OPRobots/DragonBot2/source_code/.features/odometry/odometry_analysis.png

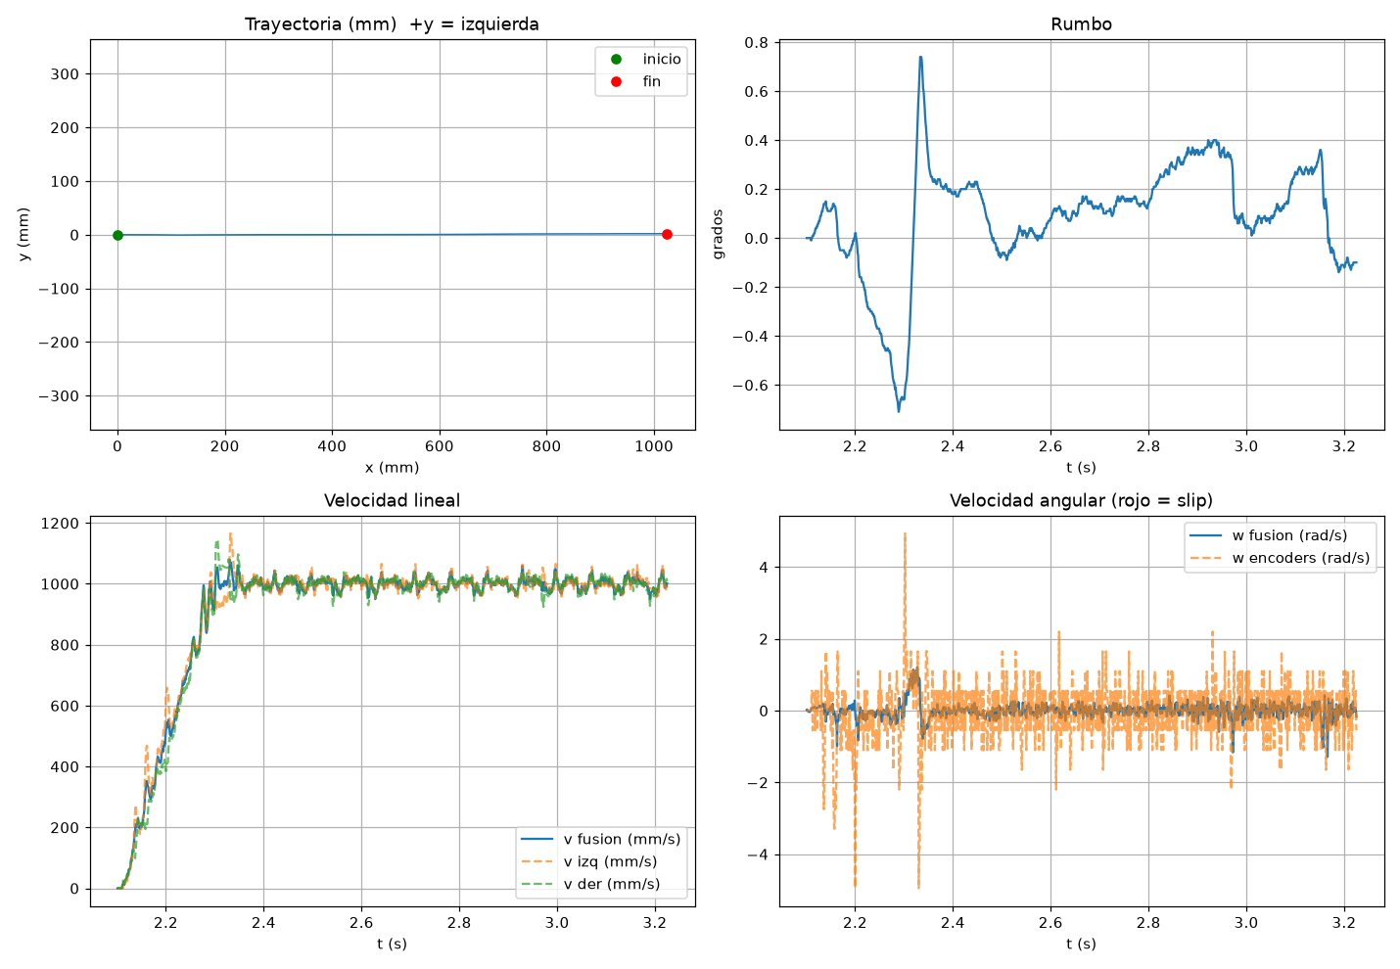
source_code/.features/odometry/odometry_analysis.png
