OPRobots/DragonBot2/pcb_files/kicad_project/main/Main-PCB.dxf

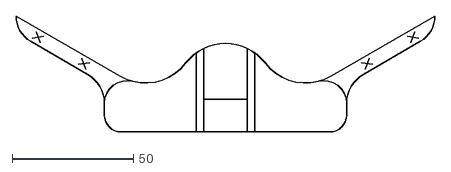
[picture p4: CAD file, 2026-01-10]
pcb_files/kicad_project/main/Main-PCB.dxf
172.8 x 47.7
