OPRobots/DragonBot2/source_code/.features/pid_tuning/calibrate_yaw_step.txt

YAWSTEP,57118,0,0,-0.00255
YAWSTEP,57119,0,0,0.00111
YAWSTEP,57120,0,0,0.00111
YAWSTEP,57121,0,0,-0.00011
YAWSTEP,57122,0,0,0.00111
YAWSTEP,57123,0,0,-0.00011
YAWSTEP,57124,0,0,-0.00011
YAWSTEP,57125,0,0,-0.00011
YAWSTEP,57126,0,0,0.00111
YAWSTEP,57127,0,0,-0.00133
YAWSTEP,57128,0,0,0.00111
YAWSTEP,57129,0,0,-0.00011
YAWSTEP,57130,0,0,0.00233
YAWSTEP,57131,0,0,-0.00011
YAWSTEP,57132,0,0,-0.00011
YAWSTEP,57133,0,0,-0.00011
YAWSTEP,57134,0,0,0.00111
YAWSTEP,57135,0,0,0.00111
YAWSTEP,57136,0,0,-0.00011
YAWSTEP,57137,0,0,-0.00011
YAWSTEP,57138,0,0,-0.00133
YAWSTEP,57139,0,0,-0.00133
YAWSTEP,57140,0,0,-0.00255
YAWSTEP,57141,0,0,-0.00255
YAWSTEP,57142,0,0,-0.00255
YAWSTEP,57143,0,0,-0.00255
YAWSTEP,57144,0,0,0.00111
YAWSTEP,57145,0,0,-0.00255
YAWSTEP,57146,0,0,-0.00011
YAWSTEP,57147,0,0,-0.00011
YAWSTEP,57148,0,0,-0.00011
YAWSTEP,57149,0,0,-0.00011
YAWSTEP,57150,0,0,-0.00011
YAWSTEP,57151,0,0,0.00356
YAWSTEP,57152,0,0,-0.00133
YAWSTEP,57153,0,0,-0.00133
YAWSTEP,57154,0,0,-0.00133
YAWSTEP,57155,0,0,-0.00011
YAWSTEP,57156,0,0,0.00233
YAWSTEP,57157,0,0,-0.00133
YAWSTEP,57158,0,0,-0.00011
YAWSTEP,57159,0,0,0.00233
YAWSTEP,57160,0,0,0.00111
YAWSTEP,57161,0,0,-0.00255
YAWSTEP,57162,0,0,-0.00255
YAWSTEP,57163,0,0,0.00111
YAWSTEP,57164,0,0,-0.00255
YAWSTEP,57165,0,0,-0.00255
YAWSTEP,57166,0,0,-0.00255
YAWSTEP,57167,0,0,0.00233
YAWSTEP,57168,0,100,0.00233
YAWSTEP,57169,0,100,0.00233
YAWSTEP,57170,0,100,0.15260
YAWSTEP,57171,0,100,-0.19069
YAWSTEP,57172,0,100,-0.68182
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
YAWSTEP,60309,2,100,-21.86722
YAWSTEP,60310,2,100,-21.82935
YAWSTEP,60311,2,100,-21.89776
YAWSTEP,60312,2,100,-21.57401
YAWSTEP,60313,2,100,-21.46039
YAWSTEP,60314,2,100,-21.74627
YAWSTEP,60315,2,100,-21.71451
YAWSTEP,60316,2,100,-21.57279
YAWSTEP,60317,2,100,-21.57279
