OPRobots/DragonBot2/source_code/.features/pid_tuning/linear_speed_control_fine_tuning_straight.txt

t=2701,target_linear_speed=2000,ideal_linear_speed=5,measured_linear_speed=0.00,left_measured_linear_speed=0.00,right_measured_linear_speed=0.00,ideal_angular_speed=0.00,measured_angular_speed=-0.04,pwm_left=3,pwm_right=3,battery_voltage=12.32
t=2702,target_linear_speed=2000,ideal_linear_speed=10,measured_linear_speed=0.00,left_measured_linear_speed=0.00,right_measured_linear_speed=0.00,ideal_angular_speed=0.00,measured_angular_speed=0.07,pwm_left=4,pwm_right=4,battery_voltage=12.32
t=2703,target_linear_speed=2000,ideal_linear_speed=15,measured_linear_speed=0.00,left_measured_linear_speed=0.00,right_measured_linear_speed=0.00,ideal_angular_speed=0.00,measured_angular_speed=0.02,pwm_left=6,pwm_right=6,battery_voltage=12.32
t=2704,target_linear_speed=2000,ideal_linear_speed=20,measured_linear_speed=0.00,left_measured_linear_speed=0.00,right_measured_linear_speed=0.00,ideal_angular_speed=0.00,measured_angular_speed=0.02,pwm_left=7,pwm_right=7,battery_voltage=12.32
t=2705,target_linear_speed=2000,ideal_linear_speed=25,measured_linear_speed=0.00,left_measured_linear_speed=0.00,right_measured_linear_speed=0.00,ideal_angular_speed=0.00,measured_angular_speed=0.02,pwm_left=9,pwm_right=9,battery_voltage=12.32
t=2706,target_linear_speed=2000,ideal_linear_speed=30,measured_linear_speed=0.00,left_measured_linear_speed=0.00,right_measured_linear_speed=0.00,ideal_angular_speed=0.00,measured_angular_speed=0.15,pwm_left=11,pwm_right=11,battery_voltage=12.32
t=2707,target_linear_speed=2000,ideal_linear_speed=35,measured_linear_speed=0.00,left_measured_linear_speed=0.00,right_measured_linear_speed=0.00,ideal_angular_speed=0.00,measured_angular_speed=-0.00,pwm_left=13,pwm_right=13,battery_voltage=12.32
t=2708,target_linear_speed=2000,ideal_linear_speed=40,measured_linear_speed=0.00,left_measured_linear_speed=0.00,right_measured_linear_speed=0.00,ideal_angular_speed=0.00,measured_angular_speed=0.01,pwm_left=15,pwm_right=15,battery_voltage=12.32
t=2709,target_linear_speed=2000,ideal_linear_speed=45,measured_linear_speed=0.00,left_measured_linear_speed=0.00,right_measured_linear_speed=0.00,ideal_angular_speed=0.00,measured_angular_speed=-0.10,pwm_left=17,pwm_right=17,battery_voltage=12.32
t=2710,target_linear_speed=2000,ideal_linear_speed=50,measured_linear_speed=0.00,left_measured_linear_speed=0.00,right_measured_linear_speed=0.00,ideal_angular_speed=0.00,measured_angular_speed=0.17,pwm_left=19,pwm_right=19,battery_voltage=12.32
t=2711,target_linear_speed=2000,ideal_linear_speed=55,measured_linear_speed=0.00,left_measured_linear_speed=0.00,right_measured_linear_speed=0.00,ideal_angular_speed=0.00,measured_angular_speed=-0.07,pwm_left=21,pwm_right=21,battery_voltage=12.32
t=2712,target_linear_speed=2000,ideal_linear_speed=60,measured_linear_speed=14.03,left_measured_linear_speed=14.03,right_measured_linear_speed=14.03,ideal_angular_speed=0.00,measured_angular_speed=-0.07,pwm_left=19,pwm_right=19,battery_voltage=12.32
t=2713,target_linear_speed=2000,ideal_linear_speed=65,measured_linear_speed=11.22,left_measured_linear_speed=11.22,right_measured_linear_speed=11.22,ideal_angular_speed=0.00,measured_angular_speed=0.10,pwm_left=22,pwm_right=22,battery_voltage=12.32
t=2714,target_linear_speed=2000,ideal_linear_speed=70,measured_linear_speed=15.99,left_measured_linear_speed=8.98,right_measured_linear_speed=23.01,ideal_angular_speed=0.00,measured_angular_speed=0.00,pwm_left=23,pwm_right=23,battery_voltage=12.32
t=2715,target_linear_speed=2000,ideal_linear_speed=75,measured_linear_speed=12.79,left_measured_linear_speed=7.18,right_measured_linear_speed=18.40,ideal_angular_speed=0.00,measured_angular_speed=0.14,pwm_left=26,pwm_right=26,battery_voltage=12.31
t=2716,target_linear_speed=2000,ideal_linear_speed=80,measured_linear_speed=10.23,left_measured_linear_speed=5.75,right_measured_linear_speed=14.72,ideal_angular_speed=0.00,measured_angular_speed=0.02,pwm_left=30,pwm_right=30,battery_voltage=12.31
t=2717,target_linear_speed=2000,ideal_linear_speed=85,measured_linear_speed=8.19,left_measured_linear_speed=4.60,right_measured_linear_speed=11.78,ideal_angular_speed=0.00,measured_angular_speed=0.05,pwm_left=33,pwm_right=33,battery_voltage=12.31
t=2718,target_linear_speed=2000,ideal_linear_speed=90,measured_linear_speed=13.56,left_measured_linear_speed=17.71,right_measured_linear_speed=9.42,ideal_angular_speed=0.00,measured_angular_speed=0.13,pwm_left=34,pwm_right=34,battery_voltage=12.31
t=2719,target_linear_speed=2000,ideal_linear_speed=95,measured_linear_speed=17.87,left_measured_linear_speed=14.16,right_measured_linear_speed=21.57,ideal_angular_speed=0.00,measured_angular_speed=0.12,pwm_left=35,pwm_right=35,battery_voltage=12.31
t=2720,target_linear_speed=2000,ideal_linear_speed=100,measured_linear_speed=28.32,left_measured_linear_speed=25.36,right_measured_linear_speed=31.28,ideal_angular_speed=0.00,measured_angular_speed=0.12,pwm_left=35,pwm_right=35,battery_voltage=12.31
t=2721,target_linear_speed=2000,ideal_linear_speed=105,measured_linear_speed=22.66,left_measured_linear_speed=20.29,right_measured_linear_speed=25.03,ideal_angular_speed=0.00,measured_angular_speed=-0.06,pwm_left=39,pwm_right=39,battery_voltage=12.31
t=2722,target_linear_speed=2000,ideal_linear_speed=110,measured_linear_speed=18.13,left_measured_linear_speed=16.23,right_measured_linear_speed=20.02,ideal_angular_speed=0.00,measured_angular_speed=0.00,pwm_left=43,pwm_right=43,battery_voltage=12.31
t=2723,target_linear_speed=2000,ideal_linear_speed=115,measured_linear_speed=28.53,left_measured_linear_speed=27.01,right_measured_linear_speed=30.04,ideal_angular_speed=0.00,measured_angular_speed=0.22,pwm_left=44,pwm_right=44,battery_voltage=12.30
t=2724,target_linear_speed=2000,ideal_linear_speed=120,measured_linear_speed=36.85,left_measured_linear_speed=35.64,right_measured_linear_speed=38.06,ideal_angular_speed=0.00,measured_angular_speed=-0.15,pwm_left=44,pwm_right=44,battery_voltage=12.30
t=2725,target_linear_speed=2000,ideal_linear_speed=125,measured_linear_speed=43.51,left_measured_linear_speed=42.54,right_measured_linear_speed=44.48,ideal_angular_speed=0.00,measured_angular_speed=0.06,pwm_left=45,pwm_right=45,battery_voltage=12.30
t=2726,target_linear_speed=2000,ideal_linear_speed=130,measured_linear_speed=41.82,left_measured_linear_speed=48.06,right_measured_linear_speed=35.58,ideal_angular_speed=0.00,measured_angular_speed=-0.07,pwm_left=48,pwm_right=48,battery_voltage=12.30
t=2727,target_linear_speed=2000,ideal_linear_speed=135,measured_linear_speed=40.47,left_measured_linear_speed=38.45,right_measured_linear_speed=42.49,ideal_angular_speed=0.00,measured_angular_speed=-0.07,pwm_left=52,pwm_right=52,battery_voltage=12.30
t=2728,target_linear_speed=2000,ideal_linear_speed=140,measured_linear_speed=53.42,left_measured_linear_speed=58.81,right_measured_linear_speed=48.02,ideal_angular_speed=0.00,measured_angular_speed=0.09,pwm_left=51,pwm_right=51,battery_voltage=12.30
t=2729,target_linear_speed=2000,ideal_linear_speed=145,measured_linear_speed=56.76,left_measured_linear_speed=61.08,right_measured_linear_speed=52.45,ideal_angular_speed=0.00,measured_angular_speed=-0.21,pwm_left=53,pwm_right=53,battery_voltage=12.29
t=2730,target_linear_speed=2000,ideal_linear_speed=150,measured_linear_speed=59.44,left_measured_linear_speed=62.89,right_measured_linear_speed=55.99,ideal_angular_speed=0.00,measured_angular_speed=-0.02,pwm_left=55,pwm_right=55,battery_voltage=12.29
t=2731,target_linear_speed=2000,ideal_linear_speed=155,measured_linear_speed=61.58,left_measured_linear_speed=64.34,right_measured_linear_speed=58.82,ideal_angular_speed=0.00,measured_angular_speed=-0.22,pwm_left=57,pwm_right=57,battery_voltage=12.29
t=2732,target_linear_speed=2000,ideal_linear_speed=160,measured_linear_speed=70.30,left_measured_linear_speed=65.50,right_measured_linear_speed=75.11,ideal_angular_speed=0.00,measured_angular_speed=-0.07,pwm_left=58,pwm_right=58,battery_voltage=12.29
t=2733,target_linear_speed=2000,ideal_linear_speed=165,measured_linear_speed=77.29,left_measured_linear_speed=80.46,right_measured_linear_speed=74.12,ideal_angular_speed=0.00,measured_angular_speed=-0.15,pwm_left=59,pwm_right=59,battery_voltage=12.29
t=2734,target_linear_speed=2000,ideal_linear_speed=170,measured_linear_speed=75.86,left_measured_linear_speed=78.39,right_measured_linear_speed=73.32,ideal_angular_speed=0.00,measured_angular_speed=0.01,pwm_left=62,pwm_right=62,battery_voltage=12.28
t=2735,target_linear_speed=2000,ideal_linear_speed=175,measured_linear_speed=81.73,left_measured_linear_speed=90.77,right_measured_linear_speed=72.68,ideal_angular_speed=0.00,measured_angular_speed=0.01,pwm_left=64,pwm_right=64,battery_voltage=12.28
t=2736,target_linear_speed=2000,ideal_linear_speed=180,measured_linear_speed=93.44,left_measured_linear_speed=100.67,right_measured_linear_speed=86.20,ideal_angular_speed=0.00,measured_angular_speed=-0.10,pwm_left=63,pwm_right=63,battery_voltage=12.28
t=2737,target_linear_speed=2000,ideal_linear_speed=185,measured_linear_speed=102.81,left_measured_linear_speed=108.59,right_measured_linear_speed=97.02,ideal_angular_speed=0.00,measured_angular_speed=-0.39,pwm_left=64,pwm_right=64,battery_voltage=12.28
t=2738,target_linear_speed=2000,ideal_linear_speed=190,measured_linear_speed=103.29,left_measured_linear_speed=100.90,right_measured_linear_speed=105.67,ideal_angular_speed=0.00,measured_angular_speed=-0.00,pwm_left=66,pwm_right=66,battery_voltage=12.27
t=2739,target_linear_speed=2000,ideal_linear_speed=195,measured_linear_speed=117.70,left_measured_linear_speed=122.81,right_measured_linear_speed=112.59,ideal_angular_speed=0.00,measured_angular_speed=-0.12,pwm_left=65,pwm_right=65,battery_voltage=12.27
t=2740,target_linear_speed=2000,ideal_linear_speed=200,measured_linear_speed=122.22,left_measured_linear_speed=126.30,right_measured_linear_speed=118.13,ideal_angular_speed=0.00,measured_angular_speed=0.31,pwm_left=67,pwm_right=67,battery_voltage=12.27
t=2741,target_linear_speed=2000,ideal_linear_speed=205,measured_linear_speed=125.83,left_measured_linear_speed=129.10,right_measured_linear_speed=122.56,ideal_angular_speed=0.00,measured_angular_speed=-0.27,pwm_left=68,pwm_right=68,battery_voltage=12.27
t=2742,target_linear_speed=2000,ideal_linear_speed=210,measured_linear_speed=135.73,left_measured_linear_speed=131.33,right_measured_linear_speed=140.13,ideal_angular_speed=0.00,measured_angular_speed=-0.27,pwm_left=68,pwm_right=68,battery_voltage=12.27
t=2743,target_linear_speed=2000,ideal_linear_speed=215,measured_linear_speed=143.66,left_measured_linear_speed=147.15,right_measured_linear_speed=140.16,ideal_angular_speed=0.00,measured_angular_speed=-0.04,pwm_left=69,pwm_right=69,battery_voltage=12.26
t=2744,target_linear_speed=2000,ideal_linear_speed=220,measured_linear_speed=157.01,left_measured_linear_speed=159.80,right_measured_linear_speed=154.21,ideal_angular_speed=0.00,measured_angular_speed=-0.23,pwm_left=68,pwm_right=68,battery_voltage=12.26
t=2745,target_linear_speed=2000,ideal_linear_speed=225,measured_linear_speed=160.68,left_measured_linear_speed=155.90,right_measured_linear_speed=165.45,ideal_angular_speed=0.00,measured_angular_speed=-0.11,pwm_left=69,pwm_right=69,battery_voltage=12.26
t=2746,target_linear_speed=2000,ideal_linear_speed=230,measured_linear_speed=163.61,left_measured_linear_speed=166.80,right_measured_linear_speed=160.42,ideal_angular_speed=0.00,measured_angular_speed=-0.16,pwm_left=71,pwm_right=71,battery_voltage=12.25
t=2747,target_linear_speed=2000,ideal_linear_speed=235,measured_linear_speed=179.99,left_measured_linear_speed=175.53,right_measured_linear_speed=184.45,ideal_angular_speed=0.00,measured_angular_speed=0.05,pwm_left=69,pwm_right=69,battery_voltage=12.25
t=2748,target_linear_speed=2000,ideal_linear_speed=240,measured_linear_speed=179.06,left_measured_linear_speed=182.51,right_measured_linear_speed=175.61,ideal_angular_speed=0.00,measured_angular_speed=-0.09,pwm_left=72,pwm_right=72,battery_voltage=12.25
t=2749,target_linear_speed=2000,ideal_linear_speed=245,measured_linear_speed=192.35,left_measured_linear_speed=188.09,right_measured_linear_speed=196.60,ideal_angular_speed=0.00,measured_angular_speed=-0.36,pwm_left=70,pwm_right=70,battery_voltage=12.25
t=2750,target_linear_speed=2000,ideal_linear_speed=250,measured_linear_speed=195.96,left_measured_linear_speed=192.55,right_measured_linear_speed=199.37,ideal_angular_speed=0.00,measured_angular_speed=-0.36,pwm_left=72,pwm_right=72,battery_voltage=12.25
t=2751,target_linear_speed=2000,ideal_linear_speed=255,measured_linear_speed=205.87,left_measured_linear_speed=210.16,right_measured_linear_speed=201.58,ideal_angular_speed=0.00,measured_angular_speed=0.04,pwm_left=71,pwm_right=71,battery_voltage=12.25
t=2752,target_linear_speed=2000,ideal_linear_speed=260,measured_linear_speed=206.78,left_measured_linear_speed=210.21,right_measured_linear_speed=203.35,ideal_angular_speed=0.00,measured_angular_speed=-0.01,pwm_left=73,pwm_right=73,battery_voltage=12.25
t=2753,target_linear_speed=2000,ideal_linear_speed=265,measured_linear_speed=221.53,left_measured_linear_speed=224.28,right_measured_linear_speed=218.79,ideal_angular_speed=0.00,measured_angular_speed=0.31,pwm_left=72,pwm_right=72,battery_voltage=12.25
t=2754,target_linear_speed=2000,ideal_linear_speed=270,measured_linear_speed=226.33,left_measured_linear_speed=235.54,right_measured_linear_speed=217.11,ideal_angular_speed=0.00,measured_angular_speed=-0.27,pwm_left=72,pwm_right=72,battery_voltage=12.25
t=2755,target_linear_speed=2000,ideal_linear_speed=275,measured_linear_speed=237.17,left_measured_linear_speed=230.51,right_measured_linear_speed=243.83,ideal_angular_speed=0.00,measured_angular_speed=0.03,pwm_left=71,pwm_right=71,battery_voltage=12.25
t=2756,target_linear_speed=2000,ideal_linear_speed=280,measured_linear_speed=238.84,left_measured_linear_speed=240.52,right_measured_linear_speed=237.15,ideal_angular_speed=0.00,measured_angular_speed=-0.38,pwm_left=73,pwm_right=73,battery_voltage=12.24
t=2757,target_linear_speed=2000,ideal_linear_speed=285,measured_linear_speed=254.19,left_measured_linear_speed=248.53,right_measured_linear_speed=259.86,ideal_angular_speed=0.00,measured_angular_speed=-0.38,pwm_left=71,pwm_right=71,battery_voltage=12.24
t=2758,target_linear_speed=2000,ideal_linear_speed=290,measured_linear_speed=266.48,left_measured_linear_speed=268.96,right_measured_linear_speed=264.00,ideal_angular_speed=0.00,measured_angular_speed=0.25,pwm_left=69,pwm_right=69,battery_voltage=12.24
t=2759,target_linear_speed=2000,ideal_linear_speed=295,measured_linear_speed=255.27,left_measured_linear_speed=243.23,right_measured_linear_speed=267.31,ideal_angular_speed=0.00,measured_angular_speed=0.01,pwm_left=74,pwm_right=74,battery_voltage=12.24
t=2760,target_linear_speed=2000,ideal_linear_speed=300,measured_linear_speed=274.36,left_measured_linear_speed=278.75,right_measured_linear_speed=269.96,ideal_angular_speed=0.00,measured_angular_speed=-0.18,pwm_left=71,pwm_right=71,battery_voltage=12.24
t=2761,target_linear_speed=2000,ideal_linear_speed=305,measured_linear_speed=282.61,left_measured_linear_speed=279.11,right_measured_linear_speed=286.11,ideal_angular_speed=0.00,measured_angular_speed=-0.23,pwm_left=71,pwm_right=71,battery_voltage=12.24
t=2762,target_linear_speed=2000,ideal_linear_speed=310,measured_linear_speed=296.23,left_measured_linear_speed=293.43,right_measured_linear_speed=299.03,ideal_angular_speed=0.00,measured_angular_speed=-0.22,pwm_left=69,pwm_right=69,battery_voltage=12.24
t=2763,target_linear_speed=2000,ideal_linear_speed=315,measured_linear_speed=293.09,left_measured_linear_speed=290.86,right_measured_linear_speed=295.33,ideal_angular_speed=0.00,measured_angular_speed=0.36,pwm_left=71,pwm_right=71,battery_voltage=12.24
t=2764,target_linear_speed=2000,ideal_linear_speed=320,measured_linear_speed=304.62,left_measured_linear_speed=302.82,right_measured_linear_speed=306.41,ideal_angular_speed=0.00,measured_angular_speed=0.36,pwm_left=70,pwm_right=70,battery_voltage=12.24
t=2765,target_linear_speed=2000,ideal_linear_speed=325,measured_linear_speed=299.80,left_measured_linear_speed=298.37,right_measured_linear_speed=301.24,ideal_angular_speed=0.00,measured_angular_speed=-0.38,pwm_left=73,pwm_right=73,battery_voltage=12.24
t=2766,target_linear_speed=2000,ideal_linear_speed=330,measured_linear_speed=317.00,left_measured_linear_speed=308.84,right_measured_linear_speed=325.16,ideal_angular_speed=0.00,measured_angular_speed=-0.01,pwm_left=70,pwm_right=70,battery_voltage=12.24
t=2767,target_linear_speed=2000,ideal_linear_speed=335,measured_linear_speed=323.74,left_measured_linear_speed=331.24,right_measured_linear_speed=316.24,ideal_angular_speed=0.00,measured_angular_speed=-0.32,pwm_left=70,pwm_right=70,battery_voltage=12.25
t=2768,target_linear_speed=2000,ideal_linear_speed=340,measured_linear_speed=322.12,left_measured_linear_speed=321.10,right_measured_linear_speed=323.13,ideal_angular_speed=0.00,measured_angular_speed=0.04,pwm_left=72,pwm_right=72,battery_voltage=12.24
t=2769,target_linear_speed=2000,ideal_linear_speed=345,measured_linear_speed=334.85,left_measured_linear_speed=341.05,right_measured_linear_speed=328.64,ideal_angular_speed=0.00,measured_angular_speed=-0.03,pwm_left=70,pwm_right=70,battery_voltage=12.24
t=2770,target_linear_speed=2000,ideal_linear_speed=350,measured_linear_speed=338.02,left_measured_linear_speed=342.98,right_measured_linear_speed=333.06,ideal_angular_speed=0.00,measured_angular_speed=0.34,pwm_left=70,pwm_right=70,battery_voltage=12.25
t=2771,target_linear_speed=2000,ideal_linear_speed=355,measured_linear_speed=347.57,left_measured_linear_speed=358.55,right_measured_linear_speed=336.58,ideal_angular_speed=0.00,measured_angular_speed=-0.17,pwm_left=69,pwm_right=69,battery_voltage=12.24
t=2772,target_linear_speed=2000,ideal_linear_speed=360,measured_linear_speed=362.22,left_measured_linear_speed=371.01,right_measured_linear_speed=353.44,ideal_angular_speed=0.00,measured_angular_speed=-0.17,pwm_left=67,pwm_right=67,battery_voltage=12.24
t=2773,target_linear_speed=2000,ideal_linear_speed=365,measured_linear_speed=373.95,left_measured_linear_speed=380.98,right_measured_linear_speed=366.92,ideal_angular_speed=0.00,measured_angular_speed=-0.34,pwm_left=65,pwm_right=65,battery_voltage=12.24
t=2774,target_linear_speed=2000,ideal_linear_speed=370,measured_linear_speed=369.30,left_measured_linear_speed=374.92,right_measured_linear_speed=363.67,ideal_angular_speed=0.00,measured_angular_speed=0.15,pwm_left=67,pwm_right=67,battery_voltage=12.24
t=2775,target_linear_speed=2000,ideal_linear_speed=375,measured_linear_speed=379.61,left_measured_linear_speed=384.10,right_measured_linear_speed=375.11,ideal_angular_speed=0.00,measured_angular_speed=-0.18,pwm_left=66,pwm_right=66,battery_voltage=12.24
t=2776,target_linear_speed=2000,ideal_linear_speed=380,measured_linear_speed=380.84,left_measured_linear_speed=391.45,right_measured_linear_speed=370.23,ideal_angular_speed=0.00,measured_angular_speed=0.13,pwm_left=67,pwm_right=67,battery_voltage=12.25
t=2777,target_linear_speed=2000,ideal_linear_speed=385,measured_linear_speed=388.84,left_measured_linear_speed=397.33,right_measured_linear_speed=380.35,ideal_angular_speed=0.00,measured_angular_speed=-0.48,pwm_left=66,pwm_right=66,battery_voltage=12.25
t=2778,target_linear_speed=2000,ideal_linear_speed=390,measured_linear_speed=381.21,left_measured_linear_speed=402.03,right_measured_linear_speed=360.39,ideal_angular_speed=0.00,measured_angular_speed=-0.13,pwm_left=69,pwm_right=69,battery_voltage=12.25
t=2779,target_linear_speed=2000,ideal_linear_speed=395,measured_linear_speed=403.16,left_measured_linear_speed=419.82,right_measured_linear_speed=386.51,ideal_angular_speed=0.00,measured_angular_speed=-0.13,pwm_left=65,pwm_right=65,battery_voltage=12.25
t=2780,target_linear_speed=2000,ideal_linear_speed=400,measured_linear_speed=392.67,left_measured_linear_speed=406.00,right_measured_linear_speed=379.35,ideal_angular_speed=0.00,measured_angular_speed=-0.34,pwm_left=69,pwm_right=69,battery_voltage=12.25
t=2781,target_linear_speed=2000,ideal_linear_speed=405,measured_linear_speed=398.31,left_measured_linear_speed=408.97,right_measured_linear_speed=387.65,ideal_angular_speed=0.00,measured_angular_speed=0.09,pwm_left=69,pwm_right=69,battery_voltage=12.25
t=2782,target_linear_speed=2000,ideal_linear_speed=410,measured_linear_speed=402.81,left_measured_linear_speed=411.34,right_measured_linear_speed=394.28,ideal_angular_speed=0.00,measured_angular_speed=-0.40,pwm_left=69,pwm_right=69,battery_voltage=12.25
t=2783,target_linear_speed=2000,ideal_linear_speed=415,measured_linear_speed=413.43,left_measured_linear_speed=427.27,right_measured_linear_speed=399.60,ideal_angular_speed=0.00,measured_angular_speed=-0.02,pwm_left=68,pwm_right=68,battery_voltage=12.25
t=2784,target_linear_speed=2000,ideal_linear_speed=420,measured_linear_speed=421.93,left_measured_linear_speed=440.01,right_measured_linear_speed=403.84,ideal_angular_speed=0.00,measured_angular_speed=-0.12,pwm_left=67,pwm_right=67,battery_voltage=12.25
t=2785,target_linear_speed=2000,ideal_linear_speed=425,measured_linear_speed=421.71,left_measured_linear_speed=436.18,right_measured_linear_speed=407.24,ideal_angular_speed=0.00,measured_angular_speed=-0.17,pwm_left=68,pwm_right=68,battery_voltage=12.25
t=2786,target_linear_speed=2000,ideal_linear_speed=430,measured_linear_speed=428.55,left_measured_linear_speed=447.14,right_measured_linear_speed=409.96,ideal_angular_speed=0.00,measured_angular_speed=0.41,pwm_left=68,pwm_right=68,battery_voltage=12.25
t=2787,target_linear_speed=2000,ideal_linear_speed=435,measured_linear_speed=434.02,left_measured_linear_speed=441.88,right_measured_linear_speed=426.17,ideal_angular_speed=0.00,measured_angular_speed=0.41,pwm_left=68,pwm_right=68,battery_voltage=12.25
t=2788,target_linear_speed=2000,ideal_linear_speed=440,measured_linear_speed=445.41,left_measured_linear_speed=465.73,right_measured_linear_speed=425.10,ideal_angular_speed=0.00,measured_angular_speed=-0.46,pwm_left=66,pwm_right=66,battery_voltage=12.25
t=2789,target_linear_speed=2000,ideal_linear_speed=445,measured_linear_speed=447.51,left_measured_linear_speed=456.75,right_measured_linear_speed=438.28,ideal_angular_speed=0.00,measured_angular_speed=-0.21,pwm_left=67,pwm_right=67,battery_voltage=12.25
t=2790,target_linear_speed=2000,ideal_linear_speed=450,measured_linear_speed=449.19,left_measured_linear_speed=463.60,right_measured_linear_speed=434.79,ideal_angular_speed=0.00,measured_angular_speed=-0.63,pwm_left=68,pwm_right=68,battery_voltage=12.25
t=2791,target_linear_speed=2000,ideal_linear_speed=455,measured_linear_speed=450.54,left_measured_linear_speed=455.04,right_measured_linear_speed=446.03,ideal_angular_speed=0.00,measured_angular_speed=-0.05,pwm_left=69,pwm_right=69,battery_voltage=12.25
t=2792,target_linear_speed=2000,ideal_linear_speed=460,measured_linear_speed=458.62,left_measured_linear_speed=462.23,right_measured_linear_speed=455.02,ideal_angular_speed=0.00,measured_angular_speed=-0.26,pwm_left=68,pwm_right=68,battery_voltage=12.25
t=2793,target_linear_speed=2000,ideal_linear_speed=465,measured_linear_speed=465.10,left_measured_linear_speed=467.98,right_measured_linear_speed=462.21,ideal_angular_speed=0.00,measured_angular_speed=0.18,pwm_left=67,pwm_right=67,battery_voltage=12.25
t=2794,target_linear_speed=2000,ideal_linear_speed=470,measured_linear_speed=477.29,left_measured_linear_speed=472.58,right_measured_linear_speed=481.99,ideal_angular_speed=0.00,measured_angular_speed=0.18,pwm_left=66,pwm_right=66,battery_voltage=12.25
t=2795,target_linear_speed=2000,ideal_linear_speed=475,measured_linear_speed=487.04,left_measured_linear_speed=476.26,right_measured_linear_speed=497.82,ideal_angular_speed=0.00,measured_angular_speed=0.47,pwm_left=64,pwm_right=64,battery_voltage=12.25
t=2796,target_linear_speed=2000,ideal_linear_speed=480,measured_linear_speed=494.84,left_measured_linear_speed=493.23,right_measured_linear_speed=496.45,ideal_angular_speed=0.00,measured_angular_speed=-0.55,pwm_left=63,pwm_right=63,battery_voltage=12.25
t=2797,target_linear_speed=2000,ideal_linear_speed=485,measured_linear_speed=508.10,left_measured_linear_speed=506.81,right_measured_linear_speed=509.38,ideal_angular_speed=0.00,measured_angular_speed=0.33,pwm_left=61,pwm_right=61,battery_voltage=12.25
t=2798,target_linear_speed=2000,ideal_linear_speed=490,measured_linear_speed=497.66,left_measured_linear_speed=503.64,right_measured_linear_speed=491.68,ideal_angular_speed=0.00,measured_angular_speed=0.10,pwm_left=64,pwm_right=64,battery_voltage=12.25
t=2799,target_linear_speed=2000,ideal_linear_speed=495,measured_linear_speed=503.34,left_measured_linear_speed=501.11,right_measured_linear_speed=505.56,ideal_angular_speed=0.00,measured_angular_speed=0.47,pwm_left=64,pwm_right=64,battery_voltage=12.25
t=2800,target_linear_speed=2000,ideal_linear_speed=500,measured_linear_speed=514.89,left_measured_linear_speed=513.11,right_measured_linear_speed=516.68,ideal_angular_speed=0.00,measured_angular_speed=-0.13,pwm_left=62,pwm_right=62,battery_voltage=12.25
t=2801,target_linear_speed=2000,ideal_linear_speed=505,measured_linear_speed=503.10,left_measured_linear_speed=494.66,right_measured_linear_speed=511.54,ideal_angular_speed=0.00,measured_angular_speed=0.29,pwm_left=67,pwm_right=67,battery_voltage=12.25
t=2802,target_linear_speed=2000,ideal_linear_speed=510,measured_linear_speed=514.70,left_measured_linear_speed=521.98,right_measured_linear_speed=507.43,ideal_angular_speed=0.00,measured_angular_speed=0.29,pwm_left=65,pwm_right=65,battery_voltage=12.25
t=2803,target_linear_speed=2000,ideal_linear_speed=515,measured_linear_speed=516.97,left_measured_linear_speed=515.78,right_measured_linear_speed=518.16,ideal_angular_speed=0.00,measured_angular_speed=0.25,pwm_left=65,pwm_right=65,battery_voltage=12.25
t=2804,target_linear_speed=2000,ideal_linear_speed=520,measured_linear_speed=525.80,left_measured_linear_speed=524.85,right_measured_linear_speed=526.76,ideal_angular_speed=0.00,measured_angular_speed=0.31,pwm_left=64,pwm_right=64,battery_voltage=12.25
t=2805,target_linear_speed=2000,ideal_linear_speed=525,measured_linear_speed=532.86,left_measured_linear_speed=532.10,right_measured_linear_speed=533.63,ideal_angular_speed=0.00,measured_angular_speed=0.04,pwm_left=64,pwm_right=64,battery_voltage=12.25
t=2806,target_linear_speed=2000,ideal_linear_speed=530,measured_linear_speed=531.50,left_measured_linear_speed=537.91,right_measured_linear_speed=525.10,ideal_angular_speed=0.00,measured_angular_speed=-0.14,pwm_left=65,pwm_right=65,battery_voltage=12.25
t=2807,target_linear_speed=2000,ideal_linear_speed=535,measured_linear_speed=530.41,left_measured_linear_speed=528.52,right_measured_linear_speed=532.30,ideal_angular_speed=0.00,measured_angular_speed=0.44,pwm_left=67,pwm_right=67,battery_voltage=12.25
t=2808,target_linear_speed=2000,ideal_linear_speed=540,measured_linear_speed=529.54,left_measured_linear_speed=535.04,right_measured_linear_speed=524.04,ideal_angular_speed=0.00,measured_angular_speed=-0.38,pwm_left=69,pwm_right=69,battery_voltage=12.26
t=2809,target_linear_speed=2000,ideal_linear_speed=545,measured_linear_speed=542.87,left_measured_linear_speed=540.26,right_measured_linear_speed=545.48,ideal_angular_speed=0.00,measured_angular_speed=-0.38,pwm_left=66,pwm_right=66,battery_voltage=12.26
t=2810,target_linear_speed=2000,ideal_linear_speed=550,measured_linear_speed=546.52,left_measured_linear_speed=558.46,right_measured_linear_speed=534.58,ideal_angular_speed=0.00,measured_angular_speed=0.18,pwm_left=67,pwm_right=67,battery_voltage=12.26
t=2811,target_linear_speed=2000,ideal_linear_speed=555,measured_linear_speed=549.44,left_measured_linear_speed=544.96,right_measured_linear_speed=553.92,ideal_angular_speed=0.00,measured_angular_speed=-0.09,pwm_left=68,pwm_right=68,battery_voltage=12.26
t=2812,target_linear_speed=2000,ideal_linear_speed=560,measured_linear_speed=558.79,left_measured_linear_speed=576.25,right_measured_linear_speed=541.33,ideal_angular_speed=0.00,measured_angular_speed=0.12,pwm_left=66,pwm_right=66,battery_voltage=12.26
t=2813,target_linear_speed=2000,ideal_linear_speed=565,measured_linear_speed=559.26,left_measured_linear_speed=559.20,right_measured_linear_speed=559.32,ideal_angular_speed=0.00,measured_angular_speed=-0.19,pwm_left=68,pwm_right=68,battery_voltage=12.25
t=2814,target_linear_speed=2000,ideal_linear_speed=570,measured_linear_speed=559.63,left_measured_linear_speed=573.61,right_measured_linear_speed=545.65,ideal_angular_speed=0.00,measured_angular_speed=-0.14,pwm_left=69,pwm_right=69,battery_voltage=12.25
t=2815,target_linear_speed=2000,ideal_linear_speed=575,measured_linear_speed=559.93,left_measured_linear_speed=557.08,right_measured_linear_speed=562.77,ideal_angular_speed=0.00,measured_angular_speed=-0.13,pwm_left=71,pwm_right=71,battery_voltage=12.25
t=2816,target_linear_speed=2000,ideal_linear_speed=580,measured_linear_speed=553.15,left_measured_linear_speed=557.89,right_measured_linear_speed=548.41,ideal_angular_speed=0.00,measured_angular_speed=-0.47,pwm_left=74,pwm_right=74,battery_voltage=12.25
t=2817,target_linear_speed=2000,ideal_linear_speed=585,measured_linear_speed=561.76,left_measured_linear_speed=558.54,right_measured_linear_speed=564.98,ideal_angular_speed=0.00,measured_angular_speed=-0.47,pwm_left=73,pwm_right=73,battery_voltage=12.25
t=2818,target_linear_speed=2000,ideal_linear_speed=590,measured_linear_speed=561.63,left_measured_linear_speed=559.05,right_measured_linear_speed=564.21,ideal_angular_speed=0.00,measured_angular_speed=0.31,pwm_left=75,pwm_right=75,battery_voltage=12.25
t=2819,target_linear_speed=2000,ideal_linear_speed=595,measured_linear_speed=568.54,left_measured_linear_speed=573.49,right_measured_linear_speed=563.59,ideal_angular_speed=0.00,measured_angular_speed=-0.10,pwm_left=75,pwm_right=75,battery_voltage=12.25
t=2820,target_linear_speed=2000,ideal_linear_speed=600,measured_linear_speed=574.07,left_measured_linear_speed=556.99,right_measured_linear_speed=591.15,ideal_angular_speed=0.00,measured_angular_speed=0.15,pwm_left=76,pwm_right=76,battery_voltage=12.25
t=2821,target_linear_speed=2000,ideal_linear_speed=605,measured_linear_speed=571.48,left_measured_linear_speed=557.82,right_measured_linear_speed=585.15,ideal_angular_speed=0.00,measured_angular_speed=-0.09,pwm_left=78,pwm_right=78,battery_voltage=12.25
t=2822,target_linear_speed=2000,ideal_linear_speed=610,measured_linear_speed=583.44,left_measured_linear_speed=558.48,right_measured_linear_speed=608.40,ideal_angular_speed=0.00,measured_angular_speed=0.10,pwm_left=77,pwm_right=77,battery_voltage=12.24
t=2823,target_linear_speed=2000,ideal_linear_speed=615,measured_linear_speed=585.99,left_measured_linear_speed=573.03,right_measured_linear_speed=598.94,ideal_angular_speed=0.00,measured_angular_speed=0.40,pwm_left=78,pwm_right=78,battery_voltage=12.24
t=2824,target_linear_speed=2000,ideal_linear_speed=620,measured_linear_speed=595.04,left_measured_linear_speed=584.68,right_measured_linear_speed=605.41,ideal_angular_speed=0.00,measured_angular_speed=0.40,pwm_left=77,pwm_right=77,battery_voltage=12.24
t=2825,target_linear_speed=2000,ideal_linear_speed=625,measured_linear_speed=595.27,left_measured_linear_speed=594.00,right_measured_linear_speed=596.55,ideal_angular_speed=0.00,measured_angular_speed=-0.22,pwm_left=79,pwm_right=79,battery_voltage=12.24
t=2826,target_linear_speed=2000,ideal_linear_speed=630,measured_linear_speed=609.48,left_measured_linear_speed=587.42,right_measured_linear_speed=631.55,ideal_angular_speed=0.00,measured_angular_speed=0.10,pwm_left=77,pwm_right=77,battery_voltage=12.24
t=2827,target_linear_speed=2000,ideal_linear_speed=635,measured_linear_speed=613.84,left_measured_linear_speed=610.22,right_measured_linear_speed=617.46,ideal_angular_speed=0.00,measured_angular_speed=0.17,pwm_left=78,pwm_right=78,battery_voltage=12.24
t=2828,target_linear_speed=2000,ideal_linear_speed=640,measured_linear_speed=624.34,left_measured_linear_speed=600.40,right_measured_linear_speed=648.28,ideal_angular_speed=0.00,measured_angular_speed=0.79,pwm_left=76,pwm_right=76,battery_voltage=12.24
t=2829,target_linear_speed=2000,ideal_linear_speed=645,measured_linear_speed=611.69,left_measured_linear_speed=606.57,right_measured_linear_speed=616.82,ideal_angular_speed=0.00,measured_angular_speed=0.30,pwm_left=82,pwm_right=82,battery_voltage=12.24
t=2830,target_linear_speed=2000,ideal_linear_speed=650,measured_linear_speed=629.64,left_measured_linear_speed=611.51,right_measured_linear_speed=647.76,ideal_angular_speed=0.00,measured_angular_speed=0.11,pwm_left=79,pwm_right=79,battery_voltage=12.24
t=2831,target_linear_speed=2000,ideal_linear_speed=655,measured_linear_speed=629.96,left_measured_linear_speed=629.49,right_measured_linear_speed=630.43,ideal_angular_speed=0.00,measured_angular_speed=0.11,pwm_left=80,pwm_right=80,battery_voltage=12.24
t=2832,target_linear_speed=2000,ideal_linear_speed=660,measured_linear_speed=637.23,left_measured_linear_speed=615.81,right_measured_linear_speed=658.66,ideal_angular_speed=0.00,measured_angular_speed=0.23,pwm_left=80,pwm_right=80,battery_voltage=12.24
t=2833,target_linear_speed=2000,ideal_linear_speed=665,measured_linear_speed=629.03,left_measured_linear_speed=618.90,right_measured_linear_speed=639.15,ideal_angular_speed=0.00,measured_angular_speed=0.46,pwm_left=84,pwm_right=84,battery_voltage=12.24
t=2834,target_linear_speed=2000,ideal_linear_speed=670,measured_linear_speed=650.51,left_measured_linear_speed=635.40,right_measured_linear_speed=665.63,ideal_angular_speed=0.00,measured_angular_speed=0.57,pwm_left=80,pwm_right=80,battery_voltage=12.24
t=2835,target_linear_speed=2000,ideal_linear_speed=675,measured_linear_speed=646.66,left_measured_linear_speed=634.57,right_measured_linear_speed=658.75,ideal_angular_speed=0.00,measured_angular_speed=-0.03,pwm_left=83,pwm_right=83,battery_voltage=12.24
t=2836,target_linear_speed=2000,ideal_linear_speed=680,measured_linear_speed=664.62,left_measured_linear_speed=647.94,right_measured_linear_speed=681.31,ideal_angular_speed=0.00,measured_angular_speed=0.56,pwm_left=80,pwm_right=80,battery_voltage=12.24
t=2837,target_linear_speed=2000,ideal_linear_speed=685,measured_linear_speed=664.97,left_measured_linear_speed=658.63,right_measured_linear_speed=671.30,ideal_angular_speed=0.00,measured_angular_speed=0.12,pwm_left=81,pwm_right=81,battery_voltage=12.23
t=2838,target_linear_speed=2000,ideal_linear_speed=690,measured_linear_speed=658.22,left_measured_linear_speed=639.13,right_measured_linear_speed=677.32,ideal_angular_speed=0.00,measured_angular_speed=0.50,pwm_left=85,pwm_right=85,battery_voltage=12.24
t=2839,target_linear_speed=2000,ideal_linear_speed=695,measured_linear_speed=673.87,left_measured_linear_speed=651.58,right_measured_linear_speed=696.16,ideal_angular_speed=0.00,measured_angular_speed=0.50,pwm_left=83,pwm_right=83,battery_voltage=12.23
t=2840,target_linear_speed=2000,ideal_linear_speed=700,measured_linear_speed=686.39,left_measured_linear_speed=661.55,right_measured_linear_speed=711.24,ideal_angular_speed=0.00,measured_angular_speed=0.34,pwm_left=81,pwm_right=81,battery_voltage=12.23
t=2841,target_linear_speed=2000,ideal_linear_speed=705,measured_linear_speed=689.39,left_measured_linear_speed=683.55,right_measured_linear_speed=695.24,ideal_angular_speed=0.00,measured_angular_speed=0.39,pwm_left=82,pwm_right=82,battery_voltage=12.23
t=2842,target_linear_speed=2000,ideal_linear_speed=710,measured_linear_speed=691.80,left_measured_linear_speed=673.09,right_measured_linear_speed=710.50,ideal_angular_speed=0.00,measured_angular_speed=0.61,pwm_left=83,pwm_right=83,battery_voltage=12.23
t=2843,target_linear_speed=2000,ideal_linear_speed=715,measured_linear_speed=693.72,left_measured_linear_speed=678.75,right_measured_linear_speed=708.68,ideal_angular_speed=0.00,measured_angular_speed=-0.29,pwm_left=84,pwm_right=84,battery_voltage=12.23
t=2844,target_linear_speed=2000,ideal_linear_speed=720,measured_linear_speed=695.25,left_measured_linear_speed=669.25,right_measured_linear_speed=721.25,ideal_angular_speed=0.00,measured_angular_speed=0.58,pwm_left=85,pwm_right=85,battery_voltage=12.23
t=2845,target_linear_speed=2000,ideal_linear_speed=725,measured_linear_speed=689.47,left_measured_linear_speed=675.68,right_measured_linear_speed=703.26,ideal_angular_speed=0.00,measured_angular_speed=-0.03,pwm_left=89,pwm_right=89,battery_voltage=12.22
t=2846,target_linear_speed=2000,ideal_linear_speed=730,measured_linear_speed=698.87,left_measured_linear_speed=680.83,right_measured_linear_speed=716.91,ideal_angular_speed=0.00,measured_angular_speed=-0.03,pwm_left=88,pwm_right=88,battery_voltage=12.22
t=2847,target_linear_speed=2000,ideal_linear_speed=735,measured_linear_speed=706.39,left_measured_linear_speed=684.94,right_measured_linear_speed=727.84,ideal_angular_speed=0.00,measured_angular_speed=0.23,pwm_left=88,pwm_right=88,battery_voltage=12.22
t=2848,target_linear_speed=2000,ideal_linear_speed=740,measured_linear_speed=705.39,left_measured_linear_speed=688.23,right_measured_linear_speed=722.55,ideal_angular_speed=0.00,measured_angular_speed=0.57,pwm_left=90,pwm_right=90,battery_voltage=12.22
t=2849,target_linear_speed=2000,ideal_linear_speed=745,measured_linear_speed=711.61,left_measured_linear_speed=704.89,right_measured_linear_speed=718.32,ideal_angular_speed=0.00,measured_angular_speed=0.42,pwm_left=90,pwm_right=90,battery_voltage=12.22
t=2850,target_linear_speed=2000,ideal_linear_speed=750,measured_linear_speed=709.57,left_measured_linear_speed=704.20,right_measured_linear_speed=714.94,ideal_angular_speed=0.00,measured_angular_speed=0.20,pwm_left=93,pwm_right=93,battery_voltage=12.22
t=2851,target_linear_speed=2000,ideal_linear_speed=755,measured_linear_speed=728.97,left_measured_linear_speed=717.66,right_measured_linear_speed=740.28,ideal_angular_speed=0.00,measured_angular_speed=-0.01,pwm_left=89,pwm_right=89,battery_voltage=12.22
t=2852,target_linear_speed=2000,ideal_linear_speed=760,measured_linear_speed=730.47,left_measured_linear_speed=714.41,right_measured_linear_speed=746.54,ideal_angular_speed=0.00,measured_angular_speed=0.66,pwm_left=91,pwm_right=91,battery_voltage=12.22
t=2853,target_linear_speed=2000,ideal_linear_speed=765,measured_linear_speed=731.67,left_measured_linear_speed=725.84,right_measured_linear_speed=737.51,ideal_angular_speed=0.00,measured_angular_speed=-0.45,pwm_left=92,pwm_right=92,battery_voltage=12.22
t=2854,target_linear_speed=2000,ideal_linear_speed=770,measured_linear_speed=739.65,left_measured_linear_speed=734.98,right_measured_linear_speed=744.31,ideal_angular_speed=0.00,measured_angular_speed=-0.45,pwm_left=92,pwm_right=92,battery_voltage=12.22
t=2855,target_linear_speed=2000,ideal_linear_speed=775,measured_linear_speed=739.01,left_measured_linear_speed=728.26,right_measured_linear_speed=749.76,ideal_angular_speed=0.00,measured_angular_speed=-0.12,pwm_left=94,pwm_right=94,battery_voltage=12.22
t=2856,target_linear_speed=2000,ideal_linear_speed=780,measured_linear_speed=752.53,left_measured_linear_speed=736.92,right_measured_linear_speed=768.14,ideal_angular_speed=0.00,measured_angular_speed=0.25,pwm_left=93,pwm_right=93,battery_voltage=12.22
t=2857,target_linear_speed=2000,ideal_linear_speed=785,measured_linear_speed=749.32,left_measured_linear_speed=743.84,right_measured_linear_speed=754.80,ideal_angular_speed=0.00,measured_angular_speed=0.62,pwm_left=95,pwm_right=95,battery_voltage=12.22
t=2858,target_linear_speed=2000,ideal_linear_speed=790,measured_linear_speed=760.78,left_measured_linear_speed=749.38,right_measured_linear_speed=772.17,ideal_angular_speed=0.00,measured_angular_speed=0.23,pwm_left=94,pwm_right=94,battery_voltage=12.22
t=2859,target_linear_speed=2000,ideal_linear_speed=795,measured_linear_speed=762.93,left_measured_linear_speed=753.81,right_measured_linear_speed=772.05,ideal_angular_speed=0.00,measured_angular_speed=-0.33,pwm_left=95,pwm_right=95,battery_voltage=12.21
t=2860,target_linear_speed=2000,ideal_linear_speed=800,measured_linear_speed=764.65,left_measured_linear_speed=743.33,right_measured_linear_speed=785.97,ideal_angular_speed=0.00,measured_angular_speed=0.16,pwm_left=97,pwm_right=97,battery_voltage=12.21
t=2861,target_linear_speed=2000,ideal_linear_speed=805,measured_linear_speed=766.03,left_measured_linear_speed=748.97,right_measured_linear_speed=783.09,ideal_angular_speed=0.00,measured_angular_speed=0.16,pwm_left=98,pwm_right=98,battery_voltage=12.21
t=2862,target_linear_speed=2000,ideal_linear_speed=810,measured_linear_speed=774.15,left_measured_linear_speed=753.49,right_measured_linear_speed=794.80,ideal_angular_speed=0.00,measured_angular_speed=0.03,pwm_left=98,pwm_right=98,battery_voltage=12.21
t=2863,target_linear_speed=2000,ideal_linear_speed=815,measured_linear_speed=787.65,left_measured_linear_speed=771.12,right_measured_linear_speed=804.18,ideal_angular_speed=0.00,measured_angular_speed=0.22,pwm_left=97,pwm_right=97,battery_voltage=12.21
t=2864,target_linear_speed=2000,ideal_linear_speed=820,measured_linear_speed=798.46,left_measured_linear_speed=771.21,right_measured_linear_speed=825.71,ideal_angular_speed=0.00,measured_angular_speed=-0.29,pwm_left=96,pwm_right=96,battery_voltage=12.21
t=2865,target_linear_speed=2000,ideal_linear_speed=825,measured_linear_speed=800.09,left_measured_linear_speed=785.30,right_measured_linear_speed=814.87,ideal_angular_speed=0.00,measured_angular_speed=-0.05,pwm_left=97,pwm_right=97,battery_voltage=12.21
t=2866,target_linear_speed=2000,ideal_linear_speed=830,measured_linear_speed=801.39,left_measured_linear_speed=782.55,right_measured_linear_speed=820.24,ideal_angular_speed=0.00,measured_angular_speed=0.06,pwm_left=98,pwm_right=98,battery_voltage=12.21
t=2867,target_linear_speed=2000,ideal_linear_speed=835,measured_linear_speed=816.46,left_measured_linear_speed=808.40,right_measured_linear_speed=824.52,ideal_angular_speed=0.00,measured_angular_speed=0.02,pwm_left=96,pwm_right=96,battery_voltage=12.21
t=2868,target_linear_speed=2000,ideal_linear_speed=840,measured_linear_speed=814.49,left_measured_linear_speed=801.03,right_measured_linear_speed=827.96,ideal_angular_speed=0.00,measured_angular_speed=0.30,pwm_left=98,pwm_right=98,battery_voltage=12.21
t=2869,target_linear_speed=2000,ideal_linear_speed=845,measured_linear_speed=819.93,left_measured_linear_speed=823.19,right_measured_linear_speed=816.67,ideal_angular_speed=0.00,measured_angular_speed=0.30,pwm_left=99,pwm_right=99,battery_voltage=12.21
t=2870,target_linear_speed=2000,ideal_linear_speed=850,measured_linear_speed=831.29,left_measured_linear_speed=826.89,right_measured_linear_speed=835.70,ideal_angular_speed=0.00,measured_angular_speed=-0.32,pwm_left=97,pwm_right=97,battery_voltage=12.21
t=2871,target_linear_speed=2000,ideal_linear_speed=855,measured_linear_speed=840.39,left_measured_linear_speed=843.87,right_measured_linear_speed=836.90,ideal_angular_speed=0.00,measured_angular_speed=0.06,pwm_left=96,pwm_right=96,battery_voltage=12.20
t=2872,target_linear_speed=2000,ideal_linear_speed=860,measured_linear_speed=847.66,left_measured_linear_speed=857.46,right_measured_linear_speed=837.85,ideal_angular_speed=0.00,measured_angular_speed=-0.51,pwm_left=96,pwm_right=96,battery_voltage=12.20
t=2873,target_linear_speed=2000,ideal_linear_speed=865,measured_linear_speed=846.46,left_measured_linear_speed=840.28,right_measured_linear_speed=852.65,ideal_angular_speed=0.00,measured_angular_speed=-0.11,pwm_left=98,pwm_right=98,battery_voltage=12.20
t=2874,target_linear_speed=2000,ideal_linear_speed=870,measured_linear_speed=852.52,left_measured_linear_speed=854.59,right_measured_linear_speed=850.45,ideal_angular_speed=0.00,measured_angular_speed=-0.09,pwm_left=98,pwm_right=98,battery_voltage=12.20
t=2875,target_linear_speed=2000,ideal_linear_speed=875,measured_linear_speed=871.39,left_measured_linear_speed=880.06,right_measured_linear_speed=862.73,ideal_angular_speed=0.00,measured_angular_speed=-0.37,pwm_left=94,pwm_right=94,battery_voltage=12.20
t=2876,target_linear_speed=2000,ideal_linear_speed=880,measured_linear_speed=872.47,left_measured_linear_speed=886.41,right_measured_linear_speed=858.52,ideal_angular_speed=0.00,measured_angular_speed=-0.37,pwm_left=96,pwm_right=96,battery_voltage=12.20
t=2877,target_linear_speed=2000,ideal_linear_speed=885,measured_linear_speed=880.34,left_measured_linear_speed=891.49,right_measured_linear_speed=869.18,ideal_angular_speed=0.00,measured_angular_speed=0.07,pwm_left=95,pwm_right=95,battery_voltage=12.21
t=2878,target_linear_speed=2000,ideal_linear_speed=890,measured_linear_speed=872.61,left_measured_linear_speed=881.53,right_measured_linear_speed=863.68,ideal_angular_speed=0.00,measured_angular_speed=-0.88,pwm_left=99,pwm_right=99,battery_voltage=12.21
t=2879,target_linear_speed=2000,ideal_linear_speed=895,measured_linear_speed=880.45,left_measured_linear_speed=887.59,right_measured_linear_speed=873.31,ideal_angular_speed=0.00,measured_angular_speed=-0.13,pwm_left=98,pwm_right=98,battery_voltage=12.20
t=2880,target_linear_speed=2000,ideal_linear_speed=900,measured_linear_speed=879.71,left_measured_linear_speed=892.44,right_measured_linear_speed=866.98,ideal_angular_speed=0.00,measured_angular_speed=-0.33,pwm_left=100,pwm_right=100,battery_voltage=12.20
t=2881,target_linear_speed=2000,ideal_linear_speed=905,measured_linear_speed=879.12,left_measured_linear_speed=882.28,right_measured_linear_speed=875.95,ideal_angular_speed=0.00,measured_angular_speed=-0.14,pwm_left=102,pwm_right=102,battery_voltage=12.20
t=2882,target_linear_speed=2000,ideal_linear_speed=910,measured_linear_speed=871.63,left_measured_linear_speed=888.19,right_measured_linear_speed=855.07,ideal_angular_speed=0.00,measured_angular_speed=-0.49,pwm_left=106,pwm_right=106,battery_voltage=12.20
t=2883,target_linear_speed=2000,ideal_linear_speed=915,measured_linear_speed=893.70,left_measured_linear_speed=892.92,right_measured_linear_speed=894.47,ideal_angular_speed=0.00,measured_angular_speed=-1.04,pwm_left=102,pwm_right=102,battery_voltage=12.20
t=2884,target_linear_speed=2000,ideal_linear_speed=920,measured_linear_speed=897.32,left_measured_linear_speed=910.73,right_measured_linear_speed=883.92,ideal_angular_speed=0.00,measured_angular_speed=-1.04,pwm_left=102,pwm_right=102,battery_voltage=12.20
t=2885,target_linear_speed=2000,ideal_linear_speed=925,measured_linear_speed=914.25,left_measured_linear_speed=939.00,right_measured_linear_speed=889.50,ideal_angular_speed=0.00,measured_angular_speed=0.02,pwm_left=100,pwm_right=100,battery_voltage=12.20
t=2886,target_linear_speed=2000,ideal_linear_speed=930,measured_linear_speed=913.76,left_measured_linear_speed=933.56,right_measured_linear_speed=893.96,ideal_angular_speed=0.00,measured_angular_speed=-0.79,pwm_left=101,pwm_right=101,battery_voltage=12.20
t=2887,target_linear_speed=2000,ideal_linear_speed=935,measured_linear_speed=913.37,left_measured_linear_speed=929.22,right_measured_linear_speed=897.53,ideal_angular_speed=0.00,measured_angular_speed=-0.25,pwm_left=103,pwm_right=103,battery_voltage=12.20
t=2888,target_linear_speed=2000,ideal_linear_speed=940,measured_linear_speed=927.09,left_measured_linear_speed=953.79,right_measured_linear_speed=900.39,ideal_angular_speed=0.00,measured_angular_speed=-0.71,pwm_left=101,pwm_right=101,battery_voltage=12.20
t=2889,target_linear_speed=2000,ideal_linear_speed=945,measured_linear_speed=931.05,left_measured_linear_speed=945.40,right_measured_linear_speed=916.70,ideal_angular_speed=0.00,measured_angular_speed=-0.07,pwm_left=101,pwm_right=101,battery_voltage=12.20
t=2890,target_linear_speed=2000,ideal_linear_speed=950,measured_linear_speed=941.23,left_measured_linear_speed=966.74,right_measured_linear_speed=915.73,ideal_angular_speed=0.00,measured_angular_speed=-0.08,pwm_left=100,pwm_right=100,battery_voltage=12.20
t=2891,target_linear_speed=2000,ideal_linear_speed=955,measured_linear_speed=949.38,left_measured_linear_speed=969.78,right_measured_linear_speed=928.97,ideal_angular_speed=0.00,measured_angular_speed=-0.08,pwm_left=100,pwm_right=100,battery_voltage=12.20
t=2892,target_linear_speed=2000,ideal_linear_speed=960,measured_linear_speed=948.88,left_measured_linear_speed=972.22,right_measured_linear_speed=925.54,ideal_angular_speed=0.00,measured_angular_speed=-0.34,pwm_left=101,pwm_right=101,battery_voltage=12.20
t=2893,target_linear_speed=2000,ideal_linear_speed=965,measured_linear_speed=962.51,left_measured_linear_speed=974.17,right_measured_linear_speed=950.85,ideal_angular_speed=0.00,measured_angular_speed=0.36,pwm_left=99,pwm_right=99,battery_voltage=12.20
t=2894,target_linear_speed=2000,ideal_linear_speed=970,measured_linear_speed=973.41,left_measured_linear_speed=1003.78,right_measured_linear_speed=943.05,ideal_angular_speed=0.00,measured_angular_speed=-0.41,pwm_left=97,pwm_right=97,battery_voltage=12.20
t=2895,target_linear_speed=2000,ideal_linear_speed=975,measured_linear_speed=982.14,left_measured_linear_speed=999.42,right_measured_linear_speed=964.86,ideal_angular_speed=0.00,measured_angular_speed=0.05,pwm_left=96,pwm_right=96,battery_voltage=12.20
t=2896,target_linear_speed=2000,ideal_linear_speed=980,measured_linear_speed=982.10,left_measured_linear_speed=1009.95,right_measured_linear_speed=954.25,ideal_angular_speed=0.00,measured_angular_speed=-0.10,pwm_left=98,pwm_right=98,battery_voltage=12.20
t=2897,target_linear_speed=2000,ideal_linear_speed=985,measured_linear_speed=989.09,left_measured_linear_speed=1004.35,right_measured_linear_speed=973.82,ideal_angular_speed=0.00,measured_angular_speed=-0.08,pwm_left=97,pwm_right=97,battery_voltage=12.20
t=2898,target_linear_speed=2000,ideal_linear_speed=990,measured_linear_speed=987.66,left_measured_linear_speed=999.88,right_measured_linear_speed=975.45,ideal_angular_speed=0.00,measured_angular_speed=-0.08,pwm_left=99,pwm_right=99,battery_voltage=12.20
t=2899,target_linear_speed=2000,ideal_linear_speed=995,measured_linear_speed=993.54,left_measured_linear_speed=1010.32,right_measured_linear_speed=976.75,ideal_angular_speed=0.00,measured_angular_speed=0.28,pwm_left=98,pwm_right=98,battery_voltage=12.20
t=2900,target_linear_speed=2000,ideal_linear_speed=1000,measured_linear_speed=1005.25,left_measured_linear_speed=1032.70,right_measured_linear_speed=977.79,ideal_angular_speed=0.00,measured_angular_speed=0.03,pwm_left=97,pwm_right=97,battery_voltage=12.20
t=2901,target_linear_speed=2000,ideal_linear_speed=1005,measured_linear_speed=1007.60,left_measured_linear_speed=1036.58,right_measured_linear_speed=978.63,ideal_angular_speed=0.00,measured_angular_speed=0.28,pwm_left=97,pwm_right=97,battery_voltage=12.20
t=2902,target_linear_speed=2000,ideal_linear_speed=1010,measured_linear_speed=1023.52,left_measured_linear_speed=1039.69,right_measured_linear_speed=1007.35,ideal_angular_speed=0.00,measured_angular_speed=-0.22,pwm_left=94,pwm_right=94,battery_voltage=12.20
t=2903,target_linear_speed=2000,ideal_linear_speed=1015,measured_linear_speed=1022.22,left_measured_linear_speed=1042.17,right_measured_linear_speed=1002.27,ideal_angular_speed=0.00,measured_angular_speed=0.13,pwm_left=96,pwm_right=96,battery_voltage=12.20
t=2904,target_linear_speed=2000,ideal_linear_speed=1020,measured_linear_speed=1014.17,left_measured_linear_speed=1030.13,right_measured_linear_speed=998.21,ideal_angular_speed=0.00,measured_angular_speed=0.01,pwm_left=99,pwm_right=99,battery_voltage=12.20
t=2905,target_linear_speed=2000,ideal_linear_speed=1025,measured_linear_speed=1014.74,left_measured_linear_speed=1034.52,right_measured_linear_speed=994.96,ideal_angular_speed=0.00,measured_angular_speed=-0.55,pwm_left=101,pwm_right=101,battery_voltage=12.20
t=2906,target_linear_speed=2000,ideal_linear_speed=1030,measured_linear_speed=1008.18,left_measured_linear_speed=1024.01,right_measured_linear_speed=992.36,ideal_angular_speed=0.00,measured_angular_speed=-0.55,pwm_left=104,pwm_right=104,battery_voltage=12.20
t=2907,target_linear_speed=2000,ideal_linear_speed=1035,measured_linear_speed=1023.98,left_measured_linear_speed=1029.63,right_measured_linear_speed=1018.34,ideal_angular_speed=0.00,measured_angular_speed=0.24,pwm_left=101,pwm_right=101,battery_voltage=12.20
t=2908,target_linear_speed=2000,ideal_linear_speed=1040,measured_linear_speed=1022.59,left_measured_linear_speed=1020.09,right_measured_linear_speed=1025.09,ideal_angular_speed=0.00,measured_angular_speed=-0.27,pwm_left=103,pwm_right=103,battery_voltage=12.20
t=2909,target_linear_speed=2000,ideal_linear_speed=1045,measured_linear_speed=1021.48,left_measured_linear_speed=1012.47,right_measured_linear_speed=1030.49,ideal_angular_speed=0.00,measured_angular_speed=0.02,pwm_left=105,pwm_right=105,battery_voltage=12.20
t=2910,target_linear_speed=2000,ideal_linear_speed=1050,measured_linear_speed=1020.59,left_measured_linear_speed=1006.37,right_measured_linear_speed=1034.81,ideal_angular_speed=0.00,measured_angular_speed=0.17,pwm_left=107,pwm_right=107,battery_voltage=12.20
t=2911,target_linear_speed=2000,ideal_linear_speed=1055,measured_linear_speed=1040.92,left_measured_linear_speed=1029.54,right_measured_linear_speed=1052.30,ideal_angular_speed=0.00,measured_angular_speed=0.37,pwm_left=104,pwm_right=104,battery_voltage=12.20
t=2912,target_linear_speed=2000,ideal_linear_speed=1060,measured_linear_speed=1043.16,left_measured_linear_speed=1034.05,right_measured_linear_speed=1052.26,ideal_angular_speed=0.00,measured_angular_speed=0.33,pwm_left=105,pwm_right=105,battery_voltage=12.19
t=2913,target_linear_speed=2000,ideal_linear_speed=1065,measured_linear_speed=1058.97,left_measured_linear_speed=1051.69,right_measured_linear_speed=1066.25,ideal_angular_speed=0.00,measured_angular_speed=0.33,pwm_left=102,pwm_right=102,battery_voltage=12.19
t=2914,target_linear_speed=2000,ideal_linear_speed=1070,measured_linear_speed=1057.60,left_measured_linear_speed=1051.77,right_measured_linear_speed=1063.42,ideal_angular_speed=0.00,measured_angular_speed=0.10,pwm_left=104,pwm_right=104,battery_voltage=12.20
t=2915,target_linear_speed=2000,ideal_linear_speed=1075,measured_linear_speed=1063.51,left_measured_linear_speed=1051.84,right_measured_linear_speed=1075.19,ideal_angular_speed=0.00,measured_angular_speed=0.62,pwm_left=104,pwm_right=104,battery_voltage=12.20
t=2916,target_linear_speed=2000,ideal_linear_speed=1080,measured_linear_speed=1075.26,left_measured_linear_speed=1065.92,right_measured_linear_speed=1084.60,ideal_angular_speed=0.00,measured_angular_speed=0.34,pwm_left=102,pwm_right=102,battery_voltage=12.19
t=2917,target_linear_speed=2000,ideal_linear_speed=1085,measured_linear_speed=1070.63,left_measured_linear_speed=1063.15,right_measured_linear_speed=1078.10,ideal_angular_speed=0.00,measured_angular_speed=0.62,pwm_left=105,pwm_right=105,battery_voltage=12.19
t=2918,target_linear_speed=2000,ideal_linear_speed=1090,measured_linear_speed=1073.94,left_measured_linear_speed=1060.94,right_measured_linear_speed=1086.93,ideal_angular_speed=0.00,measured_angular_speed=0.43,pwm_left=106,pwm_right=106,battery_voltage=12.19
t=2919,target_linear_speed=2000,ideal_linear_speed=1095,measured_linear_speed=1090.61,left_measured_linear_speed=1073.20,right_measured_linear_speed=1108.02,ideal_angular_speed=0.00,measured_angular_speed=0.29,pwm_left=103,pwm_right=103,battery_voltage=12.19
t=2920,target_linear_speed=2000,ideal_linear_speed=1100,measured_linear_speed=1103.95,left_measured_linear_speed=1097.04,right_measured_linear_speed=1110.86,ideal_angular_speed=0.00,measured_angular_speed=0.71,pwm_left=100,pwm_right=100,battery_voltage=12.19
t=2921,target_linear_speed=2000,ideal_linear_speed=1105,measured_linear_speed=1093.58,left_measured_linear_speed=1074.02,right_measured_linear_speed=1113.14,ideal_angular_speed=0.00,measured_angular_speed=0.71,pwm_left=105,pwm_right=105,battery_voltage=12.19
t=2922,target_linear_speed=2000,ideal_linear_speed=1110,measured_linear_speed=1099.31,left_measured_linear_speed=1083.67,right_measured_linear_speed=1114.96,ideal_angular_speed=0.00,measured_angular_speed=0.20,pwm_left=105,pwm_right=105,battery_voltage=12.19
t=2923,target_linear_speed=2000,ideal_linear_speed=1115,measured_linear_speed=1103.90,left_measured_linear_speed=1077.35,right_measured_linear_speed=1130.44,ideal_angular_speed=0.00,measured_angular_speed=0.59,pwm_left=105,pwm_right=105,battery_voltage=12.19
t=2924,target_linear_speed=2000,ideal_linear_speed=1120,measured_linear_speed=1100.55,left_measured_linear_speed=1086.33,right_measured_linear_speed=1114.77,ideal_angular_speed=0.00,measured_angular_speed=-0.07,pwm_left=107,pwm_right=107,battery_voltage=12.19
t=2925,target_linear_speed=2000,ideal_linear_speed=1125,measured_linear_speed=1104.89,left_measured_linear_speed=1079.48,right_measured_linear_speed=1130.30,ideal_angular_speed=0.00,measured_angular_speed=0.46,pwm_left=108,pwm_right=108,battery_voltage=12.19
t=2926,target_linear_speed=2000,ideal_linear_speed=1130,measured_linear_speed=1115.37,left_measured_linear_speed=1088.04,right_measured_linear_speed=1142.71,ideal_angular_speed=0.00,measured_angular_speed=0.53,pwm_left=107,pwm_right=107,battery_voltage=12.19
t=2927,target_linear_speed=2000,ideal_linear_speed=1135,measured_linear_speed=1109.73,left_measured_linear_speed=1094.88,right_measured_linear_speed=1124.59,ideal_angular_speed=0.00,measured_angular_speed=0.23,pwm_left=110,pwm_right=110,battery_voltage=12.19
t=2928,target_linear_speed=2000,ideal_linear_speed=1140,measured_linear_speed=1119.25,left_measured_linear_speed=1100.35,right_measured_linear_speed=1138.15,ideal_angular_speed=0.00,measured_angular_speed=0.23,pwm_left=109,pwm_right=109,battery_voltage=12.19
t=2929,target_linear_speed=2000,ideal_linear_speed=1145,measured_linear_speed=1119.85,left_measured_linear_speed=1104.73,right_measured_linear_speed=1134.97,ideal_angular_speed=0.00,measured_angular_speed=0.40,pwm_left=111,pwm_right=111,battery_voltage=12.19
t=2930,target_linear_speed=2000,ideal_linear_speed=1150,measured_linear_speed=1113.31,left_measured_linear_speed=1094.20,right_measured_linear_speed=1132.42,ideal_angular_speed=0.00,measured_angular_speed=0.36,pwm_left=114,pwm_right=114,battery_voltage=12.19
t=2931,target_linear_speed=2000,ideal_linear_speed=1155,measured_linear_speed=1115.10,left_measured_linear_speed=1099.81,right_measured_linear_speed=1130.39,ideal_angular_speed=0.00,measured_angular_speed=0.42,pwm_left=116,pwm_right=116,battery_voltage=12.19
t=2932,target_linear_speed=2000,ideal_linear_speed=1160,measured_linear_speed=1116.53,left_measured_linear_speed=1090.27,right_measured_linear_speed=1142.78,ideal_angular_speed=0.00,measured_angular_speed=0.35,pwm_left=117,pwm_right=117,battery_voltage=12.18
t=2933,target_linear_speed=2000,ideal_linear_speed=1165,measured_linear_speed=1124.68,left_measured_linear_speed=1096.66,right_measured_linear_speed=1152.70,ideal_angular_speed=0.00,measured_angular_speed=0.21,pwm_left=117,pwm_right=117,battery_voltage=12.18
t=2934,target_linear_speed=2000,ideal_linear_speed=1170,measured_linear_speed=1124.19,left_measured_linear_speed=1087.75,right_measured_linear_speed=1160.64,ideal_angular_speed=0.00,measured_angular_speed=0.60,pwm_left=120,pwm_right=120,battery_voltage=12.18
t=2935,target_linear_speed=2000,ideal_linear_speed=1175,measured_linear_speed=1123.80,left_measured_linear_speed=1080.62,right_measured_linear_speed=1166.99,ideal_angular_speed=0.00,measured_angular_speed=-0.06,pwm_left=122,pwm_right=122,battery_voltage=12.18
t=2936,target_linear_speed=2000,ideal_linear_speed=1180,measured_linear_speed=1137.52,left_measured_linear_speed=1117.00,right_measured_linear_speed=1158.04,ideal_angular_speed=0.00,measured_angular_speed=-0.06,pwm_left=120,pwm_right=120,battery_voltage=12.18
t=2937,target_linear_speed=2000,ideal_linear_speed=1185,measured_linear_speed=1134.46,left_measured_linear_speed=1104.02,right_measured_linear_speed=1164.91,ideal_angular_speed=0.00,measured_angular_speed=0.44,pwm_left=123,pwm_right=123,battery_voltage=12.18
t=2938,target_linear_speed=2000,ideal_linear_speed=1190,measured_linear_speed=1139.03,left_measured_linear_speed=1107.66,right_measured_linear_speed=1170.40,ideal_angular_speed=0.00,measured_angular_speed=0.01,pwm_left=124,pwm_right=124,battery_voltage=12.18
t=2939,target_linear_speed=2000,ideal_linear_speed=1195,measured_linear_speed=1149.70,left_measured_linear_speed=1138.64,right_measured_linear_speed=1160.77,ideal_angular_speed=0.00,measured_angular_speed=-0.09,pwm_left=124,pwm_right=124,battery_voltage=12.17
t=2940,target_linear_speed=2000,ideal_linear_speed=1200,measured_linear_speed=1151.22,left_measured_linear_speed=1135.36,right_measured_linear_speed=1167.09,ideal_angular_speed=0.00,measured_angular_speed=-0.21,pwm_left=125,pwm_right=125,battery_voltage=12.17
t=2941,target_linear_speed=2000,ideal_linear_speed=1205,measured_linear_speed=1173.48,left_measured_linear_speed=1160.79,right_measured_linear_speed=1186.18,ideal_angular_speed=0.00,measured_angular_speed=-0.27,pwm_left=122,pwm_right=122,battery_voltage=12.17
t=2942,target_linear_speed=2000,ideal_linear_speed=1210,measured_linear_speed=1170.25,left_measured_linear_speed=1153.08,right_measured_linear_speed=1187.42,ideal_angular_speed=0.00,measured_angular_speed=0.45,pwm_left=124,pwm_right=124,battery_voltage=12.17
t=2943,target_linear_speed=2000,ideal_linear_speed=1215,measured_linear_speed=1188.70,left_measured_linear_speed=1174.97,right_measured_linear_speed=1202.44,ideal_angular_speed=0.00,measured_angular_speed=0.45,pwm_left=121,pwm_right=121,battery_voltage=12.17
t=2944,target_linear_speed=2000,ideal_linear_speed=1220,measured_linear_speed=1203.47,left_measured_linear_speed=1192.48,right_measured_linear_speed=1214.45,ideal_angular_speed=0.00,measured_angular_speed=-0.54,pwm_left=119,pwm_right=119,battery_voltage=12.17
t=2945,target_linear_speed=2000,ideal_linear_speed=1225,measured_linear_speed=1208.26,left_measured_linear_speed=1206.49,right_measured_linear_speed=1210.04,ideal_angular_speed=0.00,measured_angular_speed=-0.44,pwm_left=119,pwm_right=119,battery_voltage=12.17
t=2946,target_linear_speed=2000,ideal_linear_speed=1230,measured_linear_speed=1205.09,left_measured_linear_speed=1203.67,right_measured_linear_speed=1206.51,ideal_angular_speed=0.00,measured_angular_speed=-0.03,pwm_left=122,pwm_right=122,battery_voltage=12.17
t=2947,target_linear_speed=2000,ideal_linear_speed=1235,measured_linear_speed=1209.56,left_measured_linear_speed=1215.44,right_measured_linear_speed=1203.68,ideal_angular_speed=0.00,measured_angular_speed=-0.14,pwm_left=123,pwm_right=123,battery_voltage=12.16
t=2948,target_linear_speed=2000,ideal_linear_speed=1240,measured_linear_speed=1213.14,left_measured_linear_speed=1210.82,right_measured_linear_speed=1215.45,ideal_angular_speed=0.00,measured_angular_speed=-0.13,pwm_left=123,pwm_right=123,battery_voltage=12.16
t=2949,target_linear_speed=2000,ideal_linear_speed=1245,measured_linear_speed=1223.01,left_measured_linear_speed=1221.16,right_measured_linear_speed=1224.86,ideal_angular_speed=0.00,measured_angular_speed=-0.31,pwm_left=123,pwm_right=123,battery_voltage=12.16
t=2950,target_linear_speed=2000,ideal_linear_speed=1250,measured_linear_speed=1223.90,left_measured_linear_speed=1215.41,right_measured_linear_speed=1232.39,ideal_angular_speed=0.00,measured_angular_speed=-0.31,pwm_left=124,pwm_right=124,battery_voltage=12.16
t=2951,target_linear_speed=2000,ideal_linear_speed=1255,measured_linear_speed=1238.64,left_measured_linear_speed=1252.89,right_measured_linear_speed=1224.39,ideal_angular_speed=0.00,measured_angular_speed=0.24,pwm_left=122,pwm_right=122,battery_voltage=12.16
t=2952,target_linear_speed=2000,ideal_linear_speed=1260,measured_linear_speed=1229.39,left_measured_linear_speed=1254.81,right_measured_linear_speed=1203.96,ideal_angular_speed=0.00,measured_angular_speed=-0.52,pwm_left=126,pwm_right=126,battery_voltage=12.16
t=2953,target_linear_speed=2000,ideal_linear_speed=1265,measured_linear_speed=1243.03,left_measured_linear_speed=1270.38,right_measured_linear_speed=1215.67,ideal_angular_speed=0.00,measured_angular_speed=-0.66,pwm_left=124,pwm_right=124,battery_voltage=12.16
t=2954,target_linear_speed=2000,ideal_linear_speed=1270,measured_linear_speed=1246.93,left_measured_linear_speed=1282.84,right_measured_linear_speed=1211.01,ideal_angular_speed=0.00,measured_angular_speed=-0.04,pwm_left=125,pwm_right=125,battery_voltage=12.16
t=2955,target_linear_speed=2000,ideal_linear_speed=1275,measured_linear_speed=1257.06,left_measured_linear_speed=1292.80,right_measured_linear_speed=1221.32,ideal_angular_speed=0.00,measured_angular_speed=-0.26,pwm_left=124,pwm_right=124,battery_voltage=12.16
t=2956,target_linear_speed=2000,ideal_linear_speed=1280,measured_linear_speed=1272.18,left_measured_linear_speed=1286.75,right_measured_linear_speed=1257.61,ideal_angular_speed=0.00,measured_angular_speed=-0.19,pwm_left=121,pwm_right=121,battery_voltage=12.16
t=2957,target_linear_speed=2000,ideal_linear_speed=1285,measured_linear_speed=1277.26,left_measured_linear_speed=1295.93,right_measured_linear_speed=1258.59,ideal_angular_speed=0.00,measured_angular_speed=-0.20,pwm_left=122,pwm_right=122,battery_voltage=12.16
t=2958,target_linear_speed=2000,ideal_linear_speed=1290,measured_linear_speed=1288.34,left_measured_linear_speed=1303.27,right_measured_linear_speed=1273.41,ideal_angular_speed=0.00,measured_angular_speed=-0.20,pwm_left=120,pwm_right=120,battery_voltage=12.16
t=2959,target_linear_speed=2000,ideal_linear_speed=1295,measured_linear_speed=1283.18,left_measured_linear_speed=1309.15,right_measured_linear_speed=1257.20,ideal_angular_speed=0.00,measured_angular_speed=0.29,pwm_left=123,pwm_right=123,battery_voltage=12.16
t=2960,target_linear_speed=2000,ideal_linear_speed=1300,measured_linear_speed=1286.06,left_measured_linear_speed=1299.83,right_measured_linear_speed=1272.29,ideal_angular_speed=0.00,measured_angular_speed=-0.20,pwm_left=124,pwm_right=124,battery_voltage=12.16
t=2961,target_linear_speed=2000,ideal_linear_speed=1305,measured_linear_speed=1281.35,left_measured_linear_speed=1306.39,right_measured_linear_speed=1256.31,ideal_angular_speed=0.00,measured_angular_speed=-0.65,pwm_left=127,pwm_right=127,battery_voltage=12.16
t=2962,target_linear_speed=2000,ideal_linear_speed=1310,measured_linear_speed=1284.60,left_measured_linear_speed=1297.62,right_measured_linear_speed=1271.58,ideal_angular_speed=0.00,measured_angular_speed=0.10,pwm_left=127,pwm_right=127,battery_voltage=12.16
t=2963,target_linear_speed=2000,ideal_linear_speed=1315,measured_linear_speed=1308.24,left_measured_linear_speed=1332.68,right_measured_linear_speed=1283.80,ideal_angular_speed=0.00,measured_angular_speed=-0.26,pwm_left=123,pwm_right=123,battery_voltage=12.16
t=2964,target_linear_speed=2000,ideal_linear_speed=1320,measured_linear_speed=1320.14,left_measured_linear_speed=1346.71,right_measured_linear_speed=1293.57,ideal_angular_speed=0.00,measured_angular_speed=0.37,pwm_left=121,pwm_right=121,battery_voltage=12.16
t=2965,target_linear_speed=2000,ideal_linear_speed=1325,measured_linear_speed=1329.66,left_measured_linear_speed=1371.95,right_measured_linear_speed=1287.36,ideal_angular_speed=0.00,measured_angular_speed=0.37,pwm_left=120,pwm_right=120,battery_voltage=12.16
t=2966,target_linear_speed=2000,ideal_linear_speed=1330,measured_linear_speed=1323.24,left_measured_linear_speed=1336.04,right_measured_linear_speed=1310.45,ideal_angular_speed=0.00,measured_angular_speed=0.37,pwm_left=347,pwm_right=-101,battery_voltage=12.16
t=2967,target_linear_speed=2000,ideal_linear_speed=1335,measured_linear_speed=1297.07,left_measured_linear_speed=1321.33,right_measured_linear_speed=1272.81,ideal_angular_speed=0.00,measured_angular_speed=0.75,pwm_left=37,pwm_right=227,battery_voltage=12.12
t=2968,target_linear_speed=2000,ideal_linear_speed=1340,measured_linear_speed=1325.23,left_measured_linear_speed=1351.66,right_measured_linear_speed=1298.80,ideal_angular_speed=0.00,measured_angular_speed=0.46,pwm_left=248,pwm_right=5,battery_voltage=12.10
t=2969,target_linear_speed=2000,ideal_linear_speed=1345,measured_linear_speed=1326.72,left_measured_linear_speed=1375.91,right_measured_linear_speed=1277.52,ideal_angular_speed=0.00,measured_angular_speed=-2.47,pwm_left=32,pwm_right=223,battery_voltage=12.10
t=2970,target_linear_speed=2000,ideal_linear_speed=1350,measured_linear_speed=1320.89,left_measured_linear_speed=1353.23,right_measured_linear_speed=1288.55,ideal_angular_speed=0.00,measured_angular_speed=-0.82,pwm_left=27,pwm_right=235,battery_voltage=12.10
t=2971,target_linear_speed=2000,ideal_linear_speed=1355,measured_linear_speed=1323.24,left_measured_linear_speed=1349.12,right_measured_linear_speed=1297.37,ideal_angular_speed=0.00,measured_angular_speed=-0.25,pwm_left=132,pwm_right=132,battery_voltage=12.10
t=2972,target_linear_speed=2000,ideal_linear_speed=1360,measured_linear_speed=1339.16,left_measured_linear_speed=1345.83,right_measured_linear_speed=1332.48,ideal_angular_speed=0.00,measured_angular_speed=-0.60,pwm_left=130,pwm_right=130,battery_voltage=12.10
t=2973,target_linear_speed=2000,ideal_linear_speed=1365,measured_linear_speed=1358.90,left_measured_linear_speed=1371.25,right_measured_linear_speed=1346.55,ideal_angular_speed=0.00,measured_angular_speed=-0.60,pwm_left=126,pwm_right=126,battery_voltage=12.10
t=2974,target_linear_speed=2000,ideal_linear_speed=1370,measured_linear_speed=1360.66,left_measured_linear_speed=1377.56,right_measured_linear_speed=1343.77,ideal_angular_speed=0.00,measured_angular_speed=0.83,pwm_left=352,pwm_right=-97,battery_voltage=12.11
t=2975,target_linear_speed=2000,ideal_linear_speed=1375,measured_linear_speed=1362.08,left_measured_linear_speed=1368.58,right_measured_linear_speed=1355.58,ideal_angular_speed=0.00,measured_angular_speed=-0.89,pwm_left=33,pwm_right=225,battery_voltage=12.04
t=2976,target_linear_speed=2000,ideal_linear_speed=1380,measured_linear_speed=1398.28,left_measured_linear_speed=1417.51,right_measured_linear_speed=1379.05,ideal_angular_speed=0.00,measured_angular_speed=-0.21,pwm_left=16,pwm_right=225,battery_voltage=12.04
t=2977,target_linear_speed=2000,ideal_linear_speed=1385,measured_linear_speed=1434.25,left_measured_linear_speed=1484.71,right_measured_linear_speed=1383.80,ideal_angular_speed=0.00,measured_angular_speed=-1.16,pwm_left=111,pwm_right=111,battery_voltage=12.04
t=2978,target_linear_speed=2000,ideal_linear_speed=1390,measured_linear_speed=1413.93,left_measured_linear_speed=1440.27,right_measured_linear_speed=1387.60,ideal_angular_speed=0.00,measured_angular_speed=-0.07,pwm_left=117,pwm_right=117,battery_voltage=12.05
t=2979,target_linear_speed=2000,ideal_linear_speed=1395,measured_linear_speed=1390.67,left_measured_linear_speed=1390.69,right_measured_linear_speed=1390.64,ideal_angular_speed=0.00,measured_angular_speed=-0.08,pwm_left=125,pwm_right=125,battery_voltage=12.06
t=2980,target_linear_speed=2000,ideal_linear_speed=1400,measured_linear_speed=1386.08,left_measured_linear_speed=1365.06,right_measured_linear_speed=1407.10,ideal_angular_speed=0.00,measured_angular_speed=-0.08,pwm_left=127,pwm_right=127,battery_voltage=12.07
t=2981,target_linear_speed=2000,ideal_linear_speed=1405,measured_linear_speed=1389.42,left_measured_linear_speed=1372.61,right_measured_linear_speed=1406.24,ideal_angular_speed=0.00,measured_angular_speed=0.37,pwm_left=128,pwm_right=128,battery_voltage=12.08
t=2982,target_linear_speed=2000,ideal_linear_speed=1410,measured_linear_speed=1406.13,left_measured_linear_speed=1378.64,right_measured_linear_speed=1433.61,ideal_angular_speed=0.00,measured_angular_speed=0.94,pwm_left=125,pwm_right=125,battery_voltage=12.09
t=2983,target_linear_speed=2000,ideal_linear_speed=1415,measured_linear_speed=1426.50,left_measured_linear_speed=1425.56,right_measured_linear_speed=1427.45,ideal_angular_speed=0.00,measured_angular_speed=-0.10,pwm_left=121,pwm_right=121,battery_voltage=12.09
t=2984,target_linear_speed=2000,ideal_linear_speed=1420,measured_linear_speed=1435.79,left_measured_linear_speed=1435.04,right_measured_linear_speed=1436.54,ideal_angular_speed=0.00,measured_angular_speed=0.24,pwm_left=119,pwm_right=119,battery_voltage=12.10
t=2985,target_linear_speed=2000,ideal_linear_speed=1425,measured_linear_speed=1422.18,left_measured_linear_speed=1414.56,right_measured_linear_speed=1429.80,ideal_angular_speed=0.00,measured_angular_speed=0.47,pwm_left=124,pwm_right=124,battery_voltage=12.11
t=2986,target_linear_speed=2000,ideal_linear_speed=1430,measured_linear_speed=1418.30,left_measured_linear_speed=1398.18,right_measured_linear_speed=1438.42,ideal_angular_speed=0.00,measured_angular_speed=0.77,pwm_left=127,pwm_right=127,battery_voltage=12.11
t=2987,target_linear_speed=2000,ideal_linear_speed=1435,measured_linear_speed=1408.19,left_measured_linear_speed=1385.08,right_measured_linear_speed=1431.30,ideal_angular_speed=0.00,measured_angular_speed=0.85,pwm_left=131,pwm_right=131,battery_voltage=12.11
t=2988,target_linear_speed=2000,ideal_linear_speed=1440,measured_linear_speed=1414.12,left_measured_linear_speed=1374.59,right_measured_linear_speed=1453.66,ideal_angular_speed=0.00,measured_angular_speed=0.85,pwm_left=131,pwm_right=131,battery_voltage=12.12
t=2989,target_linear_speed=2000,ideal_linear_speed=1445,measured_linear_speed=1418.87,left_measured_linear_speed=1366.21,right_measured_linear_speed=1471.54,ideal_angular_speed=0.00,measured_angular_speed=0.19,pwm_left=132,pwm_right=132,battery_voltage=12.12
t=2990,target_linear_speed=2000,ideal_linear_speed=1450,measured_linear_speed=1415.66,left_measured_linear_speed=1373.53,right_measured_linear_speed=1457.79,ideal_angular_speed=0.00,measured_angular_speed=0.57,pwm_left=134,pwm_right=134,battery_voltage=12.12
t=2991,target_linear_speed=2000,ideal_linear_speed=1455,measured_linear_speed=1413.09,left_measured_linear_speed=1379.38,right_measured_linear_speed=1446.79,ideal_angular_speed=0.00,measured_angular_speed=0.21,pwm_left=137,pwm_right=137,battery_voltage=12.12
t=2992,target_linear_speed=2000,ideal_linear_speed=1460,measured_linear_speed=1404.02,left_measured_linear_speed=1370.04,right_measured_linear_speed=1438.00,ideal_angular_speed=0.00,measured_angular_speed=0.41,pwm_left=141,pwm_right=141,battery_voltage=12.13
t=2993,target_linear_speed=2000,ideal_linear_speed=1465,measured_linear_speed=1403.77,left_measured_linear_speed=1362.56,right_measured_linear_speed=1444.98,ideal_angular_speed=0.00,measured_angular_speed=0.13,pwm_left=144,pwm_right=144,battery_voltage=12.13
t=2994,target_linear_speed=2000,ideal_linear_speed=1470,measured_linear_speed=1410.59,left_measured_linear_speed=1384.64,right_measured_linear_speed=1436.55,ideal_angular_speed=0.00,measured_angular_speed=0.14,pwm_left=144,pwm_right=144,battery_voltage=12.13
t=2995,target_linear_speed=2000,ideal_linear_speed=1475,measured_linear_speed=1423.06,left_measured_linear_speed=1388.27,right_measured_linear_speed=1457.85,ideal_angular_speed=0.00,measured_angular_speed=0.14,pwm_left=143,pwm_right=143,battery_voltage=12.13
t=2996,target_linear_speed=2000,ideal_linear_speed=1480,measured_linear_speed=1433.04,left_measured_linear_speed=1405.20,right_measured_linear_speed=1460.87,ideal_angular_speed=0.00,measured_angular_speed=1.05,pwm_left=143,pwm_right=143,battery_voltage=12.13
t=2997,target_linear_speed=2000,ideal_linear_speed=1485,measured_linear_speed=1434.00,left_measured_linear_speed=1404.72,right_measured_linear_speed=1463.28,ideal_angular_speed=0.00,measured_angular_speed=-0.47,pwm_left=145,pwm_right=145,battery_voltage=12.13
t=2998,target_linear_speed=2000,ideal_linear_speed=1490,measured_linear_speed=1441.79,left_measured_linear_speed=1418.37,right_measured_linear_speed=1465.22,ideal_angular_speed=0.00,measured_angular_speed=0.02,pwm_left=145,pwm_right=145,battery_voltage=12.13
t=2999,target_linear_speed=2000,ideal_linear_speed=1495,measured_linear_speed=1448.02,left_measured_linear_speed=1429.28,right_measured_linear_speed=1466.76,ideal_angular_speed=0.00,measured_angular_speed=0.22,pwm_left=145,pwm_right=145,battery_voltage=12.13
t=3000,target_linear_speed=2000,ideal_linear_speed=1500,measured_linear_speed=1445.99,left_measured_linear_speed=1423.98,right_measured_linear_speed=1468.00,ideal_angular_speed=0.00,measured_angular_speed=0.05,pwm_left=148,pwm_right=148,battery_voltage=12.13
t=3001,target_linear_speed=2000,ideal_linear_speed=1505,measured_linear_speed=1458.39,left_measured_linear_speed=1433.78,right_measured_linear_speed=1483.01,ideal_angular_speed=0.00,measured_angular_speed=0.73,pwm_left=372,pwm_right=-77,battery_voltage=12.12
t=3002,target_linear_speed=2000,ideal_linear_speed=1510,measured_linear_speed=1468.32,left_measured_linear_speed=1469.66,right_measured_linear_speed=1466.97,ideal_angular_speed=0.00,measured_angular_speed=-0.55,pwm_left=52,pwm_right=244,battery_voltage=12.03
t=3003,target_linear_speed=2000,ideal_linear_speed=1515,measured_linear_speed=1476.26,left_measured_linear_speed=1512.40,right_measured_linear_speed=1440.11,ideal_angular_speed=0.00,measured_angular_speed=-0.55,pwm_left=270,pwm_right=26,battery_voltage=12.02
t=3004,target_linear_speed=2000,ideal_linear_speed=1520,measured_linear_speed=1482.61,left_measured_linear_speed=1518.54,right_measured_linear_speed=1446.67,ideal_angular_speed=0.00,measured_angular_speed=-1.04,pwm_left=52,pwm_right=244,battery_voltage=12.03
t=3005,target_linear_speed=2000,ideal_linear_speed=1525,measured_linear_speed=1494.70,left_measured_linear_speed=1551.50,right_measured_linear_speed=1437.90,ideal_angular_speed=0.00,measured_angular_speed=-1.02,pwm_left=42,pwm_right=251,battery_voltage=12.03
t=3006,target_linear_speed=2000,ideal_linear_speed=1530,measured_linear_speed=1504.38,left_measured_linear_speed=1563.85,right_measured_linear_speed=1444.91,ideal_angular_speed=0.00,measured_angular_speed=-1.07,pwm_left=146,pwm_right=146,battery_voltage=12.04
t=3007,target_linear_speed=2000,ideal_linear_speed=1535,measured_linear_speed=1533.16,left_measured_linear_speed=1559.69,right_measured_linear_speed=1506.63,ideal_angular_speed=0.00,measured_angular_speed=-1.10,pwm_left=140,pwm_right=140,battery_voltage=12.04
t=3008,target_linear_speed=2000,ideal_linear_speed=1540,measured_linear_speed=1549.17,left_measured_linear_speed=1570.40,right_measured_linear_speed=1527.95,ideal_angular_speed=0.00,measured_angular_speed=-0.89,pwm_left=136,pwm_right=136,battery_voltage=12.05
t=3009,target_linear_speed=2000,ideal_linear_speed=1545,measured_linear_speed=1561.98,left_measured_linear_speed=1564.94,right_measured_linear_speed=1559.03,ideal_angular_speed=0.00,measured_angular_speed=-0.22,pwm_left=134,pwm_right=134,battery_voltage=12.05
t=3010,target_linear_speed=2000,ideal_linear_speed=1550,measured_linear_speed=1558.20,left_measured_linear_speed=1574.59,right_measured_linear_speed=1541.81,ideal_angular_speed=0.00,measured_angular_speed=-0.22,pwm_left=136,pwm_right=136,battery_voltage=12.06
t=3011,target_linear_speed=2000,ideal_linear_speed=1555,measured_linear_speed=1569.21,left_measured_linear_speed=1582.32,right_measured_linear_speed=1556.09,ideal_angular_speed=0.00,measured_angular_speed=0.77,pwm_left=134,pwm_right=134,battery_voltage=12.07
t=3012,target_linear_speed=2000,ideal_linear_speed=1560,measured_linear_speed=1578.01,left_measured_linear_speed=1630.58,right_measured_linear_speed=1525.43,ideal_angular_speed=0.00,measured_angular_speed=0.57,pwm_left=133,pwm_right=133,battery_voltage=12.08
t=3013,target_linear_speed=2000,ideal_linear_speed=1565,measured_linear_speed=1592.06,left_measured_linear_speed=1641.14,right_measured_linear_speed=1542.99,ideal_angular_speed=0.00,measured_angular_speed=-0.16,pwm_left=130,pwm_right=130,battery_voltage=12.08
t=3014,target_linear_speed=2000,ideal_linear_speed=1570,measured_linear_speed=1589.28,left_measured_linear_speed=1635.55,right_measured_linear_speed=1543.01,ideal_angular_speed=0.00,measured_angular_speed=-0.10,pwm_left=132,pwm_right=132,battery_voltage=12.08
t=3015,target_linear_speed=2000,ideal_linear_speed=1575,measured_linear_speed=1587.06,left_measured_linear_speed=1617.06,right_measured_linear_speed=1557.05,ideal_angular_speed=0.00,measured_angular_speed=0.57,pwm_left=133,pwm_right=133,battery_voltage=12.09
t=3016,target_linear_speed=2000,ideal_linear_speed=1580,measured_linear_speed=1578.26,left_measured_linear_speed=1602.26,right_measured_linear_speed=1554.26,ideal_angular_speed=0.00,measured_angular_speed=-0.19,pwm_left=137,pwm_right=137,battery_voltage=12.09
t=3017,target_linear_speed=2000,ideal_linear_speed=1585,measured_linear_speed=1571.22,left_measured_linear_speed=1576.40,right_measured_linear_speed=1566.05,ideal_angular_speed=0.00,measured_angular_speed=-0.19,pwm_left=140,pwm_right=140,battery_voltage=12.10
t=3018,target_linear_speed=2000,ideal_linear_speed=1590,measured_linear_speed=1579.62,left_measured_linear_speed=1569.74,right_measured_linear_speed=1589.51,ideal_angular_speed=0.00,measured_angular_speed=-0.50,pwm_left=139,pwm_right=139,battery_voltage=12.10
t=3019,target_linear_speed=2000,ideal_linear_speed=1595,measured_linear_speed=1565.30,left_measured_linear_speed=1522.32,right_measured_linear_speed=1608.28,ideal_angular_speed=0.00,measured_angular_speed=-0.37,pwm_left=145,pwm_right=145,battery_voltage=12.11
t=3020,target_linear_speed=2000,ideal_linear_speed=1600,measured_linear_speed=1560.86,left_measured_linear_speed=1540.50,right_measured_linear_speed=1581.21,ideal_angular_speed=0.00,measured_angular_speed=-0.40,pwm_left=148,pwm_right=148,battery_voltage=12.11
t=3021,target_linear_speed=2000,ideal_linear_speed=1605,measured_linear_speed=1571.33,left_measured_linear_speed=1555.04,right_measured_linear_speed=1587.61,ideal_angular_speed=0.00,measured_angular_speed=-0.17,pwm_left=147,pwm_right=147,battery_voltage=12.11
t=3022,target_linear_speed=2000,ideal_linear_speed=1610,measured_linear_speed=1579.71,left_measured_linear_speed=1594.74,right_measured_linear_speed=1564.68,ideal_angular_speed=0.00,measured_angular_speed=-0.87,pwm_left=147,pwm_right=147,battery_voltage=12.11
t=3023,target_linear_speed=2000,ideal_linear_speed=1615,measured_linear_speed=1593.42,left_measured_linear_speed=1598.43,right_measured_linear_speed=1588.42,ideal_angular_speed=0.00,measured_angular_speed=0.51,pwm_left=145,pwm_right=145,battery_voltage=12.11
t=3024,target_linear_speed=2000,ideal_linear_speed=1620,measured_linear_speed=1611.41,left_measured_linear_speed=1629.45,right_measured_linear_speed=1593.38,ideal_angular_speed=0.00,measured_angular_speed=0.04,pwm_left=142,pwm_right=142,battery_voltage=12.11
t=3025,target_linear_speed=2000,ideal_linear_speed=1625,measured_linear_speed=1604.76,left_measured_linear_speed=1612.17,right_measured_linear_speed=1597.35,ideal_angular_speed=0.00,measured_angular_speed=0.04,pwm_left=145,pwm_right=145,battery_voltage=12.11
t=3026,target_linear_speed=2000,ideal_linear_speed=1630,measured_linear_speed=1599.44,left_measured_linear_speed=1598.35,right_measured_linear_speed=1600.52,ideal_angular_speed=0.00,measured_angular_speed=-0.11,pwm_left=148,pwm_right=148,battery_voltage=12.12
t=3027,target_linear_speed=2000,ideal_linear_speed=1635,measured_linear_speed=1602.19,left_measured_linear_speed=1601.33,right_measured_linear_speed=1603.06,ideal_angular_speed=0.00,measured_angular_speed=0.30,pwm_left=149,pwm_right=149,battery_voltage=12.11
t=3028,target_linear_speed=2000,ideal_linear_speed=1640,measured_linear_speed=1604.40,left_measured_linear_speed=1603.71,right_measured_linear_speed=1605.09,ideal_angular_speed=0.00,measured_angular_speed=-0.32,pwm_left=151,pwm_right=151,battery_voltage=12.11
t=3029,target_linear_speed=2000,ideal_linear_speed=1645,measured_linear_speed=1613.18,left_measured_linear_speed=1591.58,right_measured_linear_speed=1634.77,ideal_angular_speed=0.00,measured_angular_speed=0.20,pwm_left=150,pwm_right=150,battery_voltage=12.11
t=3030,target_linear_speed=2000,ideal_linear_speed=1650,measured_linear_speed=1620.20,left_measured_linear_speed=1609.94,right_measured_linear_speed=1630.46,ideal_angular_speed=0.00,measured_angular_speed=0.42,pwm_left=150,pwm_right=150,battery_voltage=12.11
t=3031,target_linear_speed=2000,ideal_linear_speed=1655,measured_linear_speed=1611.79,left_measured_linear_speed=1610.59,right_measured_linear_speed=1612.99,ideal_angular_speed=0.00,measured_angular_speed=0.36,pwm_left=154,pwm_right=154,battery_voltage=12.11
t=3032,target_linear_speed=2000,ideal_linear_speed=1660,measured_linear_speed=1619.09,left_measured_linear_speed=1611.12,right_measured_linear_speed=1627.06,ideal_angular_speed=0.00,measured_angular_speed=0.36,pwm_left=155,pwm_right=155,battery_voltage=12.11
t=3033,target_linear_speed=2000,ideal_linear_speed=1665,measured_linear_speed=1624.93,left_measured_linear_speed=1611.54,right_measured_linear_speed=1638.32,ideal_angular_speed=0.00,measured_angular_speed=0.28,pwm_left=155,pwm_right=155,battery_voltage=12.11
t=3034,target_linear_speed=2000,ideal_linear_speed=1670,measured_linear_speed=1622.59,left_measured_linear_speed=1611.88,right_measured_linear_speed=1633.30,ideal_angular_speed=0.00,measured_angular_speed=-0.62,pwm_left=158,pwm_right=158,battery_voltage=12.11
t=3035,target_linear_speed=2000,ideal_linear_speed=1675,measured_linear_speed=1641.76,left_measured_linear_speed=1612.14,right_measured_linear_speed=1671.37,ideal_angular_speed=0.00,measured_angular_speed=0.46,pwm_left=155,pwm_right=155,battery_voltage=12.11
t=3036,target_linear_speed=2000,ideal_linear_speed=1680,measured_linear_speed=1643.06,left_measured_linear_speed=1612.36,right_measured_linear_speed=1673.77,ideal_angular_speed=0.00,measured_angular_speed=0.02,pwm_left=156,pwm_right=156,battery_voltage=12.11
t=3037,target_linear_speed=2000,ideal_linear_speed=1685,measured_linear_speed=1644.11,left_measured_linear_speed=1612.53,right_measured_linear_speed=1675.69,ideal_angular_speed=0.00,measured_angular_speed=0.49,pwm_left=158,pwm_right=158,battery_voltage=12.11
t=3038,target_linear_speed=2000,ideal_linear_speed=1690,measured_linear_speed=1637.93,left_measured_linear_speed=1612.67,right_measured_linear_speed=1663.19,ideal_angular_speed=0.00,measured_angular_speed=0.75,pwm_left=162,pwm_right=162,battery_voltage=12.11
t=3039,target_linear_speed=2000,ideal_linear_speed=1695,measured_linear_speed=1654.03,left_measured_linear_speed=1640.84,right_measured_linear_speed=1667.23,ideal_angular_speed=0.00,measured_angular_speed=-0.09,pwm_left=160,pwm_right=160,battery_voltage=12.11
t=3040,target_linear_speed=2000,ideal_linear_speed=1700,measured_linear_speed=1673.92,left_measured_linear_speed=1649.34,right_measured_linear_speed=1698.51,ideal_angular_speed=0.00,measured_angular_speed=-0.09,pwm_left=156,pwm_right=156,battery_voltage=12.10
t=3041,target_linear_speed=2000,ideal_linear_speed=1705,measured_linear_speed=1689.84,left_measured_linear_speed=1684.20,right_measured_linear_speed=1695.48,ideal_angular_speed=0.00,measured_angular_speed=0.30,pwm_left=154,pwm_right=154,battery_voltage=12.10
t=3042,target_linear_speed=2000,ideal_linear_speed=1710,measured_linear_speed=1681.53,left_measured_linear_speed=1670.00,right_measured_linear_speed=1693.06,ideal_angular_speed=0.00,measured_angular_speed=0.17,pwm_left=158,pwm_right=158,battery_voltage=12.10
t=3043,target_linear_speed=2000,ideal_linear_speed=1715,measured_linear_speed=1688.91,left_measured_linear_speed=1672.68,right_measured_linear_speed=1705.14,ideal_angular_speed=0.00,measured_angular_speed=0.05,pwm_left=158,pwm_right=158,battery_voltage=12.11
t=3044,target_linear_speed=2000,ideal_linear_speed=1720,measured_linear_speed=1694.81,left_measured_linear_speed=1688.84,right_measured_linear_speed=1700.79,ideal_angular_speed=0.00,measured_angular_speed=0.42,pwm_left=158,pwm_right=158,battery_voltage=12.11
t=3045,target_linear_speed=2000,ideal_linear_speed=1725,measured_linear_speed=1713.57,left_measured_linear_speed=1701.77,right_measured_linear_speed=1725.36,ideal_angular_speed=0.00,measured_angular_speed=-0.26,pwm_left=154,pwm_right=154,battery_voltage=12.11
t=3046,target_linear_speed=2000,ideal_linear_speed=1730,measured_linear_speed=1707.52,left_measured_linear_speed=1712.12,right_measured_linear_speed=1702.93,ideal_angular_speed=0.00,measured_angular_speed=0.32,pwm_left=158,pwm_right=158,battery_voltage=12.11
t=3047,target_linear_speed=2000,ideal_linear_speed=1735,measured_linear_speed=1723.73,left_measured_linear_speed=1720.39,right_measured_linear_speed=1727.07,ideal_angular_speed=0.00,measured_angular_speed=0.32,pwm_left=155,pwm_right=155,battery_voltage=12.10
t=3048,target_linear_speed=2000,ideal_linear_speed=1740,measured_linear_speed=1715.66,left_measured_linear_speed=1727.02,right_measured_linear_speed=1704.30,ideal_angular_speed=0.00,measured_angular_speed=-0.56,pwm_left=159,pwm_right=159,battery_voltage=12.10
t=3049,target_linear_speed=2000,ideal_linear_speed=1745,measured_linear_speed=1716.21,left_measured_linear_speed=1732.31,right_measured_linear_speed=1700.11,ideal_angular_speed=0.00,measured_angular_speed=0.13,pwm_left=160,pwm_right=160,battery_voltage=12.10
t=3050,target_linear_speed=2000,ideal_linear_speed=1750,measured_linear_speed=1737.70,left_measured_linear_speed=1750.58,right_measured_linear_speed=1724.82,ideal_angular_speed=0.00,measured_angular_speed=0.09,pwm_left=156,pwm_right=156,battery_voltage=12.10
t=3051,target_linear_speed=2000,ideal_linear_speed=1755,measured_linear_speed=1747.87,left_measured_linear_speed=1779.22,right_measured_linear_speed=1716.53,ideal_angular_speed=0.00,measured_angular_speed=-0.43,pwm_left=155,pwm_right=155,battery_voltage=12.10
t=3052,target_linear_speed=2000,ideal_linear_speed=1760,measured_linear_speed=1763.03,left_measured_linear_speed=1788.10,right_measured_linear_speed=1737.95,ideal_angular_speed=0.00,measured_angular_speed=-0.02,pwm_left=152,pwm_right=152,battery_voltage=12.10
t=3053,target_linear_speed=2000,ideal_linear_speed=1765,measured_linear_speed=1761.12,left_measured_linear_speed=1781.18,right_measured_linear_speed=1741.06,ideal_angular_speed=0.00,measured_angular_speed=-0.02,pwm_left=154,pwm_right=154,battery_voltage=12.10
t=3054,target_linear_speed=2000,ideal_linear_speed=1770,measured_linear_speed=1766.61,left_measured_linear_speed=1775.65,right_measured_linear_speed=1757.58,ideal_angular_speed=0.00,measured_angular_speed=-0.30,pwm_left=154,pwm_right=154,battery_voltage=12.10
t=3055,target_linear_speed=2000,ideal_linear_speed=1775,measured_linear_speed=1778.02,left_measured_linear_speed=1799.27,right_measured_linear_speed=1756.76,ideal_angular_speed=0.00,measured_angular_speed=-0.30,pwm_left=152,pwm_right=152,battery_voltage=12.10
t=3056,target_linear_speed=2000,ideal_linear_speed=1780,measured_linear_speed=1787.14,left_measured_linear_speed=1818.17,right_measured_linear_speed=1756.11,ideal_angular_speed=0.00,measured_angular_speed=0.25,pwm_left=151,pwm_right=151,battery_voltage=12.10
t=3057,target_linear_speed=2000,ideal_linear_speed=1785,measured_linear_speed=1787.43,left_measured_linear_speed=1833.30,right_measured_linear_speed=1741.56,ideal_angular_speed=0.00,measured_angular_speed=-0.12,pwm_left=152,pwm_right=152,battery_voltage=12.10
t=3058,target_linear_speed=2000,ideal_linear_speed=1790,measured_linear_speed=1794.67,left_measured_linear_speed=1831.36,right_measured_linear_speed=1757.98,ideal_angular_speed=0.00,measured_angular_speed=0.14,pwm_left=152,pwm_right=152,battery_voltage=12.10
t=3059,target_linear_speed=2000,ideal_linear_speed=1795,measured_linear_speed=1779.42,left_measured_linear_speed=1801.76,right_measured_linear_speed=1757.08,ideal_angular_speed=0.00,measured_angular_speed=-0.20,pwm_left=157,pwm_right=157,battery_voltage=12.10
t=3060,target_linear_speed=2000,ideal_linear_speed=1800,measured_linear_speed=1795.28,left_measured_linear_speed=1792.11,right_measured_linear_speed=1798.45,ideal_angular_speed=0.00,measured_angular_speed=-0.06,pwm_left=155,pwm_right=155,battery_voltage=12.10
t=3061,target_linear_speed=2000,ideal_linear_speed=1805,measured_linear_speed=1800.95,left_measured_linear_speed=1798.42,right_measured_linear_speed=1803.49,ideal_angular_speed=0.00,measured_angular_speed=-0.02,pwm_left=154,pwm_right=154,battery_voltage=12.10
t=3062,target_linear_speed=2000,ideal_linear_speed=1810,measured_linear_speed=1791.46,left_measured_linear_speed=1789.43,right_measured_linear_speed=1793.49,ideal_angular_speed=0.00,measured_angular_speed=-0.02,pwm_left=159,pwm_right=159,battery_voltage=12.10
t=3063,target_linear_speed=2000,ideal_linear_speed=1815,measured_linear_speed=1783.87,left_measured_linear_speed=1782.25,right_measured_linear_speed=1785.49,ideal_angular_speed=0.00,measured_angular_speed=-0.41,pwm_left=162,pwm_right=162,battery_voltage=12.10
t=3064,target_linear_speed=2000,ideal_linear_speed=1820,measured_linear_speed=1798.84,left_measured_linear_speed=1804.55,right_measured_linear_speed=1793.12,ideal_angular_speed=0.00,measured_angular_speed=0.32,pwm_left=160,pwm_right=160,battery_voltage=12.10
t=3065,target_linear_speed=2000,ideal_linear_speed=1825,measured_linear_speed=1817.83,left_measured_linear_speed=1822.40,right_measured_linear_speed=1813.25,ideal_angular_speed=0.00,measured_angular_speed=-0.15,pwm_left=157,pwm_right=157,battery_voltage=12.10
t=3066,target_linear_speed=2000,ideal_linear_speed=1830,measured_linear_speed=1833.02,left_measured_linear_speed=1836.67,right_measured_linear_speed=1829.36,ideal_angular_speed=0.00,measured_angular_speed=0.58,pwm_left=154,pwm_right=154,battery_voltage=12.10
t=3067,target_linear_speed=2000,ideal_linear_speed=1835,measured_linear_speed=1824.13,left_measured_linear_speed=1820.04,right_measured_linear_speed=1828.21,ideal_angular_speed=0.00,measured_angular_speed=0.53,pwm_left=158,pwm_right=158,battery_voltage=12.10
t=3068,target_linear_speed=2000,ideal_linear_speed=1840,measured_linear_speed=1831.04,left_measured_linear_speed=1820.76,right_measured_linear_speed=1841.33,ideal_angular_speed=0.00,measured_angular_speed=-0.17,pwm_left=157,pwm_right=157,battery_voltage=12.10
t=3069,target_linear_speed=2000,ideal_linear_speed=1845,measured_linear_speed=1829.56,left_measured_linear_speed=1821.34,right_measured_linear_speed=1837.79,ideal_angular_speed=0.00,measured_angular_speed=0.30,pwm_left=385,pwm_right=-65,battery_voltage=12.10
t=3070,target_linear_speed=2000,ideal_linear_speed=1850,measured_linear_speed=1842.41,left_measured_linear_speed=1835.82,right_measured_linear_speed=1848.99,ideal_angular_speed=0.00,measured_angular_speed=0.30,pwm_left=63,pwm_right=255,battery_voltage=12.01
t=3071,target_linear_speed=2000,ideal_linear_speed=1855,measured_linear_speed=1866.71,left_measured_linear_speed=1903.53,right_measured_linear_speed=1829.89,ideal_angular_speed=0.00,measured_angular_speed=-0.38,pwm_left=49,pwm_right=258,battery_voltage=12.00
t=3072,target_linear_speed=2000,ideal_linear_speed=1860,measured_linear_speed=1858.10,left_measured_linear_speed=1887.55,right_measured_linear_speed=1828.64,ideal_angular_speed=0.00,measured_angular_speed=0.48,pwm_left=157,pwm_right=157,battery_voltage=12.01
t=3073,target_linear_speed=2000,ideal_linear_speed=1865,measured_linear_speed=1844.19,left_measured_linear_speed=1846.71,right_measured_linear_speed=1841.67,ideal_angular_speed=0.00,measured_angular_speed=-0.38,pwm_left=49,pwm_right=276,battery_voltage=12.01
t=3074,target_linear_speed=2000,ideal_linear_speed=1870,measured_linear_speed=1875.15,left_measured_linear_speed=1856.13,right_measured_linear_speed=1894.17,ideal_angular_speed=0.00,measured_angular_speed=-0.57,pwm_left=147,pwm_right=164,battery_voltage=12.02
t=3075,target_linear_speed=2000,ideal_linear_speed=1875,measured_linear_speed=1885.89,left_measured_linear_speed=1849.63,right_measured_linear_speed=1922.15,ideal_angular_speed=0.00,measured_angular_speed=-0.14,pwm_left=145,pwm_right=162,battery_voltage=12.03
t=3076,target_linear_speed=2000,ideal_linear_speed=1880,measured_linear_speed=1866.43,left_measured_linear_speed=1816.38,right_measured_linear_speed=1916.48,ideal_angular_speed=0.00,measured_angular_speed=1.29,pwm_left=151,pwm_right=169,battery_voltage=12.03
t=3077,target_linear_speed=2000,ideal_linear_speed=1885,measured_linear_speed=1857.87,left_measured_linear_speed=1803.80,right_measured_linear_speed=1911.94,ideal_angular_speed=0.00,measured_angular_speed=1.29,pwm_left=155,pwm_right=173,battery_voltage=12.04
t=3078,target_linear_speed=2000,ideal_linear_speed=1890,measured_linear_speed=1851.02,left_measured_linear_speed=1793.74,right_measured_linear_speed=1908.31,ideal_angular_speed=0.00,measured_angular_speed=1.13,pwm_left=159,pwm_right=176,battery_voltage=12.04
t=3079,target_linear_speed=2000,ideal_linear_speed=1895,measured_linear_speed=1866.59,left_measured_linear_speed=1799.72,right_measured_linear_speed=1933.46,ideal_angular_speed=0.00,measured_angular_speed=0.47,pwm_left=157,pwm_right=174,battery_voltage=12.05
t=3080,target_linear_speed=2000,ideal_linear_speed=1900,measured_linear_speed=1886.05,left_measured_linear_speed=1846.59,right_measured_linear_speed=1925.52,ideal_angular_speed=0.00,measured_angular_speed=1.01,pwm_left=153,pwm_right=171,battery_voltage=12.05
t=3081,target_linear_speed=2000,ideal_linear_speed=1905,measured_linear_speed=1887.60,left_measured_linear_speed=1827.97,right_measured_linear_speed=1947.23,ideal_angular_speed=0.00,measured_angular_speed=0.93,pwm_left=154,pwm_right=172,battery_voltage=12.06
t=3082,target_linear_speed=2000,ideal_linear_speed=1910,measured_linear_speed=1881.82,left_measured_linear_speed=1827.10,right_measured_linear_speed=1936.54,ideal_angular_speed=0.00,measured_angular_speed=0.64,pwm_left=157,pwm_right=175,battery_voltage=12.06
t=3083,target_linear_speed=2000,ideal_linear_speed=1915,measured_linear_speed=1877.20,left_measured_linear_speed=1812.38,right_measured_linear_speed=1942.02,ideal_angular_speed=0.00,measured_angular_speed=1.02,pwm_left=161,pwm_right=178,battery_voltage=12.06
t=3084,target_linear_speed=2000,ideal_linear_speed=1920,measured_linear_speed=1894.54,left_measured_linear_speed=1828.66,right_measured_linear_speed=1960.42,ideal_angular_speed=0.00,measured_angular_speed=1.02,pwm_left=158,pwm_right=175,battery_voltage=12.07
t=3085,target_linear_speed=2000,ideal_linear_speed=1925,measured_linear_speed=1894.39,left_measured_linear_speed=1841.69,right_measured_linear_speed=1947.10,ideal_angular_speed=0.00,measured_angular_speed=0.72,pwm_left=386,pwm_right=-48,battery_voltage=12.06
t=3086,target_linear_speed=2000,ideal_linear_speed=1930,measured_linear_speed=1894.27,left_measured_linear_speed=1852.10,right_measured_linear_speed=1936.43,ideal_angular_speed=0.00,measured_angular_speed=-0.50,pwm_left=295,pwm_right=49,battery_voltage=11.95
t=3087,target_linear_speed=2000,ideal_linear_speed=1935,measured_linear_speed=1894.17,left_measured_linear_speed=1902.52,right_measured_linear_speed=1885.82,ideal_angular_speed=0.00,measured_angular_speed=-0.18,pwm_left=306,pwm_right=42,battery_voltage=11.94
t=3088,target_linear_speed=2000,ideal_linear_speed=1940,measured_linear_speed=1922.15,left_measured_linear_speed=1984.94,right_measured_linear_speed=1859.35,ideal_angular_speed=0.00,measured_angular_speed=-0.20,pwm_left=-33,pwm_right=370,battery_voltage=11.94
t=3089,target_linear_speed=2000,ideal_linear_speed=1945,measured_linear_speed=1951.55,left_measured_linear_speed=2036.85,right_measured_linear_speed=1866.24,ideal_angular_speed=0.00,measured_angular_speed=-0.12,pwm_left=56,pwm_right=267,battery_voltage=11.95
t=3090,target_linear_speed=2000,ideal_linear_speed=1950,measured_linear_speed=1939.99,left_measured_linear_speed=2008.24,right_measured_linear_speed=1871.75,ideal_angular_speed=0.00,measured_angular_speed=-1.19,pwm_left=166,pwm_right=166,battery_voltage=11.95
t=3091,target_linear_speed=2000,ideal_linear_speed=1955,measured_linear_speed=1965.82,left_measured_linear_speed=1971.32,right_measured_linear_speed=1960.32,ideal_angular_speed=0.00,measured_angular_speed=-2.09,pwm_left=161,pwm_right=161,battery_voltage=11.96
t=3092,target_linear_speed=2000,ideal_linear_speed=1960,measured_linear_speed=1965.44,left_measured_linear_speed=1969.84,right_measured_linear_speed=1961.04,ideal_angular_speed=0.00,measured_angular_speed=-2.09,pwm_left=162,pwm_right=162,battery_voltage=11.97
t=3093,target_linear_speed=2000,ideal_linear_speed=1965,measured_linear_speed=1965.14,left_measured_linear_speed=1968.65,right_measured_linear_speed=1961.62,ideal_angular_speed=0.00,measured_angular_speed=-0.51,pwm_left=163,pwm_right=163,battery_voltage=11.98
t=3094,target_linear_speed=2000,ideal_linear_speed=1970,measured_linear_speed=1971.91,left_measured_linear_speed=1995.76,right_measured_linear_speed=1948.05,ideal_angular_speed=0.00,measured_angular_speed=-0.28,pwm_left=162,pwm_right=162,battery_voltage=11.98
t=3095,target_linear_speed=2000,ideal_linear_speed=1975,measured_linear_speed=1977.32,left_measured_linear_speed=2003.42,right_measured_linear_speed=1951.22,ideal_angular_speed=0.00,measured_angular_speed=-0.12,pwm_left=162,pwm_right=162,battery_voltage=11.99
t=3096,target_linear_speed=2000,ideal_linear_speed=1980,measured_linear_speed=1967.63,left_measured_linear_speed=1995.52,right_measured_linear_speed=1939.73,ideal_angular_speed=0.00,measured_angular_speed=0.06,pwm_left=166,pwm_right=166,battery_voltage=12.00
t=3097,target_linear_speed=2000,ideal_linear_speed=1985,measured_linear_speed=1973.90,left_measured_linear_speed=1989.20,right_measured_linear_speed=1958.60,ideal_angular_speed=0.00,measured_angular_speed=-0.02,pwm_left=166,pwm_right=166,battery_voltage=12.01
t=3098,target_linear_speed=2000,ideal_linear_speed=1990,measured_linear_speed=1978.92,left_measured_linear_speed=1970.12,right_measured_linear_speed=1987.72,ideal_angular_speed=0.00,measured_angular_speed=0.21,pwm_left=166,pwm_right=166,battery_voltage=12.02
t=3099,target_linear_speed=2000,ideal_linear_speed=1995,measured_linear_speed=1982.93,left_measured_linear_speed=1982.91,right_measured_linear_speed=1982.96,ideal_angular_speed=0.00,measured_angular_speed=0.21,pwm_left=166,pwm_right=166,battery_voltage=12.02
t=3100,target_linear_speed=2000,ideal_linear_speed=2000,measured_linear_speed=1965.10,left_measured_linear_speed=1965.08,right_measured_linear_speed=1965.12,ideal_angular_speed=0.00,measured_angular_speed=-0.20,pwm_left=173,pwm_right=173,battery_voltage=12.03
t=3101,target_linear_speed=2000,ideal_linear_speed=2000,measured_linear_speed=1971.88,left_measured_linear_speed=1978.88,right_measured_linear_speed=1964.88,ideal_angular_speed=0.00,measured_angular_speed=0.14,pwm_left=172,pwm_right=172,battery_voltage=12.03
t=3102,target_linear_speed=2000,ideal_linear_speed=2000,measured_linear_speed=1984.32,left_measured_linear_speed=1975.89,right_measured_linear_speed=1992.75,ideal_angular_speed=0.00,measured_angular_speed=-0.09,pwm_left=168,pwm_right=168,battery_voltage=12.04
t=3103,target_linear_speed=2000,ideal_linear_speed=2000,measured_linear_speed=2001.28,left_measured_linear_speed=2001.55,right_measured_linear_speed=2001.01,ideal_angular_speed=0.00,measured_angular_speed=1.12,pwm_left=164,pwm_right=164,battery_voltage=12.04
t=3104,target_linear_speed=2000,ideal_linear_speed=2000,measured_linear_speed=2014.85,left_measured_linear_speed=2008.05,right_measured_linear_speed=2021.65,ideal_angular_speed=0.00,measured_angular_speed=0.30,pwm_left=160,pwm_right=160,battery_voltage=12.04
t=3105,target_linear_speed=2000,ideal_linear_speed=2000,measured_linear_speed=2011.68,left_measured_linear_speed=1999.22,right_measured_linear_speed=2024.13,ideal_angular_speed=0.00,measured_angular_speed=-0.64,pwm_left=161,pwm_right=161,battery_voltage=12.05
t=3106,target_linear_speed=2000,ideal_linear_speed=2000,measured_linear_speed=2009.14,left_measured_linear_speed=1992.16,right_measured_linear_speed=2026.12,ideal_angular_speed=0.00,measured_angular_speed=-0.20,pwm_left=161,pwm_right=161,battery_voltage=12.05
t=3107,target_linear_speed=2000,ideal_linear_speed=2000,measured_linear_speed=2014.12,left_measured_linear_speed=2000.54,right_measured_linear_speed=2027.70,ideal_angular_speed=0.00,measured_angular_speed=-0.20,pwm_left=160,pwm_right=160,battery_voltage=12.05
t=3108,target_linear_speed=2000,ideal_linear_speed=2000,measured_linear_speed=2011.10,left_measured_linear_speed=2007.25,right_measured_linear_speed=2014.95,ideal_angular_speed=0.00,measured_angular_speed=-0.37,pwm_left=160,pwm_right=160,battery_voltage=12.06
t=3109,target_linear_speed=2000,ideal_linear_speed=2000,measured_linear_speed=2015.69,left_measured_linear_speed=2026.64,right_measured_linear_speed=2004.74,ideal_angular_speed=0.00,measured_angular_speed=0.19,pwm_left=159,pwm_right=159,battery_voltage=12.06
t=3110,target_linear_speed=2000,ideal_linear_speed=2000,measured_linear_speed=2026.38,left_measured_linear_speed=2014.09,right_measured_linear_speed=2038.66,ideal_angular_speed=0.00,measured_angular_speed=0.43,pwm_left=155,pwm_right=155,battery_voltage=12.07
t=3111,target_linear_speed=2000,ideal_linear_speed=2000,measured_linear_speed=2027.91,left_measured_linear_speed=2004.06,right_measured_linear_speed=2051.77,ideal_angular_speed=0.00,measured_angular_speed=0.40,pwm_left=154,pwm_right=154,battery_voltage=12.07
t=3112,target_linear_speed=2000,ideal_linear_speed=2000,measured_linear_speed=2015.12,left_measured_linear_speed=1982.00,right_measured_linear_speed=2048.23,ideal_angular_speed=0.00,measured_angular_speed=0.59,pwm_left=157,pwm_right=157,battery_voltage=12.07
t=3113,target_linear_speed=2000,ideal_linear_speed=2000,measured_linear_speed=2004.88,left_measured_linear_speed=1964.36,right_measured_linear_speed=2045.39,ideal_angular_speed=0.00,measured_angular_speed=0.07,pwm_left=160,pwm_right=160,battery_voltage=12.08
t=3114,target_linear_speed=2000,ideal_linear_speed=2000,measured_linear_speed=2003.70,left_measured_linear_speed=1964.27,right_measured_linear_speed=2043.13,ideal_angular_speed=0.00,measured_angular_speed=0.07,pwm_left=160,pwm_right=160,battery_voltage=12.08
t=3115,target_linear_speed=2000,ideal_linear_speed=2000,measured_linear_speed=2016.79,left_measured_linear_speed=1978.23,right_measured_linear_speed=2055.34,ideal_angular_speed=0.00,measured_angular_speed=0.21,pwm_left=156,pwm_right=156,battery_voltage=12.08
t=3116,target_linear_speed=2000,ideal_linear_speed=2000,measured_linear_speed=2020.24,left_measured_linear_speed=1989.39,right_measured_linear_speed=2051.09,ideal_angular_speed=0.00,measured_angular_speed=0.25,pwm_left=155,pwm_right=155,battery_voltage=12.08
t=3117,target_linear_speed=2000,ideal_linear_speed=2000,measured_linear_speed=2023.00,left_measured_linear_speed=1998.33,right_measured_linear_speed=2047.68,ideal_angular_speed=0.00,measured_angular_speed=-0.41,pwm_left=154,pwm_right=154,battery_voltage=12.08
t=3118,target_linear_speed=2000,ideal_linear_speed=2000,measured_linear_speed=2011.19,left_measured_linear_speed=1991.45,right_measured_linear_speed=2030.93,ideal_angular_speed=0.00,measured_angular_speed=0.47,pwm_left=157,pwm_right=157,battery_voltage=12.08
t=3119,target_linear_speed=2000,ideal_linear_speed=2000,measured_linear_speed=2008.75,left_measured_linear_speed=1999.97,right_measured_linear_speed=2017.53,ideal_angular_speed=0.00,measured_angular_speed=-0.18,pwm_left=157,pwm_right=157,battery_voltage=12.09
t=3120,target_linear_speed=2000,ideal_linear_speed=2000,measured_linear_speed=2013.81,left_measured_linear_speed=1978.73,right_measured_linear_speed=2048.89,ideal_angular_speed=0.00,measured_angular_speed=-0.29,pwm_left=156,pwm_right=156,battery_voltage=12.09
t=3121,target_linear_speed=2000,ideal_linear_speed=2000,measured_linear_speed=2017.86,left_measured_linear_speed=2017.85,right_measured_linear_speed=2017.87,ideal_angular_speed=0.00,measured_angular_speed=-0.31,pwm_left=154,pwm_right=154,battery_voltage=12.09
t=3122,target_linear_speed=2000,ideal_linear_speed=2000,measured_linear_speed=2014.09,left_measured_linear_speed=2007.07,right_measured_linear_speed=2021.11,ideal_angular_speed=0.00,measured_angular_speed=-0.31,pwm_left=381,pwm_right=-70,battery_voltage=12.09
t=3123,target_linear_speed=2000,ideal_linear_speed=2000,measured_linear_speed=2018.08,left_measured_linear_speed=2026.49,right_measured_linear_speed=2009.67,ideal_angular_speed=0.00,measured_angular_speed=-0.29,pwm_left=58,pwm_right=249,battery_voltage=12.08
t=3124,target_linear_speed=2000,ideal_linear_speed=2000,measured_linear_speed=2035.30,left_measured_linear_speed=2084.12,right_measured_linear_speed=1986.49,ideal_angular_speed=0.00,measured_angular_speed=0.88,pwm_left=45,pwm_right=253,battery_voltage=12.07
t=3125,target_linear_speed=2000,ideal_linear_speed=2000,measured_linear_speed=2042.07,left_measured_linear_speed=2102.16,right_measured_linear_speed=1981.98,ideal_angular_speed=0.00,measured_angular_speed=-1.67,pwm_left=146,pwm_right=146,battery_voltage=12.07
t=3126,target_linear_speed=2000,ideal_linear_speed=2000,measured_linear_speed=2033.45,left_measured_linear_speed=2074.51,right_measured_linear_speed=1992.39,ideal_angular_speed=0.00,measured_angular_speed=-0.99,pwm_left=148,pwm_right=148,battery_voltage=12.06
t=3127,target_linear_speed=2000,ideal_linear_speed=2000,measured_linear_speed=2033.58,left_measured_linear_speed=2066.42,right_measured_linear_speed=2000.73,ideal_angular_speed=0.00,measured_angular_speed=-1.04,pwm_left=147,pwm_right=147,battery_voltage=12.07
t=3128,target_linear_speed=2000,ideal_linear_speed=2000,measured_linear_speed=2047.70,left_measured_linear_speed=2073.98,right_measured_linear_speed=2021.42,ideal_angular_speed=0.00,measured_angular_speed=-0.31,pwm_left=143,pwm_right=143,battery_voltage=12.07
t=3129,target_linear_speed=2000,ideal_linear_speed=2000,measured_linear_speed=2066.01,left_measured_linear_speed=2108.08,right_measured_linear_speed=2023.95,ideal_angular_speed=0.00,measured_angular_speed=-0.31,pwm_left=137,pwm_right=137,battery_voltage=12.08
t=3130,target_linear_speed=2000,ideal_linear_speed=2000,measured_linear_speed=2059.62,left_measured_linear_speed=2093.28,right_measured_linear_speed=2025.97,ideal_angular_speed=0.00,measured_angular_speed=0.95,pwm_left=137,pwm_right=137,battery_voltage=12.08
t=3131,target_linear_speed=2000,ideal_linear_speed=2000,measured_linear_speed=2054.51,left_measured_linear_speed=2081.43,right_measured_linear_speed=2027.59,ideal_angular_speed=0.00,measured_angular_speed=-0.30,pwm_left=138,pwm_right=138,battery_voltage=12.09
t=3132,target_linear_speed=2000,ideal_linear_speed=2000,measured_linear_speed=2050.42,left_measured_linear_speed=2085.99,right_measured_linear_speed=2014.86,ideal_angular_speed=0.00,measured_angular_speed=-1.08,pwm_left=138,pwm_right=138,battery_voltage=12.09
t=3133,target_linear_speed=2000,ideal_linear_speed=2000,measured_linear_speed=2054.16,left_measured_linear_speed=2047.54,right_measured_linear_speed=2060.78,ideal_angular_speed=0.00,measured_angular_speed=-0.08,pwm_left=136,pwm_right=136,battery_voltage=12.09
t=3134,target_linear_speed=2000,ideal_linear_speed=2000,measured_linear_speed=2050.14,left_measured_linear_speed=2058.88,right_measured_linear_speed=2041.41,ideal_angular_speed=0.00,measured_angular_speed=-0.44,pwm_left=136,pwm_right=136,battery_voltage=12.10
t=3135,target_linear_speed=2000,ideal_linear_speed=2000,measured_linear_speed=2046.93,left_measured_linear_speed=2053.91,right_measured_linear_speed=2039.94,ideal_angular_speed=0.00,measured_angular_speed=-0.15,pwm_left=136,pwm_right=136,battery_voltage=12.10
t=3136,target_linear_speed=2000,ideal_linear_speed=2000,measured_linear_speed=2044.35,left_measured_linear_speed=2049.94,right_measured_linear_speed=2038.76,ideal_angular_speed=0.00,measured_angular_speed=-0.10,pwm_left=136,pwm_right=136,battery_voltage=12.10
t=3137,target_linear_speed=2000,ideal_linear_speed=2000,measured_linear_speed=2042.29,left_measured_linear_speed=2046.77,right_measured_linear_speed=2037.82,ideal_angular_speed=0.00,measured_angular_speed=-0.10,pwm_left=136,pwm_right=136,battery_voltage=12.11
t=3138,target_linear_speed=2000,ideal_linear_speed=2000,measured_linear_speed=2047.66,left_measured_linear_speed=2058.25,right_measured_linear_speed=2037.07,ideal_angular_speed=0.00,measured_angular_speed=0.76,pwm_left=133,pwm_right=133,battery_voltage=12.11
t=3139,target_linear_speed=2000,ideal_linear_speed=2000,measured_linear_speed=2058.97,left_measured_linear_speed=2067.44,right_measured_linear_speed=2050.50,ideal_angular_speed=0.00,measured_angular_speed=0.29,pwm_left=130,pwm_right=130,battery_voltage=12.11
t=3140,target_linear_speed=2000,ideal_linear_speed=2000,measured_linear_speed=2046.97,left_measured_linear_speed=2046.74,right_measured_linear_speed=2047.21,ideal_angular_speed=0.00,measured_angular_speed=-0.34,pwm_left=132,pwm_right=132,battery_voltage=12.11
t=3141,target_linear_speed=2000,ideal_linear_speed=2000,measured_linear_speed=2037.38,left_measured_linear_speed=2030.17,right_measured_linear_speed=2044.58,ideal_angular_speed=0.00,measured_angular_speed=-0.06,pwm_left=134,pwm_right=134,battery_voltage=12.12
t=3142,target_linear_speed=2000,ideal_linear_speed=2000,measured_linear_speed=2043.73,left_measured_linear_speed=2044.98,right_measured_linear_speed=2042.48,ideal_angular_speed=0.00,measured_angular_speed=-0.92,pwm_left=131,pwm_right=131,battery_voltage=12.12
t=3143,target_linear_speed=2000,ideal_linear_speed=2000,measured_linear_speed=2034.78,left_measured_linear_speed=2028.77,right_measured_linear_speed=2040.79,ideal_angular_speed=0.00,measured_angular_speed=0.03,pwm_left=133,pwm_right=133,battery_voltage=12.12
t=3144,target_linear_speed=2000,ideal_linear_speed=2000,measured_linear_speed=2027.62,left_measured_linear_speed=2029.83,right_measured_linear_speed=2025.42,ideal_angular_speed=0.00,measured_angular_speed=0.03,pwm_left=134,pwm_right=134,battery_voltage=12.12
t=3145,target_linear_speed=2000,ideal_linear_speed=2000,measured_linear_speed=2014.88,left_measured_linear_speed=2016.64,right_measured_linear_speed=2013.12,ideal_angular_speed=0.00,measured_angular_speed=0.21,pwm_left=137,pwm_right=137,battery_voltage=12.12
t=3146,target_linear_speed=2000,ideal_linear_speed=2000,measured_linear_speed=2018.72,left_measured_linear_speed=2006.10,right_measured_linear_speed=2031.33,ideal_angular_speed=0.00,measured_angular_speed=0.53,pwm_left=136,pwm_right=136,battery_voltage=12.13
t=3147,target_linear_speed=2000,ideal_linear_speed=2000,measured_linear_speed=2007.76,left_measured_linear_speed=1997.66,right_measured_linear_speed=2017.85,ideal_angular_speed=0.00,measured_angular_speed=1.04,pwm_left=139,pwm_right=139,battery_voltage=12.13
t=3148,target_linear_speed=2000,ideal_linear_speed=2000,measured_linear_speed=1998.99,left_measured_linear_speed=1976.89,right_measured_linear_speed=2021.09,ideal_angular_speed=0.00,measured_angular_speed=-0.04,pwm_left=141,pwm_right=141,battery_voltage=12.13
t=3149,target_linear_speed=2000,ideal_linear_speed=2000,measured_linear_speed=1984.96,left_measured_linear_speed=1946.24,right_measured_linear_speed=2023.69,ideal_angular_speed=0.00,measured_angular_speed=0.52,pwm_left=145,pwm_right=145,battery_voltage=12.13
t=3150,target_linear_speed=2000,ideal_linear_speed=2000,measured_linear_speed=1994.78,left_measured_linear_speed=1963.80,right_measured_linear_speed=2025.76,ideal_angular_speed=0.00,measured_angular_speed=-0.11,pwm_left=142,pwm_right=142,battery_voltage=12.13
t=3151,target_linear_speed=2000,ideal_linear_speed=2000,measured_linear_speed=1995.62,left_measured_linear_speed=1977.85,right_measured_linear_speed=2013.39,ideal_angular_speed=0.00,measured_angular_speed=-0.11,pwm_left=142,pwm_right=142,battery_voltage=12.13
t=3152,target_linear_speed=2000,ideal_linear_speed=2000,measured_linear_speed=1996.30,left_measured_linear_speed=1975.07,right_measured_linear_speed=2017.53,ideal_angular_speed=0.00,measured_angular_speed=-0.39,pwm_left=142,pwm_right=142,battery_voltage=12.13
t=3153,target_linear_speed=2000,ideal_linear_speed=2000,measured_linear_speed=1989.82,left_measured_linear_speed=1972.84,right_measured_linear_speed=2006.81,ideal_angular_speed=0.00,measured_angular_speed=-0.13,pwm_left=144,pwm_right=144,battery_voltage=12.13
t=3154,target_linear_speed=2000,ideal_linear_speed=2000,measured_linear_speed=1984.64,left_measured_linear_speed=1971.05,right_measured_linear_speed=1998.23,ideal_angular_speed=0.00,measured_angular_speed=0.12,pwm_left=146,pwm_right=146,battery_voltage=12.13
t=3155,target_linear_speed=2000,ideal_linear_speed=2000,measured_linear_speed=1980.50,left_measured_linear_speed=1955.60,right_measured_linear_speed=2005.39,ideal_angular_speed=0.00,measured_angular_speed=0.06,pwm_left=147,pwm_right=147,battery_voltage=12.13
t=3156,target_linear_speed=2000,ideal_linear_speed=2000,measured_linear_speed=1991.21,left_measured_linear_speed=1985.32,right_measured_linear_speed=1997.10,ideal_angular_speed=0.00,measured_angular_speed=-0.84,pwm_left=144,pwm_right=144,battery_voltage=12.13
t=3157,target_linear_speed=2000,ideal_linear_speed=2000,measured_linear_speed=1985.75,left_measured_linear_speed=1981.04,right_measured_linear_speed=1990.46,ideal_angular_speed=0.00,measured_angular_speed=-0.48,pwm_left=146,pwm_right=146,battery_voltage=12.13
t=3158,target_linear_speed=2000,ideal_linear_speed=2000,measured_linear_speed=1988.40,left_measured_linear_speed=1991.64,right_measured_linear_speed=1985.15,ideal_angular_speed=0.00,measured_angular_speed=0.73,pwm_left=146,pwm_right=146,battery_voltage=12.13
t=3159,target_linear_speed=2000,ideal_linear_speed=2000,measured_linear_speed=1997.53,left_measured_linear_speed=2000.13,right_measured_linear_speed=1994.94,ideal_angular_speed=0.00,measured_angular_speed=0.73,pwm_left=143,pwm_right=143,battery_voltage=12.13
t=3160,target_linear_speed=2000,ideal_linear_speed=2000,measured_linear_speed=2004.84,left_measured_linear_speed=2020.94,right_measured_linear_speed=1988.73,ideal_angular_speed=0.00,measured_angular_speed=-0.21,pwm_left=141,pwm_right=141,battery_voltage=12.13
t=3161,target_linear_speed=2000,ideal_linear_speed=2000,measured_linear_speed=1996.65,left_measured_linear_speed=2009.54,right_measured_linear_speed=1983.77,ideal_angular_speed=0.00,measured_angular_speed=-0.16,pwm_left=143,pwm_right=143,battery_voltage=12.13
t=3162,target_linear_speed=2000,ideal_linear_speed=2000,measured_linear_speed=2004.14,left_measured_linear_speed=2014.44,right_measured_linear_speed=1993.83,ideal_angular_speed=0.00,measured_angular_speed=0.26,pwm_left=141,pwm_right=141,battery_voltage=12.13
t=3163,target_linear_speed=2000,ideal_linear_speed=2000,measured_linear_speed=2003.11,left_measured_linear_speed=2018.37,right_measured_linear_speed=1987.85,ideal_angular_speed=0.00,measured_angular_speed=0.34,pwm_left=142,pwm_right=142,battery_voltage=12.13
t=3164,target_linear_speed=2000,ideal_linear_speed=2000,measured_linear_speed=2016.31,left_measured_linear_speed=2021.50,right_measured_linear_speed=2011.12,ideal_angular_speed=0.00,measured_angular_speed=-0.35,pwm_left=138,pwm_right=138,battery_voltage=12.12
t=3165,target_linear_speed=2000,ideal_linear_speed=2000,measured_linear_speed=2026.87,left_measured_linear_speed=2066.10,right_measured_linear_speed=1987.65,ideal_angular_speed=0.00,measured_angular_speed=-0.25,pwm_left=135,pwm_right=135,battery_voltage=12.12
t=3166,target_linear_speed=2000,ideal_linear_speed=2000,measured_linear_speed=2014.28,left_measured_linear_speed=2045.66,right_measured_linear_speed=1982.90,ideal_angular_speed=0.00,measured_angular_speed=-0.25,pwm_left=138,pwm_right=138,battery_voltage=12.13
t=3167,target_linear_speed=2000,ideal_linear_speed=2000,measured_linear_speed=2004.21,left_measured_linear_speed=2043.34,right_measured_linear_speed=1965.08,ideal_angular_speed=0.00,measured_angular_speed=0.62,pwm_left=140,pwm_right=140,battery_voltage=12.13
t=3168,target_linear_speed=2000,ideal_linear_speed=2000,measured_linear_speed=2024.21,left_measured_linear_speed=2041.49,right_measured_linear_speed=2006.93,ideal_angular_speed=0.00,measured_angular_speed=0.18,pwm_left=135,pwm_right=135,battery_voltage=12.13
t=3169,target_linear_speed=2000,ideal_linear_speed=2000,measured_linear_speed=2012.15,left_measured_linear_speed=2040.00,right_measured_linear_speed=1984.30,ideal_angular_speed=0.00,measured_angular_speed=-0.29,pwm_left=138,pwm_right=138,battery_voltage=12.13
t=3170,target_linear_speed=2000,ideal_linear_speed=2000,measured_linear_speed=2002.50,left_measured_linear_speed=2010.76,right_measured_linear_speed=1994.25,ideal_angular_speed=0.00,measured_angular_speed=0.14,pwm_left=140,pwm_right=140,battery_voltage=12.13
t=3171,target_linear_speed=2000,ideal_linear_speed=2000,measured_linear_speed=1987.77,left_measured_linear_speed=2001.39,right_measured_linear_speed=1974.16,ideal_angular_speed=0.00,measured_angular_speed=-0.19,pwm_left=144,pwm_right=144,battery_voltage=12.13
t=3172,target_linear_speed=2000,ideal_linear_speed=2000,measured_linear_speed=1975.99,left_measured_linear_speed=1965.84,right_measured_linear_speed=1986.14,ideal_angular_speed=0.00,measured_angular_speed=-0.28,pwm_left=148,pwm_right=148,battery_voltage=12.13
t=3173,target_linear_speed=2000,ideal_linear_speed=2000,measured_linear_speed=1980.59,left_measured_linear_speed=1979.48,right_measured_linear_speed=1981.69,ideal_angular_speed=0.00,measured_angular_speed=-0.30,pwm_left=147,pwm_right=147,battery_voltage=12.13
t=3174,target_linear_speed=2000,ideal_linear_speed=2000,measured_linear_speed=1998.30,left_measured_linear_speed=2004.43,right_measured_linear_speed=1992.17,ideal_angular_speed=0.00,measured_angular_speed=-0.30,pwm_left=142,pwm_right=142,battery_voltage=12.12
t=3175,target_linear_speed=2000,ideal_linear_speed=2000,measured_linear_speed=1998.44,left_measured_linear_speed=2010.35,right_measured_linear_speed=1986.52,ideal_angular_speed=0.00,measured_angular_speed=0.18,pwm_left=142,pwm_right=142,battery_voltage=12.12
t=3176,target_linear_speed=2000,ideal_linear_speed=2000,measured_linear_speed=1998.55,left_measured_linear_speed=2001.07,right_measured_linear_speed=1996.03,ideal_angular_speed=0.00,measured_angular_speed=0.22,pwm_left=142,pwm_right=142,battery_voltage=12.12
t=3177,target_linear_speed=2000,ideal_linear_speed=2000,measured_linear_speed=1991.62,left_measured_linear_speed=1979.61,right_measured_linear_speed=2003.63,ideal_angular_speed=0.00,measured_angular_speed=-0.53,pwm_left=144,pwm_right=144,battery_voltage=12.12
t=3178,target_linear_speed=2000,ideal_linear_speed=2000,measured_linear_speed=1993.10,left_measured_linear_speed=1990.50,right_measured_linear_speed=1995.69,ideal_angular_speed=0.00,measured_angular_speed=-0.32,pwm_left=144,pwm_right=144,battery_voltage=12.12
t=3179,target_linear_speed=2000,ideal_linear_speed=2000,measured_linear_speed=1980.25,left_measured_linear_speed=1985.18,right_measured_linear_speed=1975.31,ideal_angular_speed=0.00,measured_angular_speed=0.35,pwm_left=148,pwm_right=148,battery_voltage=12.12
t=3180,target_linear_speed=2000,ideal_linear_speed=2000,measured_linear_speed=1983.99,left_measured_linear_speed=1994.96,right_measured_linear_speed=1973.03,ideal_angular_speed=0.00,measured_angular_speed=-0.63,pwm_left=147,pwm_right=147,battery_voltage=12.12
t=3181,target_linear_speed=2000,ideal_linear_speed=2000,measured_linear_speed=1972.97,left_measured_linear_speed=1974.72,right_measured_linear_speed=1971.21,ideal_angular_speed=0.00,measured_angular_speed=-0.63,pwm_left=150,pwm_right=150,battery_voltage=12.12
t=3182,target_linear_speed=2000,ideal_linear_speed=2000,measured_linear_speed=1978.17,left_measured_linear_speed=1958.53,right_measured_linear_speed=1997.81,ideal_angular_speed=0.00,measured_angular_speed=-0.23,pwm_left=149,pwm_right=149,battery_voltage=12.12
t=3183,target_linear_speed=2000,ideal_linear_speed=2000,measured_linear_speed=1975.32,left_measured_linear_speed=1959.61,right_measured_linear_speed=1991.03,ideal_angular_speed=0.00,measured_angular_speed=0.01,pwm_left=150,pwm_right=150,battery_voltage=12.11
t=3184,target_linear_speed=2000,ideal_linear_speed=2000,measured_linear_speed=1973.04,left_measured_linear_speed=1960.47,right_measured_linear_speed=1985.61,ideal_angular_speed=0.00,measured_angular_speed=0.11,pwm_left=152,pwm_right=152,battery_voltage=12.11
t=3185,target_linear_speed=2000,ideal_linear_speed=2000,measured_linear_speed=1964.20,left_measured_linear_speed=1933.11,right_measured_linear_speed=1995.30,ideal_angular_speed=0.00,measured_angular_speed=-0.78,pwm_left=154,pwm_right=154,battery_voltage=12.11
t=3186,target_linear_speed=2000,ideal_linear_speed=2000,measured_linear_speed=1971.16,left_measured_linear_speed=1953.30,right_measured_linear_speed=1989.02,ideal_angular_speed=0.00,measured_angular_speed=-0.91,pwm_left=153,pwm_right=153,battery_voltage=12.11
t=3187,target_linear_speed=2000,ideal_linear_speed=2000,measured_linear_speed=1976.73,left_measured_linear_speed=1955.42,right_measured_linear_speed=1998.03,ideal_angular_speed=0.00,measured_angular_speed=-0.30,pwm_left=152,pwm_right=152,battery_voltage=12.11
t=3188,target_linear_speed=2000,ideal_linear_speed=2000,measured_linear_speed=1981.18,left_measured_linear_speed=1971.15,right_measured_linear_speed=1991.21,ideal_angular_speed=0.00,measured_angular_speed=0.13,pwm_left=151,pwm_right=151,battery_voltage=12.11
t=3189,target_linear_speed=2000,ideal_linear_speed=2000,measured_linear_speed=1970.71,left_measured_linear_speed=1955.68,right_measured_linear_speed=1985.75,ideal_angular_speed=0.00,measured_angular_speed=0.13,pwm_left=155,pwm_right=155,battery_voltage=12.11
t=3190,target_linear_speed=2000,ideal_linear_speed=2000,measured_linear_speed=1976.37,left_measured_linear_speed=1957.32,right_measured_linear_speed=1995.41,ideal_angular_speed=0.00,measured_angular_speed=0.25,pwm_left=153,pwm_right=153,battery_voltage=12.11
t=3191,target_linear_speed=2000,ideal_linear_speed=2000,measured_linear_speed=1980.89,left_measured_linear_speed=1958.64,right_measured_linear_speed=2003.14,ideal_angular_speed=0.00,measured_angular_speed=-0.43,pwm_left=153,pwm_right=153,battery_voltage=12.11
t=3192,target_linear_speed=2000,ideal_linear_speed=2000,measured_linear_speed=1991.53,left_measured_linear_speed=1987.75,right_measured_linear_speed=1995.30,ideal_angular_speed=0.00,measured_angular_speed=0.18,pwm_left=150,pwm_right=150,battery_voltage=12.11
t=3193,target_linear_speed=2000,ideal_linear_speed=2000,measured_linear_speed=1986.00,left_measured_linear_speed=1982.99,right_measured_linear_speed=1989.02,ideal_angular_speed=0.00,measured_angular_speed=0.24,pwm_left=377,pwm_right=-73,battery_voltage=12.11
t=3194,target_linear_speed=2000,ideal_linear_speed=2000,measured_linear_speed=1981.59,left_measured_linear_speed=2007.23,right_measured_linear_speed=1955.95,ideal_angular_speed=0.00,measured_angular_speed=0.22,pwm_left=58,pwm_right=249,battery_voltage=12.08
t=3195,target_linear_speed=2000,ideal_linear_speed=2000,measured_linear_speed=1985.07,left_measured_linear_speed=2054.68,right_measured_linear_speed=1915.46,ideal_angular_speed=0.00,measured_angular_speed=-0.48,pwm_left=49,pwm_right=257,battery_voltage=12.07
t=3196,target_linear_speed=2000,ideal_linear_speed=2000,measured_linear_speed=1994.87,left_measured_linear_speed=2078.61,right_measured_linear_speed=1911.12,ideal_angular_speed=0.00,measured_angular_speed=-0.48,pwm_left=151,pwm_right=151,battery_voltage=12.07
t=3197,target_linear_speed=2000,ideal_linear_speed=2000,measured_linear_speed=1995.69,left_measured_linear_speed=2055.67,right_measured_linear_speed=1935.71,ideal_angular_speed=0.00,measured_angular_speed=-2.36,pwm_left=150,pwm_right=150,battery_voltage=12.07
t=3198,target_linear_speed=2000,ideal_linear_speed=2000,measured_linear_speed=2003.37,left_measured_linear_speed=2051.35,right_measured_linear_speed=1955.38,ideal_angular_speed=0.00,measured_angular_speed=-1.01,pwm_left=148,pwm_right=148,battery_voltage=12.07
t=3199,target_linear_speed=2000,ideal_linear_speed=2000,measured_linear_speed=1995.48,left_measured_linear_speed=2033.86,right_measured_linear_speed=1957.09,ideal_angular_speed=0.00,measured_angular_speed=-0.15,pwm_left=150,pwm_right=150,battery_voltage=12.08
t=3200,target_linear_speed=2000,ideal_linear_speed=2000,measured_linear_speed=2003.19,left_measured_linear_speed=2019.88,right_measured_linear_speed=1986.51,ideal_angular_speed=0.00,measured_angular_speed=-0.13,pwm_left=148,pwm_right=148,battery_voltage=12.08
t=3201,target_linear_speed=2000,ideal_linear_speed=2000,measured_linear_speed=2002.35,left_measured_linear_speed=2022.71,right_measured_linear_speed=1981.99,ideal_angular_speed=0.00,measured_angular_speed=0.85,pwm_left=148,pwm_right=148,battery_voltage=12.08
t=3202,target_linear_speed=2000,ideal_linear_speed=2000,measured_linear_speed=2001.68,left_measured_linear_speed=2039.01,right_measured_linear_speed=1964.35,ideal_angular_speed=0.00,measured_angular_speed=0.05,pwm_left=149,pwm_right=149,battery_voltage=12.08
t=3203,target_linear_speed=2000,ideal_linear_speed=2000,measured_linear_speed=2015.17,left_measured_linear_speed=2052.05,right_measured_linear_speed=1978.29,ideal_angular_speed=0.00,measured_angular_speed=-0.22,pwm_left=145,pwm_right=145,battery_voltage=12.08
t=3204,target_linear_speed=2000,ideal_linear_speed=2000,measured_linear_speed=2011.93,left_measured_linear_speed=2034.42,right_measured_linear_speed=1989.45,ideal_angular_speed=0.00,measured_angular_speed=-0.22,pwm_left=145,pwm_right=145,battery_voltage=12.08
t=3205,target_linear_speed=2000,ideal_linear_speed=2000,measured_linear_speed=2009.35,left_measured_linear_speed=2020.32,right_measured_linear_speed=1998.37,ideal_angular_speed=0.00,measured_angular_speed=0.16,pwm_left=146,pwm_right=146,battery_voltage=12.09
t=3206,target_linear_speed=2000,ideal_linear_speed=2000,measured_linear_speed=1993.25,left_measured_linear_speed=1995.01,right_measured_linear_speed=1991.48,ideal_angular_speed=0.00,measured_angular_speed=-0.22,pwm_left=150,pwm_right=150,battery_voltage=12.09
t=3207,target_linear_speed=2000,ideal_linear_speed=2000,measured_linear_speed=1987.38,left_measured_linear_speed=1988.79,right_measured_linear_speed=1985.97,ideal_angular_speed=0.00,measured_angular_speed=0.25,pwm_left=152,pwm_right=152,battery_voltage=12.09
t=3208,target_linear_speed=2000,ideal_linear_speed=2000,measured_linear_speed=1996.72,left_measured_linear_speed=1997.85,right_measured_linear_speed=1995.59,ideal_angular_speed=0.00,measured_angular_speed=0.27,pwm_left=150,pwm_right=150,battery_voltage=12.09
t=3209,target_linear_speed=2000,ideal_linear_speed=2000,measured_linear_speed=2004.19,left_measured_linear_speed=2019.12,right_measured_linear_speed=1989.25,ideal_angular_speed=0.00,measured_angular_speed=-0.40,pwm_left=147,pwm_right=147,battery_voltage=12.09
t=3210,target_linear_speed=2000,ideal_linear_speed=2000,measured_linear_speed=2010.16,left_measured_linear_speed=2022.11,right_measured_linear_speed=1998.21,ideal_angular_speed=0.00,measured_angular_speed=0.47,pwm_left=371,pwm_right=-79,battery_voltage=12.09
t=3211,target_linear_speed=2000,ideal_linear_speed=2000,measured_linear_speed=2014.94,left_measured_linear_speed=2024.50,right_measured_linear_speed=2005.38,ideal_angular_speed=0.00,measured_angular_speed=0.47,pwm_left=49,pwm_right=240,battery_voltage=12.06
t=3212,target_linear_speed=2000,ideal_linear_speed=2000,measured_linear_speed=2011.75,left_measured_linear_speed=2040.44,right_measured_linear_speed=1983.06,ideal_angular_speed=0.00,measured_angular_speed=0.14,pwm_left=41,pwm_right=250,battery_voltage=12.05
t=3213,target_linear_speed=2000,ideal_linear_speed=2000,measured_linear_speed=2030.24,left_measured_linear_speed=2053.19,right_measured_linear_speed=2007.29,ideal_angular_speed=0.00,measured_angular_speed=-1.49,pwm_left=140,pwm_right=140,battery_voltage=12.05
t=3214,target_linear_speed=2000,ideal_linear_speed=2000,measured_linear_speed=2009.96,left_measured_linear_speed=2021.31,right_measured_linear_speed=1998.62,ideal_angular_speed=0.00,measured_angular_speed=-0.98,pwm_left=145,pwm_right=145,battery_voltage=12.05
t=3215,target_linear_speed=2000,ideal_linear_speed=2000,measured_linear_speed=1986.73,left_measured_linear_speed=1995.80,right_measured_linear_speed=1977.65,ideal_angular_speed=0.00,measured_angular_speed=-0.79,pwm_left=151,pwm_right=151,battery_voltage=12.06
t=3216,target_linear_speed=2000,ideal_linear_speed=2000,measured_linear_speed=1996.19,left_measured_linear_speed=2003.45,right_measured_linear_speed=1988.93,ideal_angular_speed=0.00,measured_angular_speed=0.18,pwm_left=149,pwm_right=149,battery_voltage=12.06
t=3217,target_linear_speed=2000,ideal_linear_speed=2000,measured_linear_speed=1982.72,left_measured_linear_speed=1981.52,right_measured_linear_speed=1983.93,ideal_angular_speed=0.00,measured_angular_speed=-0.01,pwm_left=153,pwm_right=153,battery_voltage=12.06
t=3218,target_linear_speed=2000,ideal_linear_speed=2000,measured_linear_speed=2007.02,left_measured_linear_speed=1992.03,right_measured_linear_speed=2022.01,ideal_angular_speed=0.00,measured_angular_speed=-0.01,pwm_left=146,pwm_right=146,battery_voltage=12.07
t=3219,target_linear_speed=2000,ideal_linear_speed=2000,measured_linear_speed=1991.39,left_measured_linear_speed=1972.38,right_measured_linear_speed=2010.39,ideal_angular_speed=0.00,measured_angular_speed=-0.04,pwm_left=150,pwm_right=150,battery_voltage=12.07
t=3220,target_linear_speed=2000,ideal_linear_speed=2000,measured_linear_speed=1985.89,left_measured_linear_speed=1956.66,right_measured_linear_speed=2015.13,ideal_angular_speed=0.00,measured_angular_speed=0.30,pwm_left=152,pwm_right=152,battery_voltage=12.07
t=3221,target_linear_speed=2000,ideal_linear_speed=2000,measured_linear_speed=1981.50,left_measured_linear_speed=1944.08,right_measured_linear_speed=2018.91,ideal_angular_speed=0.00,measured_angular_speed=0.37,pwm_left=153,pwm_right=153,battery_voltage=12.08
t=3222,target_linear_speed=2000,ideal_linear_speed=2000,measured_linear_speed=1985.00,left_measured_linear_speed=1948.05,right_measured_linear_speed=2021.94,ideal_angular_speed=0.00,measured_angular_speed=-0.21,pwm_left=153,pwm_right=153,battery_voltage=12.08
t=3223,target_linear_speed=2000,ideal_linear_speed=2000,measured_linear_speed=1994.81,left_measured_linear_speed=1965.25,right_measured_linear_speed=2024.37,ideal_angular_speed=0.00,measured_angular_speed=-0.10,pwm_left=150,pwm_right=150,battery_voltage=12.08
t=3224,target_linear_speed=2000,ideal_linear_speed=2000,measured_linear_speed=1995.65,left_measured_linear_speed=1979.01,right_measured_linear_speed=2012.28,ideal_angular_speed=0.00,measured_angular_speed=0.28,pwm_left=150,pwm_right=150,battery_voltage=12.09
t=3225,target_linear_speed=2000,ideal_linear_speed=2000,measured_linear_speed=1996.31,left_measured_linear_speed=1975.99,right_measured_linear_speed=2016.63,ideal_angular_speed=0.00,measured_angular_speed=-0.08,pwm_left=150,pwm_right=150,battery_voltage=12.09
t=3226,target_linear_speed=2000,ideal_linear_speed=2000,measured_linear_speed=1996.85,left_measured_linear_speed=1959.55,right_measured_linear_speed=2034.15,ideal_angular_speed=0.00,measured_angular_speed=-0.08,pwm_left=150,pwm_right=150,battery_voltage=12.09
t=3227,target_linear_speed=2000,ideal_linear_speed=2000,measured_linear_speed=1997.28,left_measured_linear_speed=1974.45,right_measured_linear_speed=2020.10,ideal_angular_speed=0.00,measured_angular_speed=-0.53,pwm_left=375,pwm_right=-75,battery_voltage=12.09
t=3228,target_linear_speed=2000,ideal_linear_speed=2000,measured_linear_speed=2004.63,left_measured_linear_speed=2000.40,right_measured_linear_speed=2008.87,ideal_angular_speed=0.00,measured_angular_speed=0.15,pwm_left=279,pwm_right=18,battery_voltage=12.02
t=3229,target_linear_speed=2000,ideal_linear_speed=2000,measured_linear_speed=1996.49,left_measured_linear_speed=2049.22,right_measured_linear_speed=1943.76,ideal_angular_speed=0.00,measured_angular_speed=-1.03,pwm_left=177,pwm_right=125,battery_voltage=12.02
t=3230,target_linear_speed=2000,ideal_linear_speed=2000,measured_linear_speed=2011.02,left_measured_linear_speed=2116.33,right_measured_linear_speed=1905.71,ideal_angular_speed=0.00,measured_angular_speed=-1.18,pwm_left=-166,pwm_right=461,battery_voltage=12.02
t=3231,target_linear_speed=2000,ideal_linear_speed=2000,measured_linear_speed=2022.64,left_measured_linear_speed=2141.96,right_measured_linear_speed=1903.33,ideal_angular_speed=0.00,measured_angular_speed=-2.73,pwm_left=30,pwm_right=259,battery_voltage=11.92
t=3232,target_linear_speed=2000,ideal_linear_speed=2000,measured_linear_speed=2017.91,left_measured_linear_speed=2092.32,right_measured_linear_speed=1943.50,ideal_angular_speed=0.00,measured_angular_speed=-2.63,pwm_left=137,pwm_right=154,battery_voltage=11.92
t=3233,target_linear_speed=2000,ideal_linear_speed=2000,measured_linear_speed=2049.20,left_measured_linear_speed=2052.61,right_measured_linear_speed=2045.78,ideal_angular_speed=0.00,measured_angular_speed=-2.63,pwm_left=128,pwm_right=145,battery_voltage=11.93
t=3234,target_linear_speed=2000,ideal_linear_speed=2000,measured_linear_speed=2039.16,left_measured_linear_speed=2020.85,right_measured_linear_speed=2057.46,ideal_angular_speed=0.00,measured_angular_speed=-1.38,pwm_left=129,pwm_right=147,battery_voltage=11.94
t=3235,target_linear_speed=2000,ideal_linear_speed=2000,measured_linear_speed=2038.14,left_measured_linear_speed=2009.46,right_measured_linear_speed=2066.81,ideal_angular_speed=0.00,measured_angular_speed=-0.94,pwm_left=129,pwm_right=146,battery_voltage=11.96
t=3236,target_linear_speed=2000,ideal_linear_speed=2000,measured_linear_speed=2023.29,left_measured_linear_speed=2014.38,right_measured_linear_speed=2032.21,ideal_angular_speed=0.00,measured_angular_speed=0.81,pwm_left=132,pwm_right=150,battery_voltage=11.97
t=3237,target_linear_speed=2000,ideal_linear_speed=2000,measured_linear_speed=2025.45,left_measured_linear_speed=2004.29,right_measured_linear_speed=2046.60,ideal_angular_speed=0.00,measured_angular_speed=0.81,pwm_left=131,pwm_right=148,battery_voltage=11.99
t=3238,target_linear_speed=2000,ideal_linear_speed=2000,measured_linear_speed=2006.13,left_measured_linear_speed=2010.24,right_measured_linear_speed=2002.01,ideal_angular_speed=0.00,measured_angular_speed=0.25,pwm_left=136,pwm_right=153,battery_voltage=12.00
t=3239,target_linear_speed=2000,ideal_linear_speed=2000,measured_linear_speed=2011.71,left_measured_linear_speed=2000.98,right_measured_linear_speed=2022.45,ideal_angular_speed=0.00,measured_angular_speed=0.19,pwm_left=134,pwm_right=151,battery_voltage=12.01
t=3240,target_linear_speed=2000,ideal_linear_speed=2000,measured_linear_speed=2023.20,left_measured_linear_speed=2007.59,right_measured_linear_speed=2038.80,ideal_angular_speed=0.00,measured_angular_speed=0.72,pwm_left=130,pwm_right=148,battery_voltage=12.02
t=3241,target_linear_speed=2000,ideal_linear_speed=2000,measured_linear_speed=2004.33,left_measured_linear_speed=1970.80,right_measured_linear_speed=2037.85,ideal_angular_speed=0.00,measured_angular_speed=0.72,pwm_left=135,pwm_right=153,battery_voltage=12.03
t=3242,target_linear_speed=2000,ideal_linear_speed=2000,measured_linear_speed=1996.25,left_measured_linear_speed=1955.40,right_measured_linear_speed=2037.09,ideal_angular_speed=0.00,measured_angular_speed=0.45,pwm_left=137,pwm_right=155,battery_voltage=12.04
t=3243,target_linear_speed=2000,ideal_linear_speed=2000,measured_linear_speed=1996.79,left_measured_linear_speed=1957.10,right_measured_linear_speed=2036.49,ideal_angular_speed=0.00,measured_angular_speed=0.59,pwm_left=137,pwm_right=155,battery_voltage=12.04
t=3244,target_linear_speed=2000,ideal_linear_speed=2000,measured_linear_speed=1997.23,left_measured_linear_speed=1958.47,right_measured_linear_speed=2036.00,ideal_angular_speed=0.00,measured_angular_speed=0.11,pwm_left=137,pwm_right=154,battery_voltage=12.05
t=3245,target_linear_speed=2000,ideal_linear_speed=2000,measured_linear_speed=1997.59,left_measured_linear_speed=1959.56,right_measured_linear_speed=2035.61,ideal_angular_speed=0.00,measured_angular_speed=1.01,pwm_left=137,pwm_right=154,battery_voltage=12.06
t=3246,target_linear_speed=2000,ideal_linear_speed=2000,measured_linear_speed=1997.87,left_measured_linear_speed=1960.43,right_measured_linear_speed=2035.30,ideal_angular_speed=0.00,measured_angular_speed=1.13,pwm_left=137,pwm_right=154,battery_voltage=12.06
t=3247,target_linear_speed=2000,ideal_linear_speed=2000,measured_linear_speed=1998.09,left_measured_linear_speed=1947.10,right_measured_linear_speed=2049.08,ideal_angular_speed=0.00,measured_angular_speed=0.64,pwm_left=137,pwm_right=154,battery_voltage=12.07
t=3248,target_linear_speed=2000,ideal_linear_speed=2000,measured_linear_speed=2019.31,left_measured_linear_speed=1964.49,right_measured_linear_speed=2074.13,ideal_angular_speed=0.00,measured_angular_speed=0.64,pwm_left=131,pwm_right=148,battery_voltage=12.07
t=3249,target_linear_speed=2000,ideal_linear_speed=2000,measured_linear_speed=2015.25,left_measured_linear_speed=1964.38,right_measured_linear_speed=2066.12,ideal_angular_speed=0.00,measured_angular_speed=0.95,pwm_left=132,pwm_right=149,battery_voltage=12.07
t=3250,target_linear_speed=2000,ideal_linear_speed=2000,measured_linear_speed=1997.97,left_measured_linear_speed=1950.26,right_measured_linear_speed=2045.68,ideal_angular_speed=0.00,measured_angular_speed=0.42,pwm_left=136,pwm_right=153,battery_voltage=12.08
t=3251,target_linear_speed=2000,ideal_linear_speed=2000,measured_linear_speed=1984.14,left_measured_linear_speed=1938.96,right_measured_linear_speed=2029.33,ideal_angular_speed=0.00,measured_angular_speed=0.75,pwm_left=140,pwm_right=157,battery_voltage=12.08
t=3252,target_linear_speed=2000,ideal_linear_speed=2000,measured_linear_speed=1987.11,left_measured_linear_speed=1929.93,right_measured_linear_speed=2044.30,ideal_angular_speed=0.00,measured_angular_speed=0.75,pwm_left=139,pwm_right=157,battery_voltage=12.08
t=3253,target_linear_speed=2000,ideal_linear_speed=2000,measured_linear_speed=1996.50,left_measured_linear_speed=1936.72,right_measured_linear_speed=2056.28,ideal_angular_speed=0.00,measured_angular_speed=1.18,pwm_left=137,pwm_right=154,battery_voltage=12.09
t=3254,target_linear_speed=2000,ideal_linear_speed=2000,measured_linear_speed=1997.00,left_measured_linear_speed=1928.14,right_measured_linear_speed=2065.87,ideal_angular_speed=0.00,measured_angular_speed=1.31,pwm_left=137,pwm_right=154,battery_voltage=12.09
t=3255,target_linear_speed=2000,ideal_linear_speed=2000,measured_linear_speed=1990.38,left_measured_linear_speed=1921.26,right_measured_linear_speed=2059.50,ideal_angular_speed=0.00,measured_angular_speed=0.42,pwm_left=139,pwm_right=156,battery_voltage=12.09
t=3256,target_linear_speed=2000,ideal_linear_speed=2000,measured_linear_speed=1978.08,left_measured_linear_speed=1887.71,right_measured_linear_speed=2068.44,ideal_angular_speed=0.00,measured_angular_speed=0.42,pwm_left=142,pwm_right=160,battery_voltage=12.09
t=3257,target_linear_speed=2000,ideal_linear_speed=2000,measured_linear_speed=1975.25,left_measured_linear_speed=1888.93,right_measured_linear_speed=2061.57,ideal_angular_speed=0.00,measured_angular_speed=0.50,pwm_left=143,pwm_right=161,battery_voltage=12.09
t=3258,target_linear_speed=2000,ideal_linear_speed=2000,measured_linear_speed=1972.98,left_measured_linear_speed=1889.90,right_measured_linear_speed=2056.07,ideal_angular_speed=0.00,measured_angular_speed=0.59,pwm_left=144,pwm_right=162,battery_voltage=12.09
t=3259,target_linear_speed=2000,ideal_linear_speed=2000,measured_linear_speed=1971.17,left_measured_linear_speed=1904.70,right_measured_linear_speed=2037.64,ideal_angular_speed=0.00,measured_angular_speed=0.26,pwm_left=145,pwm_right=163,battery_voltage=12.09
t=3260,target_linear_speed=2000,ideal_linear_speed=2000,measured_linear_speed=1976.73,left_measured_linear_speed=1902.52,right_measured_linear_speed=2050.95,ideal_angular_speed=0.00,measured_angular_speed=0.87,pwm_left=144,pwm_right=162,battery_voltage=12.09
t=3261,target_linear_speed=2000,ideal_linear_speed=2000,measured_linear_speed=1974.17,left_measured_linear_speed=1900.77,right_measured_linear_speed=2047.57,ideal_angular_speed=0.00,measured_angular_speed=0.34,pwm_left=145,pwm_right=163,battery_voltage=12.09
t=3262,target_linear_speed=2000,ideal_linear_speed=2000,measured_linear_speed=1972.12,left_measured_linear_speed=1899.37,right_measured_linear_speed=2044.87,ideal_angular_speed=0.00,measured_angular_speed=0.84,pwm_left=146,pwm_right=164,battery_voltage=12.09
t=3263,target_linear_speed=2000,ideal_linear_speed=2000,measured_linear_speed=1977.49,left_measured_linear_speed=1912.28,right_measured_linear_speed=2042.71,ideal_angular_speed=0.00,measured_angular_speed=0.84,pwm_left=145,pwm_right=163,battery_voltage=12.09
t=3264,target_linear_speed=2000,ideal_linear_speed=2000,measured_linear_speed=1974.78,left_measured_linear_speed=1908.58,right_measured_linear_speed=2040.98,ideal_angular_speed=0.00,measured_angular_speed=1.07,pwm_left=147,pwm_right=164,battery_voltage=12.09
t=3265,target_linear_speed=2000,ideal_linear_speed=2000,measured_linear_speed=1972.61,left_measured_linear_speed=1919.65,right_measured_linear_speed=2025.57,ideal_angular_speed=0.00,measured_angular_speed=1.25,pwm_left=373,pwm_right=-60,battery_voltage=12.09
t=3266,target_linear_speed=2000,ideal_linear_speed=2000,measured_linear_speed=1977.88,left_measured_linear_speed=1928.50,right_measured_linear_speed=2027.27,ideal_angular_speed=0.00,measured_angular_speed=0.69,pwm_left=51,pwm_right=260,battery_voltage=12.07
t=3267,target_linear_speed=2000,ideal_linear_speed=2000,measured_linear_speed=1982.11,left_measured_linear_speed=1977.67,right_measured_linear_speed=1986.54,ideal_angular_speed=0.00,measured_angular_speed=1.72,pwm_left=268,pwm_right=42,battery_voltage=12.06
t=3268,target_linear_speed=2000,ideal_linear_speed=2000,measured_linear_speed=1999.51,left_measured_linear_speed=2002.98,right_measured_linear_speed=1996.04,ideal_angular_speed=0.00,measured_angular_speed=-0.22,pwm_left=159,pwm_right=142,battery_voltage=12.06
t=3269,target_linear_speed=2000,ideal_linear_speed=2000,measured_linear_speed=2006.42,left_measured_linear_speed=2023.22,right_measured_linear_speed=1989.62,ideal_angular_speed=0.00,measured_angular_speed=-1.14,pwm_left=157,pwm_right=140,battery_voltage=12.06
t=3270,target_linear_speed=2000,ideal_linear_speed=2000,measured_linear_speed=2004.93,left_measured_linear_speed=2011.36,right_measured_linear_speed=1998.51,ideal_angular_speed=0.00,measured_angular_speed=-0.58,pwm_left=158,pwm_right=140,battery_voltage=12.06
t=3271,target_linear_speed=2000,ideal_linear_speed=2000,measured_linear_speed=2010.76,left_measured_linear_speed=2029.93,right_measured_linear_speed=1991.59,ideal_angular_speed=0.00,measured_angular_speed=-0.58,pwm_left=156,pwm_right=138,battery_voltage=12.06
t=3272,target_linear_speed=2000,ideal_linear_speed=2000,measured_linear_speed=2015.42,left_measured_linear_speed=2058.81,right_measured_linear_speed=1972.03,ideal_angular_speed=0.00,measured_angular_speed=-0.31,pwm_left=154,pwm_right=137,battery_voltage=12.07
t=3273,target_linear_speed=2000,ideal_linear_speed=2000,measured_linear_speed=2033.18,left_measured_linear_speed=2081.92,right_measured_linear_speed=1984.43,ideal_angular_speed=0.00,measured_angular_speed=-0.96,pwm_left=149,pwm_right=132,battery_voltage=12.07
t=3274,target_linear_speed=2000,ideal_linear_speed=2000,measured_linear_speed=2019.32,left_measured_linear_speed=2086.37,right_measured_linear_speed=1952.28,ideal_angular_speed=0.00,measured_angular_speed=-1.16,pwm_left=152,pwm_right=135,battery_voltage=12.07
t=3275,target_linear_speed=2000,ideal_linear_speed=2000,measured_linear_speed=2029.29,left_measured_linear_speed=2075.91,right_measured_linear_speed=1982.66,ideal_angular_speed=0.00,measured_angular_speed=-0.59,pwm_left=149,pwm_right=132,battery_voltage=12.08
t=3276,target_linear_speed=2000,ideal_linear_speed=2000,measured_linear_speed=2030.24,left_measured_linear_speed=2095.60,right_measured_linear_speed=1964.88,ideal_angular_speed=0.00,measured_angular_speed=-0.59,pwm_left=148,pwm_right=131,battery_voltage=12.08
t=3277,target_linear_speed=2000,ideal_linear_speed=2000,measured_linear_speed=2031.00,left_measured_linear_speed=2083.29,right_measured_linear_speed=1978.72,ideal_angular_speed=0.00,measured_angular_speed=-0.77,pwm_left=35,pwm_right=243,battery_voltage=12.09
t=3278,target_linear_speed=2000,ideal_linear_speed=2000,measured_linear_speed=2024.60,left_measured_linear_speed=2073.44,right_measured_linear_speed=1975.76,ideal_angular_speed=0.00,measured_angular_speed=-0.77,pwm_left=140,pwm_right=140,battery_voltage=12.09
t=3279,target_linear_speed=2000,ideal_linear_speed=2000,measured_linear_speed=2012.47,left_measured_linear_speed=2023.48,right_measured_linear_speed=2001.45,ideal_angular_speed=0.00,measured_angular_speed=-0.83,pwm_left=143,pwm_right=143,battery_voltage=12.09
t=3280,target_linear_speed=2000,ideal_linear_speed=2000,measured_linear_speed=1981.71,left_measured_linear_speed=1983.51,right_measured_linear_speed=1979.91,ideal_angular_speed=0.00,measured_angular_speed=-0.59,pwm_left=151,pwm_right=151,battery_voltage=12.09
t=3281,target_linear_speed=2000,ideal_linear_speed=2000,measured_linear_speed=2006.21,left_measured_linear_speed=2007.65,right_measured_linear_speed=2004.77,ideal_angular_speed=0.00,measured_angular_speed=-0.22,pwm_left=145,pwm_right=145,battery_voltage=12.09
t=3282,target_linear_speed=2000,ideal_linear_speed=2000,measured_linear_speed=2018.80,left_measured_linear_speed=2040.99,right_measured_linear_speed=1996.60,ideal_angular_speed=0.00,measured_angular_speed=0.05,pwm_left=141,pwm_right=141,battery_voltage=12.09
t=3283,target_linear_speed=2000,ideal_linear_speed=2000,measured_linear_speed=2014.83,left_measured_linear_speed=2025.58,right_measured_linear_speed=2004.09,ideal_angular_speed=0.00,measured_angular_speed=0.44,pwm_left=142,pwm_right=142,battery_voltage=12.09
t=3284,target_linear_speed=2000,ideal_linear_speed=2000,measured_linear_speed=2011.67,left_measured_linear_speed=2013.24,right_measured_linear_speed=2010.09,ideal_angular_speed=0.00,measured_angular_speed=-0.16,pwm_left=142,pwm_right=142,battery_voltage=12.09
t=3285,target_linear_speed=2000,ideal_linear_speed=2000,measured_linear_speed=2016.14,left_measured_linear_speed=2031.44,right_measured_linear_speed=2000.85,ideal_angular_speed=0.00,measured_angular_speed=-0.16,pwm_left=141,pwm_right=141,battery_voltage=12.09
t=3286,target_linear_speed=2000,ideal_linear_speed=2000,measured_linear_speed=2019.73,left_measured_linear_speed=2031.96,right_measured_linear_speed=2007.49,ideal_angular_speed=0.00,measured_angular_speed=-0.62,pwm_left=140,pwm_right=140,battery_voltage=12.09
t=3287,target_linear_speed=2000,ideal_linear_speed=2000,measured_linear_speed=2008.57,left_measured_linear_speed=2018.35,right_measured_linear_speed=1998.78,ideal_angular_speed=0.00,measured_angular_speed=-0.25,pwm_left=143,pwm_right=143,battery_voltage=12.10
t=3288,target_linear_speed=2000,ideal_linear_speed=2000,measured_linear_speed=2006.65,left_measured_linear_speed=2007.47,right_measured_linear_speed=2005.84,ideal_angular_speed=0.00,measured_angular_speed=-0.65,pwm_left=143,pwm_right=143,battery_voltage=12.10
t=3289,target_linear_speed=2000,ideal_linear_speed=2000,measured_linear_speed=1998.10,left_measured_linear_speed=1998.76,right_measured_linear_speed=1997.45,ideal_angular_speed=0.00,measured_angular_speed=-0.34,pwm_left=145,pwm_right=145,battery_voltage=12.10
t=3290,target_linear_speed=2000,ideal_linear_speed=2000,measured_linear_speed=1998.28,left_measured_linear_speed=1991.79,right_measured_linear_speed=2004.77,ideal_angular_speed=0.00,measured_angular_speed=0.17,pwm_left=145,pwm_right=145,battery_voltage=12.10
t=3291,target_linear_speed=2000,ideal_linear_speed=2000,measured_linear_speed=1991.41,left_measured_linear_speed=1972.19,right_measured_linear_speed=2010.63,ideal_angular_speed=0.00,measured_angular_speed=-0.22,pwm_left=147,pwm_right=147,battery_voltage=12.10
t=3292,target_linear_speed=2000,ideal_linear_speed=2000,measured_linear_speed=1985.91,left_measured_linear_speed=1970.53,right_measured_linear_speed=2001.29,ideal_angular_speed=0.00,measured_angular_speed=0.18,pwm_left=149,pwm_right=149,battery_voltage=12.10
t=3293,target_linear_speed=2000,ideal_linear_speed=2000,measured_linear_speed=1981.51,left_measured_linear_speed=1955.18,right_measured_linear_speed=2007.84,ideal_angular_speed=0.00,measured_angular_speed=0.18,pwm_left=150,pwm_right=150,battery_voltage=12.10
t=3294,target_linear_speed=2000,ideal_linear_speed=2000,measured_linear_speed=1992.02,left_measured_linear_speed=1970.96,right_measured_linear_speed=2013.09,ideal_angular_speed=0.00,measured_angular_speed=-0.20,pwm_left=148,pwm_right=148,battery_voltage=12.10
t=3295,target_linear_speed=2000,ideal_linear_speed=2000,measured_linear_speed=1993.42,left_measured_linear_speed=1969.55,right_measured_linear_speed=2017.28,ideal_angular_speed=0.00,measured_angular_speed=-0.27,pwm_left=147,pwm_right=147,battery_voltage=12.10
t=3296,target_linear_speed=2000,ideal_linear_speed=2000,measured_linear_speed=1987.52,left_measured_linear_speed=1968.42,right_measured_linear_speed=2006.61,ideal_angular_speed=0.00,measured_angular_speed=0.05,pwm_left=149,pwm_right=149,battery_voltage=12.10
t=3297,target_linear_speed=2000,ideal_linear_speed=2000,measured_linear_speed=1996.83,left_measured_linear_speed=1981.55,right_measured_linear_speed=2012.10,ideal_angular_speed=0.00,measured_angular_speed=-0.41,pwm_left=147,pwm_right=147,battery_voltage=12.10
t=3298,target_linear_speed=2000,ideal_linear_speed=2000,measured_linear_speed=1983.23,left_measured_linear_speed=1964.00,right_measured_linear_speed=2002.46,ideal_angular_speed=0.00,measured_angular_speed=-0.35,pwm_left=151,pwm_right=151,battery_voltage=12.10
t=3299,target_linear_speed=2000,ideal_linear_speed=2000,measured_linear_speed=1993.40,left_measured_linear_speed=1992.04,right_measured_linear_speed=1994.75,ideal_angular_speed=0.00,measured_angular_speed=-0.27,pwm_left=148,pwm_right=148,battery_voltage=12.10
t=3300,target_linear_speed=2000,ideal_linear_speed=2000,measured_linear_speed=1994.51,left_measured_linear_speed=1986.41,right_measured_linear_speed=2002.62,ideal_angular_speed=0.00,measured_angular_speed=-0.27,pwm_left=373,pwm_right=-77,battery_voltage=12.10
t=3301,target_linear_speed=2000,ideal_linear_speed=2000,measured_linear_speed=1988.40,left_measured_linear_speed=2009.97,right_measured_linear_speed=1966.82,ideal_angular_speed=0.00,measured_angular_speed=-0.49,pwm_left=280,pwm_right=20,battery_voltage=12.09
t=3302,target_linear_speed=2000,ideal_linear_speed=2000,measured_linear_speed=1997.53,left_measured_linear_speed=2070.90,right_measured_linear_speed=1924.16,ideal_angular_speed=0.00,measured_angular_speed=0.27,pwm_left=-51,pwm_right=348,battery_voltage=12.07
t=3303,target_linear_speed=2000,ideal_linear_speed=2000,measured_linear_speed=2004.84,left_measured_linear_speed=2147.70,right_measured_linear_speed=1861.97,ideal_angular_speed=0.00,measured_angular_speed=-1.02,pwm_left=42,pwm_right=252,battery_voltage=11.99
t=3304,target_linear_speed=2000,ideal_linear_speed=2000,measured_linear_speed=2017.69,left_measured_linear_speed=2139.00,right_measured_linear_speed=1896.39,ideal_angular_speed=0.00,measured_angular_speed=-0.91,pwm_left=143,pwm_right=143,battery_voltage=11.99
t=3305,target_linear_speed=2000,ideal_linear_speed=2000,measured_linear_speed=2027.98,left_measured_linear_speed=2103.98,right_measured_linear_speed=1951.98,ideal_angular_speed=0.00,measured_angular_speed=-1.41,pwm_left=140,pwm_right=140,battery_voltage=11.99
t=3306,target_linear_speed=2000,ideal_linear_speed=2000,measured_linear_speed=2015.17,left_measured_linear_speed=2061.94,right_measured_linear_speed=1968.39,ideal_angular_speed=0.00,measured_angular_speed=-0.00,pwm_left=143,pwm_right=143,battery_voltage=12.00
t=3307,target_linear_speed=2000,ideal_linear_speed=2000,measured_linear_speed=2018.95,left_measured_linear_speed=2070.40,right_measured_linear_speed=1967.50,ideal_angular_speed=0.00,measured_angular_speed=0.28,pwm_left=141,pwm_right=141,battery_voltage=12.01
t=3308,target_linear_speed=2000,ideal_linear_speed=2000,measured_linear_speed=2021.97,left_measured_linear_speed=2063.13,right_measured_linear_speed=1980.81,ideal_angular_speed=0.00,measured_angular_speed=0.28,pwm_left=140,pwm_right=140,battery_voltage=12.02
t=3309,target_linear_speed=2000,ideal_linear_speed=2000,measured_linear_speed=2017.37,left_measured_linear_speed=2057.31,right_measured_linear_speed=1977.43,ideal_angular_speed=0.00,measured_angular_speed=-0.06,pwm_left=141,pwm_right=141,battery_voltage=12.03
t=3310,target_linear_speed=2000,ideal_linear_speed=2000,measured_linear_speed=2013.70,left_measured_linear_speed=2066.69,right_measured_linear_speed=1960.70,ideal_angular_speed=0.00,measured_angular_speed=0.01,pwm_left=141,pwm_right=141,battery_voltage=12.03
t=3311,target_linear_speed=2000,ideal_linear_speed=2000,measured_linear_speed=2003.74,left_measured_linear_speed=2032.11,right_measured_linear_speed=1975.37,ideal_angular_speed=0.00,measured_angular_speed=-0.15,pwm_left=144,pwm_right=144,battery_voltage=12.04
t=3312,target_linear_speed=2000,ideal_linear_speed=2000,measured_linear_speed=2002.79,left_measured_linear_speed=2032.50,right_measured_linear_speed=1973.08,ideal_angular_speed=0.00,measured_angular_speed=-0.35,pwm_left=144,pwm_right=144,battery_voltage=12.05
t=3313,target_linear_speed=2000,ideal_linear_speed=2000,measured_linear_speed=1988.00,left_measured_linear_speed=2004.76,right_measured_linear_speed=1971.25,ideal_angular_speed=0.00,measured_angular_speed=-0.54,pwm_left=148,pwm_right=148,battery_voltage=12.05
t=3314,target_linear_speed=2000,ideal_linear_speed=2000,measured_linear_speed=1983.19,left_measured_linear_speed=1996.59,right_measured_linear_speed=1969.78,ideal_angular_speed=0.00,measured_angular_speed=-0.44,pwm_left=150,pwm_right=150,battery_voltage=12.06
t=3315,target_linear_speed=2000,ideal_linear_speed=2000,measured_linear_speed=1979.33,left_measured_linear_speed=1976.03,right_measured_linear_speed=1982.64,ideal_angular_speed=0.00,measured_angular_speed=-0.44,pwm_left=151,pwm_right=151,battery_voltage=12.06
t=3316,target_linear_speed=2000,ideal_linear_speed=2000,measured_linear_speed=1990.28,left_measured_linear_speed=2001.66,right_measured_linear_speed=1978.90,ideal_angular_speed=0.00,measured_angular_speed=0.25,pwm_left=148,pwm_right=148,battery_voltage=12.06
t=3317,target_linear_speed=2000,ideal_linear_speed=2000,measured_linear_speed=1999.03,left_measured_linear_speed=2008.14,right_measured_linear_speed=1989.93,ideal_angular_speed=0.00,measured_angular_speed=0.18,pwm_left=146,pwm_right=146,battery_voltage=12.07
t=3318,target_linear_speed=2000,ideal_linear_speed=2000,measured_linear_speed=1992.01,left_measured_linear_speed=1999.30,right_measured_linear_speed=1984.73,ideal_angular_speed=0.00,measured_angular_speed=0.28,pwm_left=148,pwm_right=148,battery_voltage=12.07
t=3319,target_linear_speed=2000,ideal_linear_speed=2000,measured_linear_speed=1986.39,left_measured_linear_speed=1992.22,right_measured_linear_speed=1980.57,ideal_angular_speed=0.00,measured_angular_speed=0.78,pwm_left=375,pwm_right=-76,battery_voltage=12.07
t=3320,target_linear_speed=2000,ideal_linear_speed=2000,measured_linear_speed=2002.94,left_measured_linear_speed=2000.59,right_measured_linear_speed=2005.29,ideal_angular_speed=0.00,measured_angular_speed=0.70,pwm_left=50,pwm_right=241,battery_voltage=12.05
t=3321,target_linear_speed=2000,ideal_linear_speed=2000,measured_linear_speed=2009.16,left_measured_linear_speed=2035.34,right_measured_linear_speed=1982.99,ideal_angular_speed=0.00,measured_angular_speed=0.12,pwm_left=39,pwm_right=248,battery_voltage=12.04
t=3322,target_linear_speed=2000,ideal_linear_speed=2000,measured_linear_speed=2014.14,left_measured_linear_speed=2049.11,right_measured_linear_speed=1979.18,ideal_angular_speed=0.00,measured_angular_speed=-0.22,pwm_left=142,pwm_right=142,battery_voltage=12.04
t=3323,target_linear_speed=2000,ideal_linear_speed=2000,measured_linear_speed=1983.06,left_measured_linear_speed=2004.02,right_measured_linear_speed=1962.10,ideal_angular_speed=0.00,measured_angular_speed=-0.22,pwm_left=150,pwm_right=150,battery_voltage=12.04
t=3324,target_linear_speed=2000,ideal_linear_speed=2000,measured_linear_speed=1986.24,left_measured_linear_speed=1981.97,right_measured_linear_speed=1990.52,ideal_angular_speed=0.00,measured_angular_speed=-0.39,pwm_left=150,pwm_right=150,battery_voltage=12.05
t=3325,target_linear_speed=2000,ideal_linear_speed=2000,measured_linear_speed=1995.81,left_measured_linear_speed=1992.39,right_measured_linear_speed=1999.23,ideal_angular_speed=0.00,measured_angular_speed=0.33,pwm_left=147,pwm_right=147,battery_voltage=12.05
t=3326,target_linear_speed=2000,ideal_linear_speed=2000,measured_linear_speed=1996.44,left_measured_linear_speed=2000.72,right_measured_linear_speed=1992.16,ideal_angular_speed=0.00,measured_angular_speed=0.07,pwm_left=147,pwm_right=147,battery_voltage=12.06
t=3327,target_linear_speed=2000,ideal_linear_speed=2000,measured_linear_speed=1968.90,left_measured_linear_speed=1951.28,right_measured_linear_speed=1986.52,ideal_angular_speed=0.00,measured_angular_speed=0.39,pwm_left=155,pwm_right=155,battery_voltage=12.06
t=3328,target_linear_speed=2000,ideal_linear_speed=2000,measured_linear_speed=1974.92,left_measured_linear_speed=1939.78,right_measured_linear_speed=2010.05,ideal_angular_speed=0.00,measured_angular_speed=0.04,pwm_left=154,pwm_right=154,battery_voltage=12.06
t=3329,target_linear_speed=2000,ideal_linear_speed=2000,measured_linear_speed=1972.72,left_measured_linear_speed=1944.61,right_measured_linear_speed=2000.83,ideal_angular_speed=0.00,measured_angular_speed=0.21,pwm_left=155,pwm_right=155,battery_voltage=12.06
t=3330,target_linear_speed=2000,ideal_linear_speed=2000,measured_linear_speed=1984.99,left_measured_linear_speed=1962.50,right_measured_linear_speed=2007.47,ideal_angular_speed=0.00,measured_angular_speed=0.21,pwm_left=152,pwm_right=152,battery_voltage=12.06
t=3331,target_linear_speed=2000,ideal_linear_speed=2000,measured_linear_speed=1994.80,left_measured_linear_speed=1976.81,right_measured_linear_speed=2012.79,ideal_angular_speed=0.00,measured_angular_speed=0.13,pwm_left=149,pwm_right=149,battery_voltage=12.07
t=3332,target_linear_speed=2000,ideal_linear_speed=2000,measured_linear_speed=1981.61,left_measured_linear_speed=1960.20,right_measured_linear_speed=2003.02,ideal_angular_speed=0.00,measured_angular_speed=-0.17,pwm_left=153,pwm_right=153,battery_voltage=12.07
t=3333,target_linear_speed=2000,ideal_linear_speed=2000,measured_linear_speed=1992.10,left_measured_linear_speed=1960.95,right_measured_linear_speed=2023.25,ideal_angular_speed=0.00,measured_angular_speed=0.21,pwm_left=150,pwm_right=150,battery_voltage=12.07
t=3334,target_linear_speed=2000,ideal_linear_speed=2000,measured_linear_speed=1986.46,left_measured_linear_speed=1975.57,right_measured_linear_speed=1997.36,ideal_angular_speed=0.00,measured_angular_speed=-0.47,pwm_left=152,pwm_right=152,battery_voltage=12.07
t=3335,target_linear_speed=2000,ideal_linear_speed=2000,measured_linear_speed=1988.97,left_measured_linear_speed=1973.24,right_measured_linear_speed=2004.70,ideal_angular_speed=0.00,measured_angular_speed=-0.75,pwm_left=152,pwm_right=152,battery_voltage=12.07
t=3336,target_linear_speed=2000,ideal_linear_speed=2000,measured_linear_speed=1990.97,left_measured_linear_speed=1985.40,right_measured_linear_speed=1996.54,ideal_angular_speed=0.00,measured_angular_speed=0.33,pwm_left=377,pwm_right=-74,battery_voltage=12.08
t=3337,target_linear_speed=2000,ideal_linear_speed=2000,measured_linear_speed=1978.55,left_measured_linear_speed=1981.11,right_measured_linear_speed=1975.99,ideal_angular_speed=0.00,measured_angular_speed=0.19,pwm_left=60,pwm_right=252,battery_voltage=12.01
t=3338,target_linear_speed=2000,ideal_linear_speed=2000,measured_linear_speed=1975.62,left_measured_linear_speed=2019.75,right_measured_linear_speed=1931.49,ideal_angular_speed=0.00,measured_angular_speed=0.19,pwm_left=52,pwm_right=262,battery_voltage=12.01
t=3339,target_linear_speed=2000,ideal_linear_speed=2000,measured_linear_speed=1980.30,left_measured_linear_speed=2036.64,right_measured_linear_speed=1923.95,ideal_angular_speed=0.00,measured_angular_speed=-0.81,pwm_left=156,pwm_right=156,battery_voltage=12.01
t=3340,target_linear_speed=2000,ideal_linear_speed=2000,measured_linear_speed=1984.04,left_measured_linear_speed=2022.10,right_measured_linear_speed=1945.97,ideal_angular_speed=0.00,measured_angular_speed=-1.47,pwm_left=155,pwm_right=155,battery_voltage=12.01
t=3341,target_linear_speed=2000,ideal_linear_speed=2000,measured_linear_speed=2008.07,left_measured_linear_speed=2038.52,right_measured_linear_speed=1977.62,ideal_angular_speed=0.00,measured_angular_speed=-0.70,pwm_left=149,pwm_right=149,battery_voltage=12.02
t=3342,target_linear_speed=2000,ideal_linear_speed=2000,measured_linear_speed=2006.25,left_measured_linear_speed=2023.60,right_measured_linear_speed=1988.91,ideal_angular_speed=0.00,measured_angular_speed=-0.32,pwm_left=149,pwm_right=149,battery_voltage=12.02
t=3343,target_linear_speed=2000,ideal_linear_speed=2000,measured_linear_speed=2004.80,left_measured_linear_speed=2025.69,right_measured_linear_speed=1983.91,ideal_angular_speed=0.00,measured_angular_speed=0.13,pwm_left=149,pwm_right=149,battery_voltage=12.03
t=3344,target_linear_speed=2000,ideal_linear_speed=2000,measured_linear_speed=2003.64,left_measured_linear_speed=2027.36,right_measured_linear_speed=1979.91,ideal_angular_speed=0.00,measured_angular_speed=0.62,pwm_left=149,pwm_right=149,battery_voltage=12.04
t=3345,target_linear_speed=2000,ideal_linear_speed=2000,measured_linear_speed=2002.71,left_measured_linear_speed=2028.70,right_measured_linear_speed=1976.71,ideal_angular_speed=0.00,measured_angular_speed=0.62,pwm_left=150,pwm_right=150,battery_voltage=12.04
t=3346,target_linear_speed=2000,ideal_linear_speed=2000,measured_linear_speed=2008.98,left_measured_linear_speed=2043.80,right_measured_linear_speed=1974.15,ideal_angular_speed=0.00,measured_angular_speed=0.33,pwm_left=148,pwm_right=148,battery_voltage=12.05
t=3347,target_linear_speed=2000,ideal_linear_speed=2000,measured_linear_speed=2028.02,left_measured_linear_speed=2055.88,right_measured_linear_speed=2000.16,ideal_angular_speed=0.00,measured_angular_speed=-0.31,pwm_left=142,pwm_right=142,battery_voltage=12.05
t=3348,target_linear_speed=2000,ideal_linear_speed=2000,measured_linear_speed=2022.22,left_measured_linear_speed=2037.49,right_measured_linear_speed=2006.94,ideal_angular_speed=0.00,measured_angular_speed=-0.49,pwm_left=143,pwm_right=143,battery_voltage=12.06
t=3349,target_linear_speed=2000,ideal_linear_speed=2000,measured_linear_speed=2010.56,left_measured_linear_speed=2008.75,right_measured_linear_speed=2012.37,ideal_angular_speed=0.00,measured_angular_speed=0.21,pwm_left=146,pwm_right=146,battery_voltage=12.06
t=3350,target_linear_speed=2000,ideal_linear_speed=2000,measured_linear_speed=1994.22,left_measured_linear_speed=1999.78,right_measured_linear_speed=1988.65,ideal_angular_speed=0.00,measured_angular_speed=-0.41,pwm_left=150,pwm_right=150,battery_voltage=12.06
t=3351,target_linear_speed=2000,ideal_linear_speed=2000,measured_linear_speed=2009.20,left_measured_linear_speed=2006.64,right_measured_linear_speed=2011.76,ideal_angular_speed=0.00,measured_angular_speed=-0.22,pwm_left=146,pwm_right=146,battery_voltage=12.07
t=3352,target_linear_speed=2000,ideal_linear_speed=2000,measured_linear_speed=2007.16,left_measured_linear_speed=2026.15,right_measured_linear_speed=1988.16,ideal_angular_speed=0.00,measured_angular_speed=-0.22,pwm_left=147,pwm_right=147,battery_voltage=12.07
t=3353,target_linear_speed=2000,ideal_linear_speed=2000,measured_linear_speed=2012.54,left_measured_linear_speed=2013.70,right_measured_linear_speed=2011.37,ideal_angular_speed=0.00,measured_angular_speed=0.24,pwm_left=145,pwm_right=145,battery_voltage=12.07
t=3354,target_linear_speed=2000,ideal_linear_speed=2000,measured_linear_speed=2016.84,left_measured_linear_speed=2017.78,right_measured_linear_speed=2015.91,ideal_angular_speed=0.00,measured_angular_speed=0.19,pwm_left=144,pwm_right=144,battery_voltage=12.07
t=3355,target_linear_speed=2000,ideal_linear_speed=2000,measured_linear_speed=2006.26,left_measured_linear_speed=2007.00,right_measured_linear_speed=2005.51,ideal_angular_speed=0.00,measured_angular_speed=0.14,pwm_left=146,pwm_right=146,battery_voltage=12.08
t=3356,target_linear_speed=2000,ideal_linear_speed=2000,measured_linear_speed=2018.83,left_measured_linear_speed=2012.42,right_measured_linear_speed=2025.25,ideal_angular_speed=0.00,measured_angular_speed=-0.17,pwm_left=143,pwm_right=143,battery_voltage=12.08
t=3357,target_linear_speed=2000,ideal_linear_speed=2000,measured_linear_speed=2007.85,left_measured_linear_speed=2002.72,right_measured_linear_speed=2012.98,ideal_angular_speed=0.00,measured_angular_speed=0.28,pwm_left=145,pwm_right=145,battery_voltage=12.08
t=3358,target_linear_speed=2000,ideal_linear_speed=2000,measured_linear_speed=2006.08,left_measured_linear_speed=1994.96,right_measured_linear_speed=2017.20,ideal_angular_speed=0.00,measured_angular_speed=-0.25,pwm_left=146,pwm_right=146,battery_voltage=12.09
t=3359,target_linear_speed=2000,ideal_linear_speed=2000,measured_linear_speed=2004.66,left_measured_linear_speed=2002.78,right_measured_linear_speed=2006.54,ideal_angular_speed=0.00,measured_angular_speed=-0.58,pwm_left=146,pwm_right=146,battery_voltage=12.09
t=3360,target_linear_speed=2000,ideal_linear_speed=2000,measured_linear_speed=2003.53,left_measured_linear_speed=1995.01,right_measured_linear_speed=2012.05,ideal_angular_speed=0.00,measured_angular_speed=-0.58,pwm_left=146,pwm_right=146,battery_voltage=12.09
t=3361,target_linear_speed=2000,ideal_linear_speed=2000,measured_linear_speed=2016.65,left_measured_linear_speed=2002.82,right_measured_linear_speed=2030.48,ideal_angular_speed=0.00,measured_angular_speed=0.26,pwm_left=142,pwm_right=142,battery_voltage=12.09
t=3362,target_linear_speed=2000,ideal_linear_speed=2000,measured_linear_speed=1999.09,left_measured_linear_speed=1981.01,right_measured_linear_speed=2017.17,ideal_angular_speed=0.00,measured_angular_speed=0.53,pwm_left=147,pwm_right=147,battery_voltage=12.09
t=3363,target_linear_speed=2000,ideal_linear_speed=2000,measured_linear_speed=1985.04,left_measured_linear_speed=1963.56,right_measured_linear_speed=2006.52,ideal_angular_speed=0.00,measured_angular_speed=-0.05,pwm_left=151,pwm_right=151,battery_voltage=12.09
t=3364,target_linear_speed=2000,ideal_linear_speed=2000,measured_linear_speed=1987.83,left_measured_linear_speed=1949.61,right_measured_linear_speed=2026.05,ideal_angular_speed=0.00,measured_angular_speed=-0.19,pwm_left=150,pwm_right=150,battery_voltage=12.09
t=3365,target_linear_speed=2000,ideal_linear_speed=2000,measured_linear_speed=1990.06,left_measured_linear_speed=1952.47,right_measured_linear_speed=2027.65,ideal_angular_speed=0.00,measured_angular_speed=0.07,pwm_left=150,pwm_right=150,battery_voltage=12.09
t=3366,target_linear_speed=2000,ideal_linear_speed=2000,measured_linear_speed=1984.83,left_measured_linear_speed=1954.76,right_measured_linear_speed=2014.91,ideal_angular_speed=0.00,measured_angular_speed=-0.07,pwm_left=152,pwm_right=152,battery_voltage=12.09
t=3367,target_linear_speed=2000,ideal_linear_speed=2000,measured_linear_speed=1987.66,left_measured_linear_speed=1970.62,right_measured_linear_speed=2004.71,ideal_angular_speed=0.00,measured_angular_speed=-0.07,pwm_left=151,pwm_right=151,battery_voltage=12.09
t=3368,target_linear_speed=2000,ideal_linear_speed=2000,measured_linear_speed=1989.93,left_measured_linear_speed=1969.28,right_measured_linear_speed=2010.58,ideal_angular_speed=0.00,measured_angular_speed=-0.04,pwm_left=151,pwm_right=151,battery_voltage=12.09
t=3369,target_linear_speed=2000,ideal_linear_speed=2000,measured_linear_speed=1984.73,left_measured_linear_speed=1954.18,right_measured_linear_speed=2015.28,ideal_angular_speed=0.00,measured_angular_speed=-0.11,pwm_left=152,pwm_right=152,battery_voltage=12.09
t=3370,target_linear_speed=2000,ideal_linear_speed=2000,measured_linear_speed=1987.58,left_measured_linear_speed=1970.16,right_measured_linear_speed=2005.00,ideal_angular_speed=0.00,measured_angular_speed=-0.00,pwm_left=152,pwm_right=152,battery_voltage=12.08
t=3371,target_linear_speed=2000,ideal_linear_speed=2000,measured_linear_speed=1989.86,left_measured_linear_speed=1982.94,right_measured_linear_speed=1996.79,ideal_angular_speed=0.00,measured_angular_speed=-0.41,pwm_left=151,pwm_right=151,battery_voltage=12.09
t=3372,target_linear_speed=2000,ideal_linear_speed=2000,measured_linear_speed=1991.69,left_measured_linear_speed=1979.13,right_measured_linear_speed=2004.24,ideal_angular_speed=0.00,measured_angular_speed=0.03,pwm_left=377,pwm_right=-74,battery_voltage=12.08
t=3373,target_linear_speed=2000,ideal_linear_speed=2000,measured_linear_speed=1993.15,left_measured_linear_speed=1990.12,right_measured_linear_speed=1996.18,ideal_angular_speed=0.00,measured_angular_speed=0.14,pwm_left=169,pwm_right=134,battery_voltage=12.03
t=3374,target_linear_speed=2000,ideal_linear_speed=2000,measured_linear_speed=1994.32,left_measured_linear_speed=2040.99,right_measured_linear_speed=1947.64,ideal_angular_speed=0.00,measured_angular_speed=-0.52,pwm_left=55,pwm_right=247,battery_voltage=12.03
t=3375,target_linear_speed=2000,ideal_linear_speed=2000,measured_linear_speed=2002.27,left_measured_linear_speed=2081.69,right_measured_linear_speed=1922.84,ideal_angular_speed=0.00,measured_angular_speed=-0.52,pwm_left=44,pwm_right=254,battery_voltage=12.03
t=3376,target_linear_speed=2000,ideal_linear_speed=2000,measured_linear_speed=2001.61,left_measured_linear_speed=2072.16,right_measured_linear_speed=1931.06,ideal_angular_speed=0.00,measured_angular_speed=-1.42,pwm_left=36,pwm_right=263,battery_voltage=12.03
t=3377,target_linear_speed=2000,ideal_linear_speed=2000,measured_linear_speed=2015.11,left_measured_linear_speed=2064.54,right_measured_linear_speed=1965.69,ideal_angular_speed=0.00,measured_angular_speed=-0.84,pwm_left=137,pwm_right=154,battery_voltage=12.03
t=3378,target_linear_speed=2000,ideal_linear_speed=2000,measured_linear_speed=2025.92,left_measured_linear_speed=2030.39,right_measured_linear_speed=2021.44,ideal_angular_speed=0.00,measured_angular_speed=-0.37,pwm_left=133,pwm_right=151,battery_voltage=12.04
t=3379,target_linear_speed=2000,ideal_linear_speed=2000,measured_linear_speed=2013.52,left_measured_linear_speed=2017.10,right_measured_linear_speed=2009.94,ideal_angular_speed=0.00,measured_angular_speed=0.82,pwm_left=136,pwm_right=154,battery_voltage=12.04
t=3380,target_linear_speed=2000,ideal_linear_speed=2000,measured_linear_speed=2024.64,left_measured_linear_speed=2020.49,right_measured_linear_speed=2028.79,ideal_angular_speed=0.00,measured_angular_speed=1.42,pwm_left=133,pwm_right=150,battery_voltage=12.04
t=3381,target_linear_speed=2000,ideal_linear_speed=2000,measured_linear_speed=2012.50,left_measured_linear_speed=2009.18,right_measured_linear_speed=2015.82,ideal_angular_speed=0.00,measured_angular_speed=1.19,pwm_left=136,pwm_right=153,battery_voltage=12.05
t=3382,target_linear_speed=2000,ideal_linear_speed=2000,measured_linear_speed=2030.84,left_measured_linear_speed=2014.15,right_measured_linear_speed=2047.52,ideal_angular_speed=0.00,measured_angular_speed=1.19,pwm_left=130,pwm_right=148,battery_voltage=12.06
t=3383,target_linear_speed=2000,ideal_linear_speed=2000,measured_linear_speed=2017.45,left_measured_linear_speed=2004.11,right_measured_linear_speed=2030.80,ideal_angular_speed=0.00,measured_angular_speed=0.50,pwm_left=134,pwm_right=151,battery_voltage=12.06
t=3384,target_linear_speed=2000,ideal_linear_speed=2000,measured_linear_speed=2013.76,left_measured_linear_speed=1996.07,right_measured_linear_speed=2031.45,ideal_angular_speed=0.00,measured_angular_speed=0.30,pwm_left=134,pwm_right=152,battery_voltage=12.06
t=3385,target_linear_speed=2000,ideal_linear_speed=2000,measured_linear_speed=2010.81,left_measured_linear_speed=1961.58,right_measured_linear_speed=2060.03,ideal_angular_speed=0.00,measured_angular_speed=0.68,pwm_left=135,pwm_right=152,battery_voltage=12.07
t=3386,target_linear_speed=2000,ideal_linear_speed=2000,measured_linear_speed=2001.43,left_measured_linear_speed=1962.05,right_measured_linear_speed=2040.81,ideal_angular_speed=0.00,measured_angular_speed=0.58,pwm_left=137,pwm_right=155,battery_voltage=12.07
t=3387,target_linear_speed=2000,ideal_linear_speed=2000,measured_linear_speed=2000.94,left_measured_linear_speed=1948.40,right_measured_linear_speed=2053.49,ideal_angular_speed=0.00,measured_angular_speed=0.58,pwm_left=137,pwm_right=155,battery_voltage=12.08
t=3388,target_linear_speed=2000,ideal_linear_speed=2000,measured_linear_speed=2007.57,left_measured_linear_speed=1965.53,right_measured_linear_speed=2049.60,ideal_angular_speed=0.00,measured_angular_speed=0.28,pwm_left=135,pwm_right=153,battery_voltage=12.08
t=3389,target_linear_speed=2000,ideal_linear_speed=2000,measured_linear_speed=1998.84,left_measured_linear_speed=1951.18,right_measured_linear_speed=2046.49,ideal_angular_speed=0.00,measured_angular_speed=1.33,pwm_left=138,pwm_right=155,battery_voltage=12.08
t=3390,target_linear_speed=2000,ideal_linear_speed=2000,measured_linear_speed=2012.90,left_measured_linear_speed=1967.76,right_measured_linear_speed=2058.03,ideal_angular_speed=0.00,measured_angular_speed=1.33,pwm_left=134,pwm_right=151,battery_voltage=12.08
t=3391,target_linear_speed=2000,ideal_linear_speed=2000,measured_linear_speed=2024.14,left_measured_linear_speed=1966.99,right_measured_linear_speed=2081.30,ideal_angular_speed=0.00,measured_angular_speed=1.15,pwm_left=130,pwm_right=148,battery_voltage=12.08
t=3392,target_linear_speed=2000,ideal_linear_speed=2000,measured_linear_speed=2012.10,left_measured_linear_speed=1966.37,right_measured_linear_speed=2057.82,ideal_angular_speed=0.00,measured_angular_speed=0.86,pwm_left=133,pwm_right=151,battery_voltage=12.08
t=3393,target_linear_speed=2000,ideal_linear_speed=2000,measured_linear_speed=2002.46,left_measured_linear_speed=1951.86,right_measured_linear_speed=2053.07,ideal_angular_speed=0.00,measured_angular_speed=0.91,pwm_left=136,pwm_right=153,battery_voltage=12.08
t=3394,target_linear_speed=2000,ideal_linear_speed=2000,measured_linear_speed=1987.74,left_measured_linear_speed=1926.21,right_measured_linear_speed=2049.27,ideal_angular_speed=0.00,measured_angular_speed=0.90,pwm_left=140,pwm_right=157,battery_voltage=12.09
t=3395,target_linear_speed=2000,ideal_linear_speed=2000,measured_linear_speed=2004.02,left_measured_linear_speed=1947.78,right_measured_linear_speed=2060.25,ideal_angular_speed=0.00,measured_angular_speed=0.62,pwm_left=135,pwm_right=153,battery_voltage=12.09
t=3396,target_linear_speed=2000,ideal_linear_speed=2000,measured_linear_speed=1996.00,left_measured_linear_speed=1936.98,right_measured_linear_speed=2055.02,ideal_angular_speed=0.00,measured_angular_speed=0.78,pwm_left=138,pwm_right=155,battery_voltage=12.09
t=3397,target_linear_speed=2000,ideal_linear_speed=2000,measured_linear_speed=1996.60,left_measured_linear_speed=1942.37,right_measured_linear_speed=2050.82,ideal_angular_speed=0.00,measured_angular_speed=0.78,pwm_left=138,pwm_right=155,battery_voltage=12.09
t=3398,target_linear_speed=2000,ideal_linear_speed=2000,measured_linear_speed=1990.06,left_measured_linear_speed=1918.62,right_measured_linear_speed=2061.50,ideal_angular_speed=0.00,measured_angular_speed=0.71,pwm_left=252,pwm_right=44,battery_voltage=12.09
t=3399,target_linear_speed=2000,ideal_linear_speed=2000,measured_linear_speed=1984.83,left_measured_linear_speed=1913.65,right_measured_linear_speed=2056.01,ideal_angular_speed=0.00,measured_angular_speed=0.89,pwm_left=262,pwm_right=37,battery_voltage=12.09
t=3400,target_linear_speed=2000,ideal_linear_speed=2000,measured_linear_speed=1987.66,left_measured_linear_speed=1923.71,right_measured_linear_speed=2051.62,ideal_angular_speed=0.00,measured_angular_speed=1.02,pwm_left=158,pwm_right=140,battery_voltage=12.09
t=3401,target_linear_speed=2000,ideal_linear_speed=2000,measured_linear_speed=1989.93,left_measured_linear_speed=1945.78,right_measured_linear_speed=2034.08,ideal_angular_speed=0.00,measured_angular_speed=0.29,pwm_left=157,pwm_right=140,battery_voltage=12.08
t=3402,target_linear_speed=2000,ideal_linear_speed=2000,measured_linear_speed=1991.74,left_measured_linear_speed=1963.43,right_measured_linear_speed=2020.05,ideal_angular_speed=0.00,measured_angular_speed=-0.42,pwm_left=157,pwm_right=140,battery_voltage=12.08
t=3403,target_linear_speed=2000,ideal_linear_speed=2000,measured_linear_speed=1979.16,left_measured_linear_speed=1963.53,right_measured_linear_speed=1994.80,ideal_angular_speed=0.00,measured_angular_speed=-0.42,pwm_left=161,pwm_right=143,battery_voltage=12.08
t=3404,target_linear_speed=2000,ideal_linear_speed=2000,measured_linear_speed=1990.14,left_measured_linear_speed=1977.64,right_measured_linear_speed=2002.65,ideal_angular_speed=0.00,measured_angular_speed=-0.95,pwm_left=158,pwm_right=141,battery_voltage=12.08
t=3405,target_linear_speed=2000,ideal_linear_speed=2000,measured_linear_speed=1977.88,left_measured_linear_speed=1974.89,right_measured_linear_speed=1980.87,ideal_angular_speed=0.00,measured_angular_speed=-0.95,pwm_left=162,pwm_right=144,battery_voltage=12.08
t=3406,target_linear_speed=2000,ideal_linear_speed=2000,measured_linear_speed=1996.13,left_measured_linear_speed=2000.76,right_measured_linear_speed=1991.51,ideal_angular_speed=0.00,measured_angular_speed=-0.77,pwm_left=157,pwm_right=140,battery_voltage=12.08
t=3407,target_linear_speed=2000,ideal_linear_speed=2000,measured_linear_speed=1989.69,left_measured_linear_speed=2007.42,right_measured_linear_speed=1971.97,ideal_angular_speed=0.00,measured_angular_speed=-0.62,pwm_left=272,pwm_right=29,battery_voltage=12.08
t=3408,target_linear_speed=2000,ideal_linear_speed=2000,measured_linear_speed=1977.52,left_measured_linear_speed=1998.72,right_measured_linear_speed=1956.33,ideal_angular_speed=0.00,measured_angular_speed=-1.31,pwm_left=284,pwm_right=24,battery_voltage=12.08
t=3409,target_linear_speed=2000,ideal_linear_speed=2000,measured_linear_speed=1981.82,left_measured_linear_speed=2033.84,right_measured_linear_speed=1929.79,ideal_angular_speed=0.00,measured_angular_speed=-0.98,pwm_left=179,pwm_right=127,battery_voltage=12.08
t=3410,target_linear_speed=2000,ideal_linear_speed=2000,measured_linear_speed=1999.28,left_measured_linear_speed=2104.03,right_measured_linear_speed=1894.53,ideal_angular_speed=0.00,measured_angular_speed=-1.54,pwm_left=-50,pwm_right=348,battery_voltage=12.07
t=3411,target_linear_speed=2000,ideal_linear_speed=2000,measured_linear_speed=1999.22,left_measured_linear_speed=2118.09,right_measured_linear_speed=1880.35,ideal_angular_speed=0.00,measured_angular_speed=-1.55,pwm_left=45,pwm_right=254,battery_voltage=12.00
t=3412,target_linear_speed=2000,ideal_linear_speed=2000,measured_linear_speed=1999.17,left_measured_linear_speed=2101.28,right_measured_linear_speed=1897.07,ideal_angular_speed=0.00,measured_angular_speed=-1.55,pwm_left=150,pwm_right=150,battery_voltage=12.00
t=3413,target_linear_speed=2000,ideal_linear_speed=2000,measured_linear_speed=2034.21,left_measured_linear_speed=2087.84,right_measured_linear_speed=1980.58,ideal_angular_speed=0.00,measured_angular_speed=-1.14,pwm_left=140,pwm_right=140,battery_voltage=12.00
t=2701,target_linear_speed=2000,ideal_linear_speed=5,measured_linear_speed=-7.01,left_measured_linear_speed=-14.03,right_measured_linear_speed=0.00,ideal_angular_speed=0.00,measured_angular_speed=-0.07,pwm_left=5,pwm_right=5,battery_voltage=12.23
t=2702,target_linear_speed=2000,ideal_linear_speed=10,measured_linear_speed=-5.61,left_measured_linear_speed=-11.22,right_measured_linear_speed=0.00,ideal_angular_speed=0.00,measured_angular_speed=-0.08,pwm_left=6,pwm_right=6,battery_voltage=12.23
t=2703,target_linear_speed=2000,ideal_linear_speed=15,measured_linear_speed=-4.49,left_measured_linear_speed=-8.98,right_measured_linear_speed=0.00,ideal_angular_speed=0.00,measured_angular_speed=-0.19,pwm_left=7,pwm_right=7,battery_voltage=12.23
t=2704,target_linear_speed=2000,ideal_linear_speed=20,measured_linear_speed=-3.59,left_measured_linear_speed=-7.18,right_measured_linear_speed=0.00,ideal_angular_speed=0.00,measured_angular_speed=0.16,pwm_left=9,pwm_right=9,battery_voltage=12.23
t=2705,target_linear_speed=2000,ideal_linear_speed=25,measured_linear_speed=-2.87,left_measured_linear_speed=-5.75,right_measured_linear_speed=0.00,ideal_angular_speed=0.00,measured_angular_speed=0.16,pwm_left=10,pwm_right=10,battery_voltage=12.23
t=2706,target_linear_speed=2000,ideal_linear_speed=30,measured_linear_speed=-2.30,left_measured_linear_speed=-4.60,right_measured_linear_speed=0.00,ideal_angular_speed=0.00,measured_angular_speed=-0.06,pwm_left=12,pwm_right=12,battery_voltage=12.23
t=2707,target_linear_speed=2000,ideal_linear_speed=35,measured_linear_speed=-1.84,left_measured_linear_speed=-3.68,right_measured_linear_speed=0.00,ideal_angular_speed=0.00,measured_angular_speed=0.10,pwm_left=14,pwm_right=14,battery_voltage=12.23
t=2708,target_linear_speed=2000,ideal_linear_speed=40,measured_linear_speed=-1.47,left_measured_linear_speed=-2.94,right_measured_linear_speed=0.00,ideal_angular_speed=0.00,measured_angular_speed=-0.08,pwm_left=16,pwm_right=16,battery_voltage=12.23
t=2709,target_linear_speed=2000,ideal_linear_speed=45,measured_linear_speed=-1.18,left_measured_linear_speed=-2.35,right_measured_linear_speed=0.00,ideal_angular_speed=0.00,measured_angular_speed=0.12,pwm_left=18,pwm_right=18,battery_voltage=12.23
t=2710,target_linear_speed=2000,ideal_linear_speed=50,measured_linear_speed=-0.94,left_measured_linear_speed=-1.88,right_measured_linear_speed=0.00,ideal_angular_speed=0.00,measured_angular_speed=-0.11,pwm_left=20,pwm_right=20,battery_voltage=12.23
t=2711,target_linear_speed=2000,ideal_linear_speed=55,measured_linear_speed=6.26,left_measured_linear_speed=-1.51,right_measured_linear_speed=14.03,ideal_angular_speed=0.00,measured_angular_speed=0.16,pwm_left=20,pwm_right=20,battery_voltage=12.22
t=2712,target_linear_speed=2000,ideal_linear_speed=60,measured_linear_speed=12.02,left_measured_linear_speed=12.82,right_measured_linear_speed=11.22,ideal_angular_speed=0.00,measured_angular_speed=0.22,pwm_left=21,pwm_right=21,battery_voltage=12.22
t=2713,target_linear_speed=2000,ideal_linear_speed=65,measured_linear_speed=9.62,left_measured_linear_speed=10.26,right_measured_linear_speed=8.98,ideal_angular_speed=0.00,measured_angular_speed=0.22,pwm_left=23,pwm_right=23,battery_voltage=12.22
t=2714,target_linear_speed=2000,ideal_linear_speed=70,measured_linear_speed=7.69,left_measured_linear_speed=8.21,right_measured_linear_speed=7.18,ideal_angular_speed=0.00,measured_angular_speed=-0.05,pwm_left=26,pwm_right=26,battery_voltage=12.22
t=2715,target_linear_speed=2000,ideal_linear_speed=75,measured_linear_speed=13.17,left_measured_linear_speed=6.57,right_measured_linear_speed=19.77,ideal_angular_speed=0.00,measured_angular_speed=0.03,pwm_left=27,pwm_right=27,battery_voltage=12.22
t=2716,target_linear_speed=2000,ideal_linear_speed=80,measured_linear_speed=10.54,left_measured_linear_speed=5.25,right_measured_linear_speed=15.82,ideal_angular_speed=0.00,measured_angular_speed=0.01,pwm_left=30,pwm_right=30,battery_voltage=12.22
t=2717,target_linear_speed=2000,ideal_linear_speed=85,measured_linear_speed=22.46,left_measured_linear_speed=18.23,right_measured_linear_speed=26.68,ideal_angular_speed=0.00,measured_angular_speed=0.10,pwm_left=30,pwm_right=30,battery_voltage=12.22
t=2718,target_linear_speed=2000,ideal_linear_speed=90,measured_linear_speed=17.97,left_measured_linear_speed=14.58,right_measured_linear_speed=21.35,ideal_angular_speed=0.00,measured_angular_speed=-0.13,pwm_left=33,pwm_right=33,battery_voltage=12.22
t=2719,target_linear_speed=2000,ideal_linear_speed=95,measured_linear_speed=14.37,left_measured_linear_speed=11.67,right_measured_linear_speed=17.08,ideal_angular_speed=0.00,measured_angular_speed=0.10,pwm_left=37,pwm_right=37,battery_voltage=12.22
t=2720,target_linear_speed=2000,ideal_linear_speed=100,measured_linear_speed=25.53,left_measured_linear_speed=23.36,right_measured_linear_speed=27.69,ideal_angular_speed=0.00,measured_angular_speed=0.10,pwm_left=37,pwm_right=37,battery_voltage=12.22
t=2721,target_linear_speed=2000,ideal_linear_speed=105,measured_linear_speed=27.43,left_measured_linear_speed=32.72,right_measured_linear_speed=22.15,ideal_angular_speed=0.00,measured_angular_speed=-0.12,pwm_left=39,pwm_right=39,battery_voltage=12.22
t=2722,target_linear_speed=2000,ideal_linear_speed=110,measured_linear_speed=28.96,left_measured_linear_speed=26.17,right_measured_linear_speed=31.75,ideal_angular_speed=0.00,measured_angular_speed=0.01,pwm_left=41,pwm_right=41,battery_voltage=12.21
t=2723,target_linear_speed=2000,ideal_linear_speed=115,measured_linear_speed=30.18,left_measured_linear_speed=34.97,right_measured_linear_speed=25.40,ideal_angular_speed=0.00,measured_angular_speed=-0.14,pwm_left=44,pwm_right=44,battery_voltage=12.21
t=2724,target_linear_speed=2000,ideal_linear_speed=120,measured_linear_speed=31.16,left_measured_linear_speed=27.97,right_measured_linear_speed=34.35,ideal_angular_speed=0.00,measured_angular_speed=0.36,pwm_left=46,pwm_right=46,battery_voltage=12.21
t=2725,target_linear_speed=2000,ideal_linear_speed=125,measured_linear_speed=38.96,left_measured_linear_speed=36.41,right_measured_linear_speed=41.51,ideal_angular_speed=0.00,measured_angular_speed=-0.00,pwm_left=47,pwm_right=47,battery_voltage=12.21
t=2726,target_linear_speed=2000,ideal_linear_speed=130,measured_linear_speed=45.19,left_measured_linear_speed=43.15,right_measured_linear_speed=47.23,ideal_angular_speed=0.00,measured_angular_speed=0.00,pwm_left=48,pwm_right=48,battery_voltage=12.21
t=2727,target_linear_speed=2000,ideal_linear_speed=135,measured_linear_speed=43.17,left_measured_linear_speed=34.52,right_measured_linear_speed=51.81,ideal_angular_speed=0.00,measured_angular_speed=0.10,pwm_left=51,pwm_right=51,battery_voltage=12.20
t=2728,target_linear_speed=2000,ideal_linear_speed=140,measured_linear_speed=48.56,left_measured_linear_speed=41.65,right_measured_linear_speed=55.48,ideal_angular_speed=0.00,measured_angular_speed=0.10,pwm_left=53,pwm_right=53,battery_voltage=12.20
t=2729,target_linear_speed=2000,ideal_linear_speed=145,measured_linear_speed=59.89,left_measured_linear_speed=61.37,right_measured_linear_speed=58.41,ideal_angular_speed=0.00,measured_angular_speed=0.10,pwm_left=53,pwm_right=53,battery_voltage=12.20
t=2730,target_linear_speed=2000,ideal_linear_speed=150,measured_linear_speed=68.96,left_measured_linear_speed=63.13,right_measured_linear_speed=74.79,ideal_angular_speed=0.00,measured_angular_speed=0.00,pwm_left=53,pwm_right=53,battery_voltage=12.20
t=2731,target_linear_speed=2000,ideal_linear_speed=155,measured_linear_speed=62.18,left_measured_linear_speed=64.53,right_measured_linear_speed=59.83,ideal_angular_speed=0.00,measured_angular_speed=-0.16,pwm_left=58,pwm_right=58,battery_voltage=12.19
t=2732,target_linear_speed=2000,ideal_linear_speed=160,measured_linear_speed=77.80,left_measured_linear_speed=79.68,right_measured_linear_speed=75.92,ideal_angular_speed=0.00,measured_angular_speed=0.15,pwm_left=56,pwm_right=56,battery_voltage=12.19
t=2733,target_linear_speed=2000,ideal_linear_speed=165,measured_linear_speed=83.28,left_measured_linear_speed=77.77,right_measured_linear_speed=88.79,ideal_angular_speed=0.00,measured_angular_speed=-0.01,pwm_left=58,pwm_right=58,battery_voltage=12.19
t=2734,target_linear_speed=2000,ideal_linear_speed=170,measured_linear_speed=80.65,left_measured_linear_speed=76.25,right_measured_linear_speed=85.06,ideal_angular_speed=0.00,measured_angular_speed=0.14,pwm_left=61,pwm_right=61,battery_voltage=12.19
t=2735,target_linear_speed=2000,ideal_linear_speed=175,measured_linear_speed=92.58,left_measured_linear_speed=89.05,right_measured_linear_speed=96.10,ideal_angular_speed=0.00,measured_angular_speed=0.14,pwm_left=61,pwm_right=61,battery_voltage=12.18
t=2736,target_linear_speed=2000,ideal_linear_speed=180,measured_linear_speed=95.10,left_measured_linear_speed=85.27,right_measured_linear_speed=104.94,ideal_angular_speed=0.00,measured_angular_speed=-0.20,pwm_left=63,pwm_right=63,battery_voltage=12.18
t=2737,target_linear_speed=2000,ideal_linear_speed=185,measured_linear_speed=97.13,left_measured_linear_speed=96.27,right_measured_linear_speed=97.98,ideal_angular_speed=0.00,measured_angular_speed=0.25,pwm_left=65,pwm_right=65,battery_voltage=12.18
t=2738,target_linear_speed=2000,ideal_linear_speed=190,measured_linear_speed=105.76,left_measured_linear_speed=105.07,right_measured_linear_speed=106.44,ideal_angular_speed=0.00,measured_angular_speed=-0.22,pwm_left=66,pwm_right=66,battery_voltage=12.17
t=2739,target_linear_speed=2000,ideal_linear_speed=195,measured_linear_speed=119.68,left_measured_linear_speed=112.11,right_measured_linear_speed=127.24,ideal_angular_speed=0.00,measured_angular_speed=0.07,pwm_left=65,pwm_right=65,battery_voltage=12.17
t=2740,target_linear_speed=2000,ideal_linear_speed=200,measured_linear_speed=123.80,left_measured_linear_speed=117.75,right_measured_linear_speed=129.84,ideal_angular_speed=0.00,measured_angular_speed=-0.08,pwm_left=66,pwm_right=66,battery_voltage=12.17
t=2741,target_linear_speed=2000,ideal_linear_speed=205,measured_linear_speed=127.09,left_measured_linear_speed=122.25,right_measured_linear_speed=131.93,ideal_angular_speed=0.00,measured_angular_speed=0.05,pwm_left=68,pwm_right=68,battery_voltage=12.16
t=2742,target_linear_speed=2000,ideal_linear_speed=210,measured_linear_speed=136.74,left_measured_linear_speed=139.89,right_measured_linear_speed=133.60,ideal_angular_speed=0.00,measured_angular_speed=0.05,pwm_left=68,pwm_right=68,battery_voltage=12.16
t=2743,target_linear_speed=2000,ideal_linear_speed=215,measured_linear_speed=144.47,left_measured_linear_speed=139.97,right_measured_linear_speed=148.97,ideal_angular_speed=0.00,measured_angular_speed=-0.01,pwm_left=69,pwm_right=69,battery_voltage=12.16
t=2744,target_linear_speed=2000,ideal_linear_speed=220,measured_linear_speed=143.63,left_measured_linear_speed=140.03,right_measured_linear_speed=147.23,ideal_angular_speed=0.00,measured_angular_speed=0.03,pwm_left=72,pwm_right=72,battery_voltage=12.16
t=2745,target_linear_speed=2000,ideal_linear_speed=225,measured_linear_speed=156.99,left_measured_linear_speed=154.11,right_measured_linear_speed=159.87,ideal_angular_speed=0.00,measured_angular_speed=0.25,pwm_left=71,pwm_right=71,battery_voltage=12.16
t=2746,target_linear_speed=2000,ideal_linear_speed=230,measured_linear_speed=167.67,left_measured_linear_speed=179.40,right_measured_linear_speed=155.95,ideal_angular_speed=0.00,measured_angular_speed=-0.14,pwm_left=70,pwm_right=70,battery_voltage=12.15
t=2747,target_linear_speed=2000,ideal_linear_speed=235,measured_linear_speed=169.21,left_measured_linear_speed=171.57,right_measured_linear_speed=166.84,ideal_angular_speed=0.00,measured_angular_speed=0.08,pwm_left=72,pwm_right=72,battery_voltage=12.15
t=2748,target_linear_speed=2000,ideal_linear_speed=240,measured_linear_speed=184.46,left_measured_linear_speed=193.37,right_measured_linear_speed=175.56,ideal_angular_speed=0.00,measured_angular_speed=-0.32,pwm_left=71,pwm_right=71,battery_voltage=12.15
t=2749,target_linear_speed=2000,ideal_linear_speed=245,measured_linear_speed=189.66,left_measured_linear_speed=182.75,right_measured_linear_speed=196.56,ideal_angular_speed=0.00,measured_angular_speed=-0.24,pwm_left=72,pwm_right=72,battery_voltage=12.15
t=2750,target_linear_speed=2000,ideal_linear_speed=250,measured_linear_speed=207.84,left_measured_linear_speed=216.34,right_measured_linear_speed=199.33,ideal_angular_speed=0.00,measured_angular_speed=-0.24,pwm_left=69,pwm_right=69,battery_voltage=12.15
t=2751,target_linear_speed=2000,ideal_linear_speed=255,measured_linear_speed=215.37,left_measured_linear_speed=215.16,right_measured_linear_speed=215.58,ideal_angular_speed=0.00,measured_angular_speed=-0.30,pwm_left=69,pwm_right=69,battery_voltage=12.15
t=2752,target_linear_speed=2000,ideal_linear_speed=260,measured_linear_speed=214.38,left_measured_linear_speed=214.21,right_measured_linear_speed=214.55,ideal_angular_speed=0.00,measured_angular_speed=0.14,pwm_left=71,pwm_right=71,battery_voltage=12.15
t=2753,target_linear_speed=2000,ideal_linear_speed=265,measured_linear_speed=220.60,left_measured_linear_speed=227.48,right_measured_linear_speed=213.72,ideal_angular_speed=0.00,measured_angular_speed=-0.20,pwm_left=72,pwm_right=72,battery_voltage=12.15
t=2754,target_linear_speed=2000,ideal_linear_speed=270,measured_linear_speed=232.59,left_measured_linear_speed=238.10,right_measured_linear_speed=227.09,ideal_angular_speed=0.00,measured_angular_speed=-0.39,pwm_left=71,pwm_right=71,battery_voltage=12.15
t=2755,target_linear_speed=2000,ideal_linear_speed=275,measured_linear_speed=235.17,left_measured_linear_speed=246.59,right_measured_linear_speed=223.75,ideal_angular_speed=0.00,measured_angular_speed=-0.18,pwm_left=72,pwm_right=72,battery_voltage=12.15
t=2756,target_linear_speed=2000,ideal_linear_speed=280,measured_linear_speed=251.26,left_measured_linear_speed=253.38,right_measured_linear_speed=249.14,ideal_angular_speed=0.00,measured_angular_speed=-0.23,pwm_left=69,pwm_right=69,battery_voltage=12.15
t=2757,target_linear_speed=2000,ideal_linear_speed=285,measured_linear_speed=257.12,left_measured_linear_speed=272.85,right_measured_linear_speed=241.40,ideal_angular_speed=0.00,measured_angular_speed=-0.23,pwm_left=70,pwm_right=70,battery_voltage=12.15
t=2758,target_linear_speed=2000,ideal_linear_speed=290,measured_linear_speed=268.82,left_measured_linear_speed=274.39,right_measured_linear_speed=263.26,ideal_angular_speed=0.00,measured_angular_speed=-0.00,pwm_left=68,pwm_right=68,battery_voltage=12.15
t=2759,target_linear_speed=2000,ideal_linear_speed=295,measured_linear_speed=271.17,left_measured_linear_speed=289.65,right_measured_linear_speed=252.69,ideal_angular_speed=0.00,measured_angular_speed=-0.33,pwm_left=69,pwm_right=69,battery_voltage=12.14
t=2760,target_linear_speed=2000,ideal_linear_speed=300,measured_linear_speed=280.06,left_measured_linear_speed=287.83,right_measured_linear_speed=272.29,ideal_angular_speed=0.00,measured_angular_speed=-0.07,pwm_left=69,pwm_right=69,battery_voltage=12.14
t=2761,target_linear_speed=2000,ideal_linear_speed=305,measured_linear_speed=280.16,left_measured_linear_speed=286.38,right_measured_linear_speed=273.95,ideal_angular_speed=0.00,measured_angular_speed=-0.37,pwm_left=70,pwm_right=70,battery_voltage=12.14
t=2762,target_linear_speed=2000,ideal_linear_speed=310,measured_linear_speed=301.28,left_measured_linear_speed=313.27,right_measured_linear_speed=289.30,ideal_angular_speed=0.00,measured_angular_speed=-0.10,pwm_left=66,pwm_right=66,battery_voltage=12.14
t=2763,target_linear_speed=2000,ideal_linear_speed=315,measured_linear_speed=304.15,left_measured_linear_speed=320.76,right_measured_linear_speed=287.55,ideal_angular_speed=0.00,measured_angular_speed=-0.37,pwm_left=67,pwm_right=67,battery_voltage=12.14
t=2764,target_linear_speed=2000,ideal_linear_speed=320,measured_linear_speed=306.45,left_measured_linear_speed=312.72,right_measured_linear_speed=300.18,ideal_angular_speed=0.00,measured_angular_speed=0.01,pwm_left=68,pwm_right=68,battery_voltage=12.14
t=2765,target_linear_speed=2000,ideal_linear_speed=325,measured_linear_speed=308.28,left_measured_linear_speed=320.31,right_measured_linear_speed=296.26,ideal_angular_speed=0.00,measured_angular_speed=0.01,pwm_left=69,pwm_right=69,battery_voltage=12.14
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
