OPRobots/DragonBot2/source_code/.features/pid_tuning/line_control_run.png

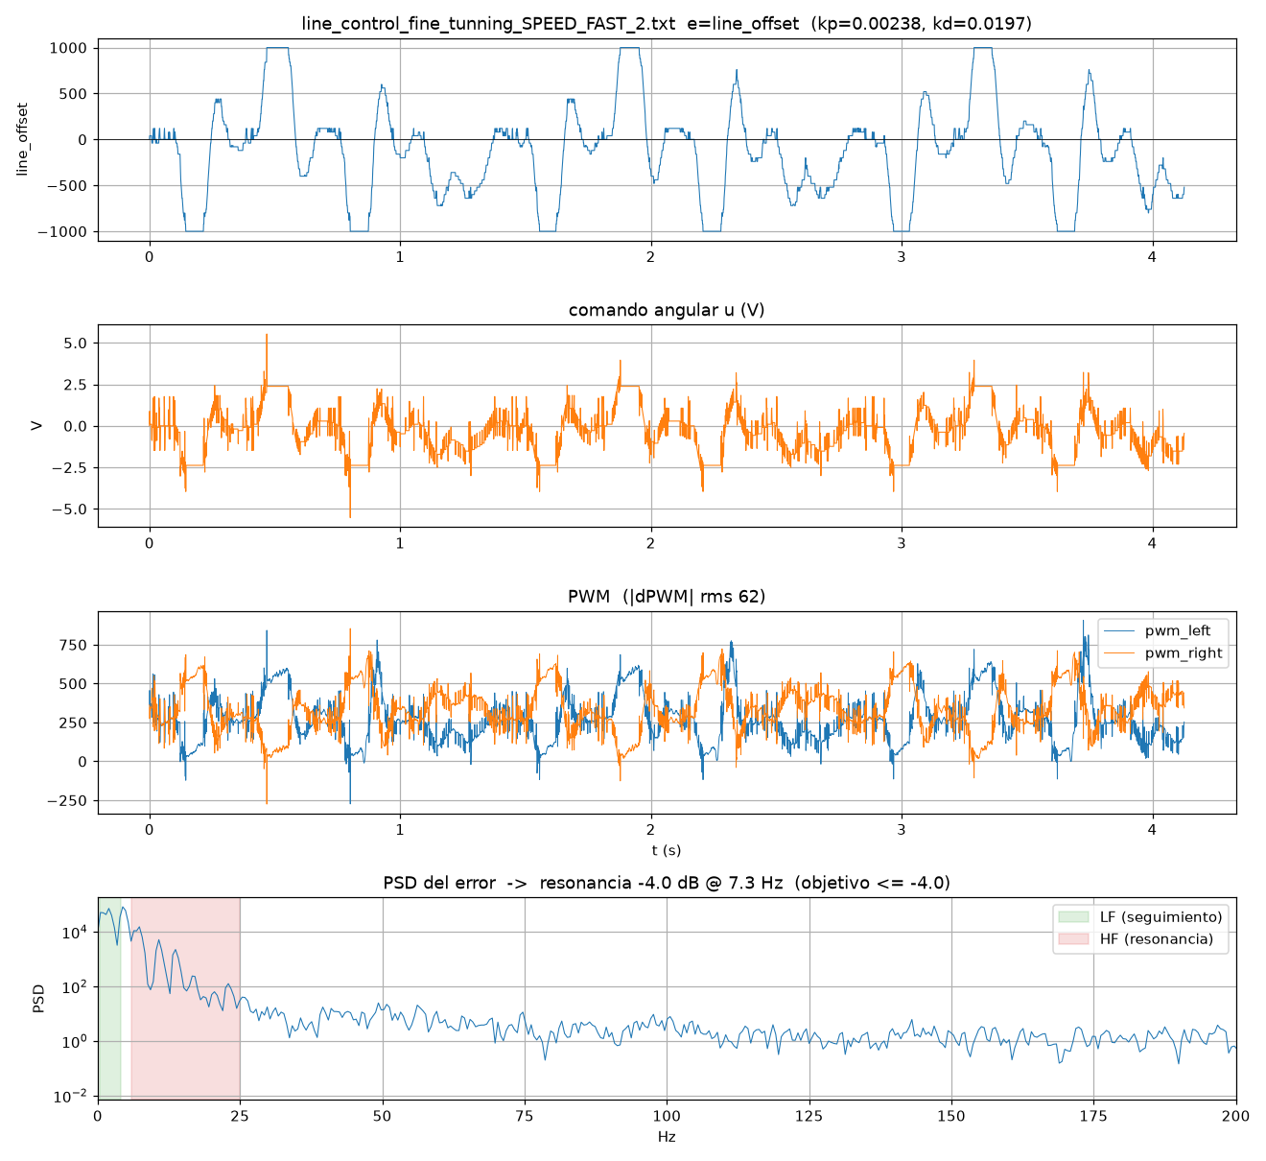
source_code/.features/pid_tuning/line_control_run.png
