OPRobots/DragonBot2/pcb_files/kicad_project/main/main.kicad_pcb

## KiCad design pcb_files/kicad_project/main/main.kicad_pcb (2026-04-05)

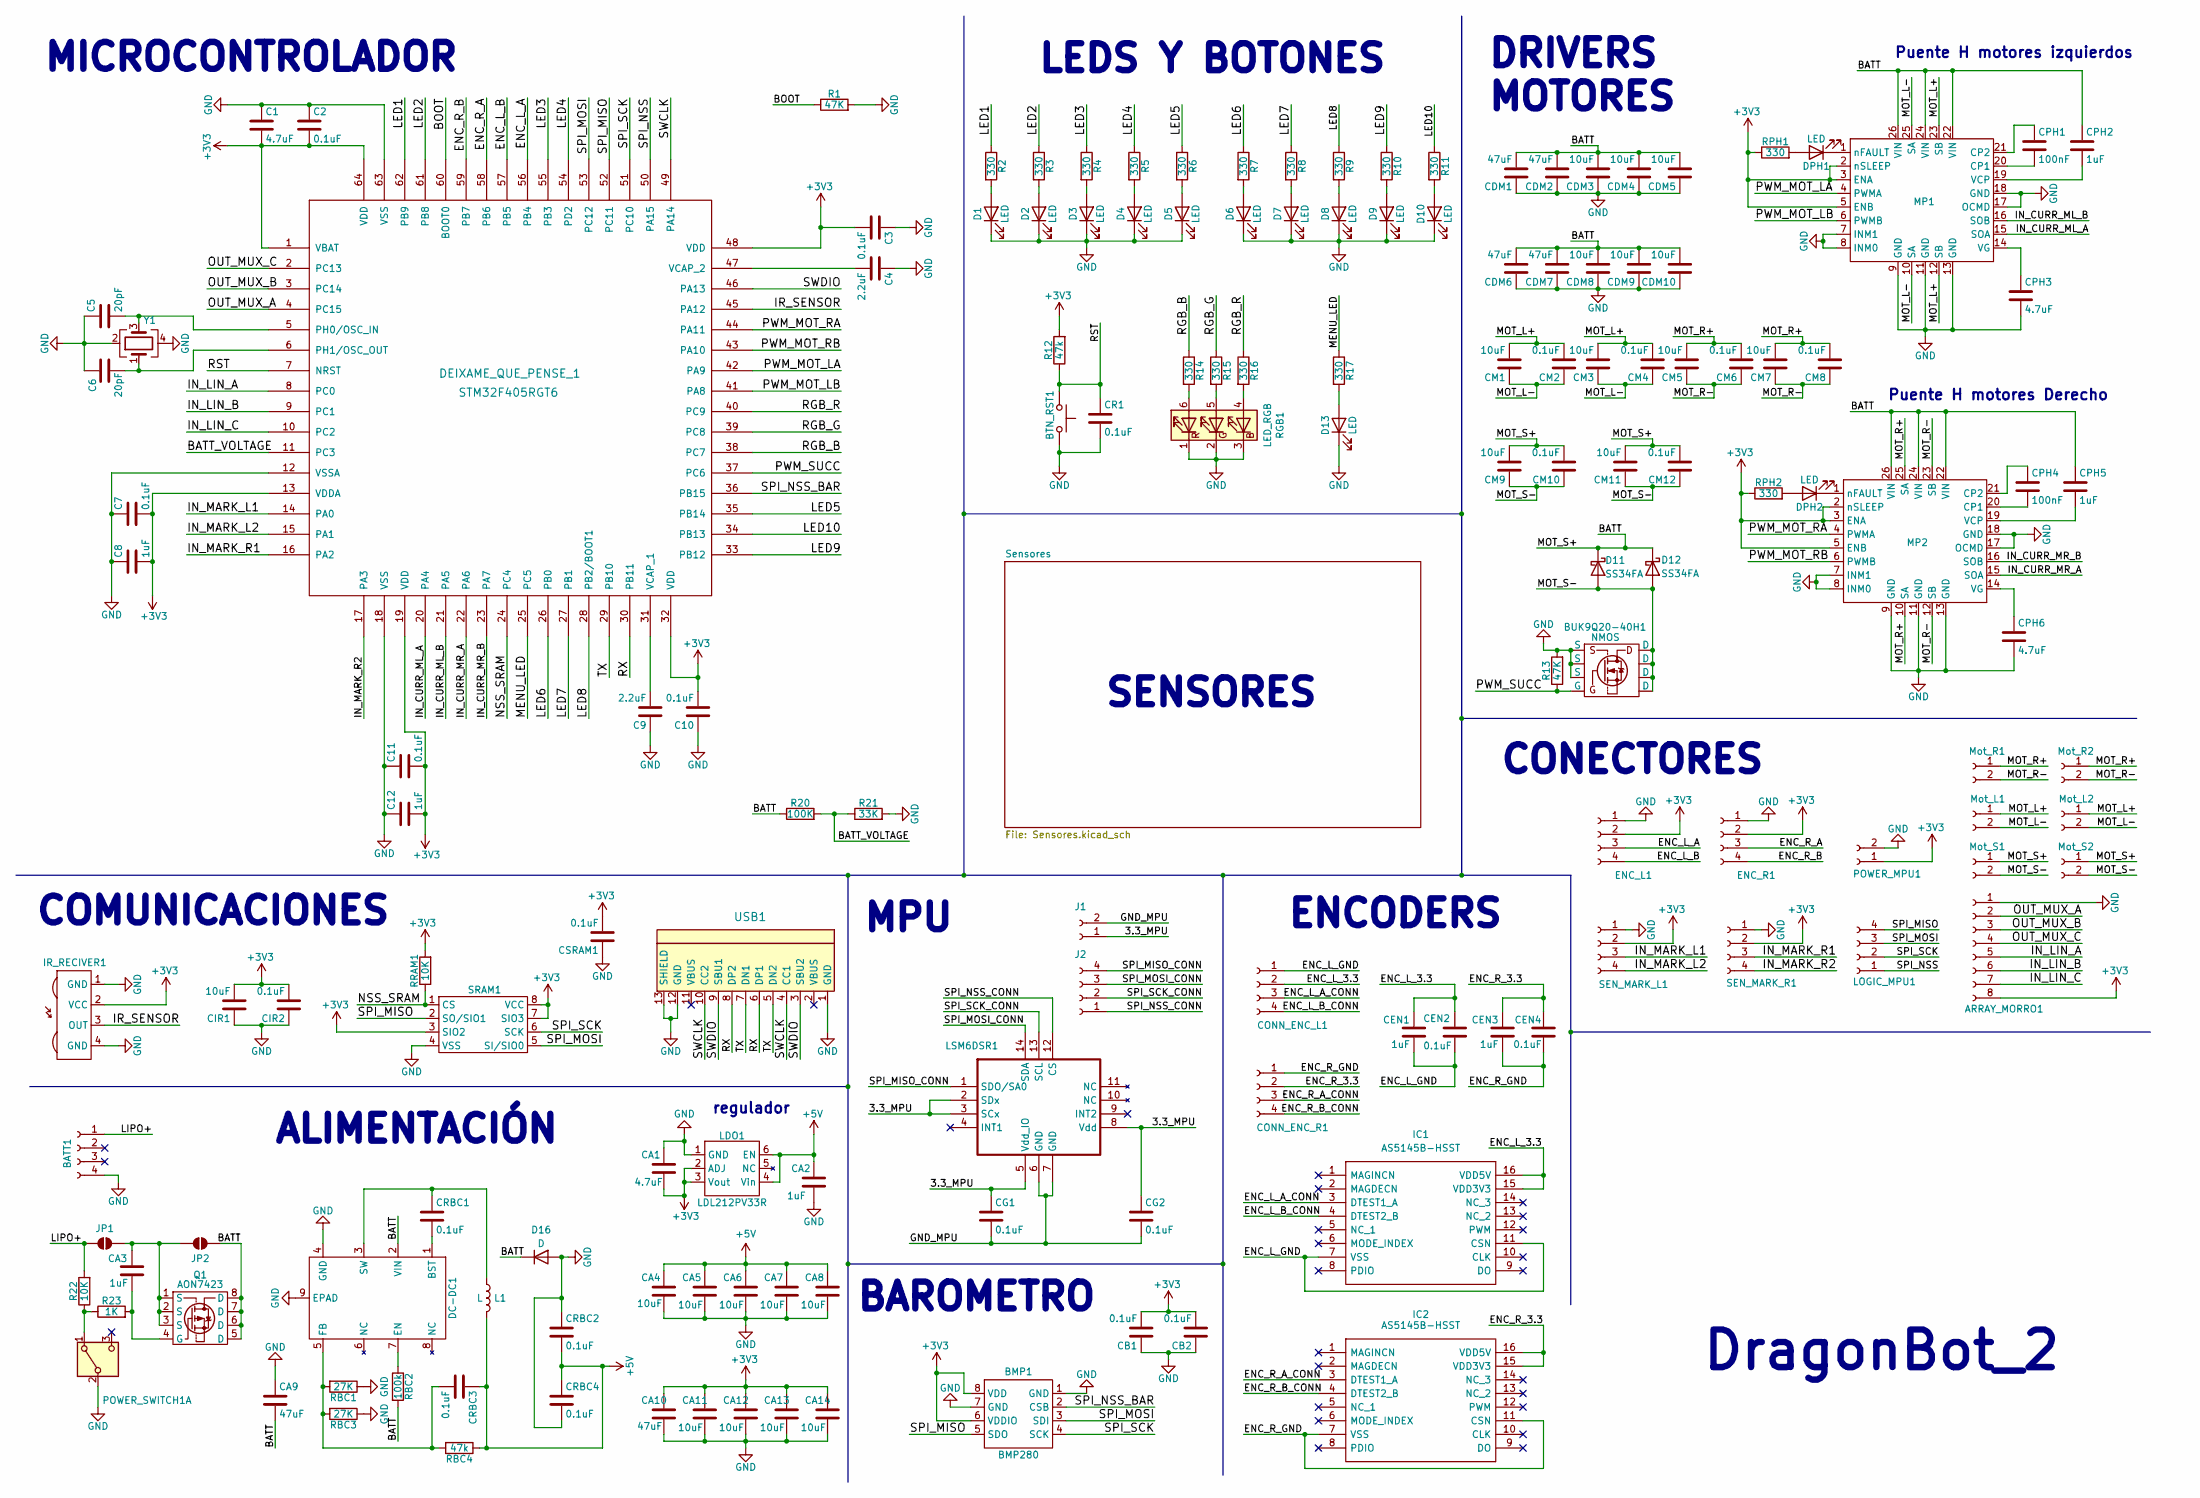
[picture p6: schematic main.kicad_sch]

Parts:
ARRAY_MORRO1: Conn_01x08_Socket; DragonBot_pads_main
BATT1: Conn_01x04_Socket; JST_XH_B4B-XH-AM_1x04_P2.50mm_Vertical
BMP1: BMP280; Bosch_LGA-8_2.5x2.5mm_P0.65mm_ClockwisePinNumbering
BTN_RST1: Generic_SmallButton_6x3
BUK9Q20-40H1: NMOS; Mosfet_succion_BUK9Q20
C1: 4.7uF; C_0402_1005Metric_Pad0.74x0.62mm_HandSolder
C2, C3, C7, C10, C11: 0.1uF; C_0402_1005Metric_Pad0.74x0.62mm_HandSolder
C4, C9: 2.2uF; C_0402_1005Metric_Pad0.74x0.62mm_HandSolder
C5, C6: 20pF; C_0402_1005Metric_Pad0.74x0.62mm_HandSolder
C8, C12: 1uF; C_0402_1005Metric_Pad0.74x0.62mm_HandSolder
CA1: 4.7uF; C_0402_1005Metric_Pad0.74x0.62mm_HandSolder
CA2, CA3: 1uF; C_0402_1005Metric_Pad0.74x0.62mm_HandSolder
CA4, CA5, CA6, CA7, CA8, CA11, CA12, CA13, CA14: 10uF; C_0402_1005Metric_Pad0.74x0.62mm_HandSolder
CA9: 47uF; C_1206_3216Metric
CA10: 47uF; C_0805_2012Metric
CB1, CB2: 0.1uF; C_0402_1005Metric_Pad0.74x0.62mm_HandSolder
CDM1, CDM2, CDM6, CDM7: 47uF; C_0805_2012Metric
CDM3, CDM4, CDM5, CDM8, CDM9, CDM10: 10uF; C_0402_1005Metric_Pad0.74x0.62mm_HandSolder
CEN1, CEN3: 1uF; C_0402_1005Metric_Pad0.74x0.62mm_HandSolder
CEN2, CEN4: 0.1uF; C_0402_1005Metric_Pad0.74x0.62mm_HandSolder
CG1, CG2: 0.1uF; C_0402_1005Metric_Pad0.74x0.62mm_HandSolder
CIR1: 10uF; C_0402_1005Metric_Pad0.74x0.62mm_HandSolder
CIR2: 0.1uF; C_0402_1005Metric_Pad0.74x0.62mm_HandSolder
CM1, CM3, CM5, CM7, CM9, CM11: 10uF; C_0402_1005Metric_Pad0.74x0.62mm_HandSolder
CM2, CM4, CM6, CM8, CM10, CM12: 0.1uF; C_0402_1005Metric_Pad0.74x0.62mm_HandSolder
CONN_ENC_L1: Conn_01x04_Socket; FujitoraBot2_PCBmodule_encoder
CONN_ENC_R1: Conn_01x04_Socket; FujitoraBot2_PCBmodule_encoder
CPH1, CPH4: 100nF; C_0402_1005Metric_Pad0.74x0.62mm_HandSolder
CPH2, CPH5: 1uF; C_0402_1005Metric_Pad0.74x0.62mm_HandSolder
CPH3, CPH6: 4.7uF; C_0402_1005Metric_Pad0.74x0.62mm_HandSolder
CR1: 0.1uF; C_0402_1005Metric_Pad0.74x0.62mm_HandSolder
CRBC1, CRBC2, CRBC3, CRBC4: 0.1uF; C_0402_1005Metric_Pad0.74x0.62mm_HandSolder
CSRAM1: 0.1uF; C_0402_1005Metric_Pad0.74x0.62mm_HandSolder
D1, D2, D3, D4, D5, D6, D7, D8, D9, D10: LED; LED_0805_2012Metric
D11, D12: SS34FA; D_SOD-123
D13: LED; LED_0402_1005Metric_Pad0.77x0.64mm_HandSolder
D16: D; D_0805_2012Metric_Pad1.15x1.40mm_HandSolder
DC-DC1: Texas_HTSOP-8-1EP_3.9x4.9mm_P1.27mm_EP2.95x4.9mm_Mask2.4x3.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
DEIXAME_QUE_PENSE_1: STM32F405RGT6; LQFP-64_10x10mm_P0.5mm
DPH1, DPH2: LED; LED_0402_1005Metric_Pad0.77x0.64mm_HandSolder
ENC_L1: Conn_01x04_Socket; DragonBot2_Encoder_main
ENC_R1: Conn_01x04_Socket; DragonBot2_Encoder_main
IC1, IC2: AS5145B-HSST; Encoder_AS5145B
IR_RECIVER1: IR_SENSOR_SMD_TSSP77038ETR
J1: Conn_01x02_Socket; ZoroBot3_Power_MPU
J2: Conn_01x04_Socket; ZoroBot3_Data_MPU
JP1, JP2: SolderJumper_2_Open; SolderJumper-2_P1.3mm_Open_RoundedPad1.0x1.5mm
L1: L; L_Wuerth_HCM-7050
LDO1: LDL212PV33R; DFN-6-1EP_3x3mm_P0.95mm_EP1.7x2.6mm
LOGIC_MPU1: Conn_01x04_Socket; ZoroBot3_Data_MPU
LSM6DSR1: LGA-14_3x2.5mm_P0.5mm_LayoutBorder3x4y
MP1, MP2: MP6615
Mot_L1, Mot_L2: Conn_01x02_Socket; Connector_motor_1.25_Hirose_DF13-02P-1.25DSA_1x02_P1.25mm_V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
Mot_R1, Mot_R2: Conn_01x02_Socket; Connector_motor_1.25_Hirose_DF13-02P-1.25DSA_1x02_P1.25mm_V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
Mot_S1, Mot_S2: Conn_01x02_Socket; Connector_motor_1.25_Hirose_DF13-02P-1.25DSA_1x02_P1.25mm_V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
POWER_MPU1: Conn_01x02_Socket; ZoroBot3_Power_MPU
POWER_SWITCH1: SW_DPDT_x2; Generic_Swich_ONOFF
Q1: AON7423
R1, R13: 47K; R_0402_1005Metric_Pad0.72x0.64mm_HandSolder
R2, R3, R4, R5, R6, R7, R8, R9, R10, R11, R14, R15, R16, R17: 330; R_0402_1005Metric_Pad0.72x0.64mm_HandSolder
R12: 47k; R_0402_1005Metric_Pad0.72x0.64mm_HandSolder
R20: 100K; R_0402_1005Metric_Pad0.72x0.64mm_HandSolder
R21: 33K; R_0402_1005Metric_Pad0.72x0.64mm_HandSolder
R22: 10K; R_0402_1005Metric_Pad0.72x0.64mm_HandSolder
R23: 1K; R_0402_1005Metric_Pad0.72x0.64mm_HandSolder
RBC1, RBC3: 27K; R_0402_1005Metric_Pad0.72x0.64mm_HandSolder
RBC2: 100k; R_0402_1005Metric_Pad0.72x0.64mm_HandSolder
RBC4: 47k; R_0402_1005Metric_Pad0.72x0.64mm_HandSolder
RGB1: LED_RGB; LED_RGB_5050-6
RPH1, RPH2: 330; R_0402_1005Metric_Pad0.72x0.64mm_HandSolder
RRAM1: 10K; R_0402_1005Metric_Pad0.72x0.64mm_HandSolder
SEN_MARK_L1: Conn_01x04_Socket; DragonBot_pad_marcas
SEN_MARK_R1: Conn_01x04_Socket; DragonBot_pad_marcas
SRAM1: 23AA04M-I/ST; TSSOP-8_4.4x3mm_P0.65mm
USB1: USB-C ST-Link USART
Y1: Crystal_GND24; Crystal_SMD_TXC_7M-4Pin_3.2x2.5mm

Connections:
+5V: CA2.1, CA4.1, CA5.1, CA6.1, CA7.1, CA8.1, CRBC2.2, CRBC3.1, CRBC4.1, L1.2, LDO1.4 (Vin), LDO1.6 (EN), RBC4.1
/BATT: CA9.2, CDM1.2, CDM2.2, CDM3.2, CDM4.2, CDM5.2, CDM6.2, CDM7.2, CDM8.2, CDM9.2, CDM10.2, CM9.2, CM10.2, CM11.2, CM12.2, CPH2.1, CPH5.1, D11.1 (K), D12.1 (K), D16.1 (K), DC-DC1.2 (VIN), JP2.2 (B), MP1.22 (VIN), MP1.24 (VIN), MP1.26 (VIN), MP2.22 (VIN), MP2.24 (VIN), MP2.26 (VIN), Mot_S1.1, Mot_S2.1, Q1.5 (D), Q1.6 (D), Q1.7 (D), Q1.8 (D), R20.1, RBC2.2
/BATT_VOLTAGE: DEIXAME_QUE_PENSE_1.11 (PC3), R20.2, R21.1
/BOOT: DEIXAME_QUE_PENSE_1.60 (BOOT0), R1.1
/ENC_L_3.3: CEN1.1, CEN2.1, CONN_ENC_L1.2, IC1.15 (VDD3V3), IC1.16 (VDD5V)
/ENC_L_A: DEIXAME_QUE_PENSE_1.56 (PB4), ENC_L1.3
/ENC_L_A_CONN: CONN_ENC_L1.3, IC1.3 (DTEST1_A)
/ENC_L_B: DEIXAME_QUE_PENSE_1.57 (PB5), ENC_L1.4
/ENC_L_B_CONN: CONN_ENC_L1.4, IC1.4 (DTEST2_B)
/ENC_L_GND: CEN1.2, CEN2.2, CONN_ENC_L1.1, IC1.7 (VSS), IC1.11 (CSN)
/ENC_R_3.3: CEN3.1, CEN4.1, CONN_ENC_R1.2, IC2.15 (VDD3V3), IC2.16 (VDD5V)
/ENC_R_A: DEIXAME_QUE_PENSE_1.58 (PB6), ENC_R1.3
/ENC_R_A_CONN: CONN_ENC_R1.3, IC2.3 (DTEST1_A)
/ENC_R_B: DEIXAME_QUE_PENSE_1.59 (PB7), ENC_R1.4
/ENC_R_B_CONN: CONN_ENC_R1.4, IC2.4 (DTEST2_B)
/ENC_R_GND: CEN3.2, CEN4.2, CONN_ENC_R1.1, IC2.7 (VSS), IC2.11 (CSN)
/GND_MPU: CG1.2, CG2.2, J1.2, LSM6DSR1.6 (GND), LSM6DSR1.7 (GND)
/IN_CURR_ML_A: DEIXAME_QUE_PENSE_1.20 (PA4), MP1.15 (SOA)
/IN_CURR_ML_B: DEIXAME_QUE_PENSE_1.21 (PA5), MP1.16 (SOB)
/IN_CURR_MR_A: DEIXAME_QUE_PENSE_1.22 (PA6), MP2.15 (SOA)
/IN_CURR_MR_B: DEIXAME_QUE_PENSE_1.23 (PA7), MP2.16 (SOB)
/IN_LIN_A: ARRAY_MORRO1.5, DEIXAME_QUE_PENSE_1.8 (PC0)
/IN_LIN_B: ARRAY_MORRO1.6, DEIXAME_QUE_PENSE_1.9 (PC1)
/IN_LIN_C: ARRAY_MORRO1.7, DEIXAME_QUE_PENSE_1.10 (PC2)
/IN_MARK_L1: DEIXAME_QUE_PENSE_1.14 (PA0), SEN_MARK_L1.3
/IN_MARK_L2: DEIXAME_QUE_PENSE_1.15 (PA1), SEN_MARK_L1.4
/IN_MARK_R1: DEIXAME_QUE_PENSE_1.16 (PA2), SEN_MARK_R1.3
/IN_MARK_R2: DEIXAME_QUE_PENSE_1.17 (PA3), SEN_MARK_R1.4
/IR_SENSOR: DEIXAME_QUE_PENSE_1.45 (PA12), IR_RECIVER1.3 (OUT)
/LED1: DEIXAME_QUE_PENSE_1.62 (PB9), R2.1
/LED2: DEIXAME_QUE_PENSE_1.61 (PB8), R3.1
/LED3: DEIXAME_QUE_PENSE_1.55 (PB3), R4.1
/LED4: DEIXAME_QUE_PENSE_1.54 (PD2), R5.1
/LED5: DEIXAME_QUE_PENSE_1.35 (PB14), R6.1
/LED6: DEIXAME_QUE_PENSE_1.26 (PB0), R7.1
/LED7: DEIXAME_QUE_PENSE_1.27 (PB1), R8.1
/LED8: DEIXAME_QUE_PENSE_1.28 (PB2/BOOT1), R9.1
/LED9: DEIXAME_QUE_PENSE_1.33 (PB12), R10.1
/LED10: DEIXAME_QUE_PENSE_1.34 (PB13), R11.1
/LIPO+: BATT1.1, JP1.2 (B), R22.2
/MENU_LED: DEIXAME_QUE_PENSE_1.25 (PC5), R17.1
/MOT_L+: CM1.2, CM2.2, CM3.2, CM4.2, MP1.12 (SB), MP1.23 (SB), Mot_L1.1, Mot_L2.1
/MOT_L-: CM1.1, CM2.1, CM3.1, CM4.1, MP1.10 (SA), MP1.25 (SA), Mot_L1.2, Mot_L2.2
/MOT_R+: CM5.2, CM6.2, CM7.2, CM8.2, MP2.10 (SA), MP2.25 (SA), Mot_R1.1, Mot_R2.1
/MOT_R-: CM5.1, CM6.1, CM7.1, CM8.1, MP2.12 (SB), MP2.23 (SB), Mot_R1.2, Mot_R2.2
/MOT_S-: BUK9Q20-40H1.5 (D), BUK9Q20-40H1.6 (D), BUK9Q20-40H1.7 (D), BUK9Q20-40H1.8 (D), CM9.1, CM10.1, CM11.1, CM12.1, D11.2 (A), D12.2 (A), Mot_S1.2, Mot_S2.2
/NSS_SRAM: DEIXAME_QUE_PENSE_1.24 (PC4), RRAM1.1, SRAM1.1 (CS)
/OUT_MUX_A: ARRAY_MORRO1.2, DEIXAME_QUE_PENSE_1.4 (PC15)
/OUT_MUX_B: ARRAY_MORRO1.3, DEIXAME_QUE_PENSE_1.3 (PC14)
/OUT_MUX_C: ARRAY_MORRO1.4, DEIXAME_QUE_PENSE_1.2 (PC13)
/PWM_MOT_LA: DEIXAME_QUE_PENSE_1.42 (PA9), MP1.4 (PWMA)
/PWM_MOT_LB: DEIXAME_QUE_PENSE_1.41 (PA8), MP1.6 (PWMB)
/PWM_MOT_RA: DEIXAME_QUE_PENSE_1.44 (PA11), MP2.4 (PWMA)
/PWM_MOT_RB: DEIXAME_QUE_PENSE_1.43 (PA10), MP2.6 (PWMB)
/PWM_SUCC: BUK9Q20-40H1.4 (G), DEIXAME_QUE_PENSE_1.37 (PC6), R13.1
/RGB_B: DEIXAME_QUE_PENSE_1.38 (PC7), R14.1
/RGB_G: DEIXAME_QUE_PENSE_1.39 (PC8), R15.1
/RGB_R: DEIXAME_QUE_PENSE_1.40 (PC9), R16.1
/RST: BTN_RST1.1, CR1.1, DEIXAME_QUE_PENSE_1.7 (NRST), R12.1
/RX: DEIXAME_QUE_PENSE_1.30 (PB11), USB1.6 (DP1), USB1.8 (DP2)
/SPI_MISO: BMP1.5 (SDO), DEIXAME_QUE_PENSE_1.52 (PC11), LOGIC_MPU1.4, SRAM1.2 (SO/SIO1)
/SPI_MISO_CONN: J2.4, LSM6DSR1.1 (SDO/SA0)
/SPI_MOSI: BMP1.3 (SDI), DEIXAME_QUE_PENSE_1.53 (PC12), LOGIC_MPU1.3, SRAM1.5 (SI/SIO0)
/SPI_MOSI_CONN: J2.3, LSM6DSR1.14 (SDA)
/SPI_NSS: DEIXAME_QUE_PENSE_1.50 (PA15), LOGIC_MPU1.1
/SPI_NSS_BAR: BMP1.2 (CSB), DEIXAME_QUE_PENSE_1.36 (PB15)
/SPI_NSS_CONN: J2.1, LSM6DSR1.12 (CS)
/SPI_SCK: BMP1.4 (SCK), DEIXAME_QUE_PENSE_1.51 (PC10), LOGIC_MPU1.2, SRAM1.6 (SCK)
/SPI_SCK_CONN: J2.2, LSM6DSR1.13 (SCL)
/SWCLK: DEIXAME_QUE_PENSE_1.49 (PA14), USB1.4 (CC1), USB1.10 (CC2)
/SWDIO: DEIXAME_QUE_PENSE_1.46 (PA13), USB1.3 (SBU2), USB1.9 (SBU1)
/Sensores/MARK_L1: IC1.1 (MAGINCN); also elsewhere on the board
/Sensores/MARK_R2: IC2.8 (PDIO); also elsewhere on the board
/TX: DEIXAME_QUE_PENSE_1.29 (PB10), USB1.5 (DN2), USB1.7 (DN1)
GND: ARRAY_MORRO1.1, BATT1.4, BMP1.1 (GND), BMP1.7 (GND), BTN_RST1.2, BUK9Q20-40H1.1 (S), BUK9Q20-40H1.2 (S), BUK9Q20-40H1.3 (S), C1.1, C2.1, C3.1, C4.1, C5.1, C6.1, C7.1, C8.1, C9.1, C10.1, C11.1, C12.1, CA1.1, CA2.2, CA4.2, CA5.2, CA6.2, CA7.2, CA8.2, CA9.1, CA10.2, CA11.2, CA12.2, CA13.2, CA14.2, CB1.1, CB2.1, CDM1.1, CDM2.1, CDM3.1, CDM4.1, CDM5.1, CDM6.1, CDM7.1, CDM8.1, CDM9.1, CDM10.1, CIR1.1, CIR2.1, CPH3.2, CPH6.2, CR1.2, CRBC2.1, CRBC4.2, CSRAM1.1, D1.1 (K), D2.1 (K), D3.1 (K), D4.1 (K), D5.1 (K), D6.1 (K), D7.1 (K), D8.1 (K), D9.1 (K), D10.1 (K), D13.1 (K), D16.2 (A), DC-DC1.4 (GND), DC-DC1.9 (EPAD), DEIXAME_QUE_PENSE_1.12 (VSSA), DEIXAME_QUE_PENSE_1.18 (VSS), DEIXAME_QUE_PENSE_1.63 (VSS), ENC_L1.1, ENC_R1.1, IR_RECIVER1.1 (GND), IR_RECIVER1.4 (GND), LDO1.1 (GND), MP1.7 (INM1), MP1.8 (INM0), MP1.9 (GND), MP1.11 (GND), MP1.13 (GND), MP1.17 (OCMD), MP1.18 (GND), MP2.7 (INM1), MP2.8 (INM0), MP2.9 (GND), MP2.11 (GND), MP2.13 (GND), MP2.17 (OCMD), MP2.18 (GND), POWER_MPU1.2, POWER_SWITCH1.2 (B), R1.2, R13.2, R21.2, RBC1.1, RBC3.1, RGB1.1 (RK), RGB1.2 (GK), RGB1.3 (BK), SEN_MARK_L1.1, SEN_MARK_R1.1, SRAM1.4 (VSS), USB1.1 (GND), USB1.12 (GND), USB1.13 (SHIELD), Y1.2, Y1.4
unnamed: D1.2 (A), R2.2
unnamed: D2.2 (A), R3.2
unnamed: D3.2 (A), R4.2
unnamed: D4.2 (A), R5.2
unnamed: D5.2 (A), R6.2
unnamed: D6.2 (A), R7.2
unnamed: D7.2 (A), R8.2
unnamed: D8.2 (A), R9.2
unnamed: D9.2 (A), R10.2
unnamed: D10.2 (A), R11.2
unnamed: D13.2 (A), R17.2
unnamed: CRBC1.2, DC-DC1.1 (BST)
unnamed: DC-DC1.7 (EN), RBC2.1
unnamed: CRBC3.2, DC-DC1.5 (FB), RBC1.2, RBC3.2, RBC4.2
unnamed: CRBC1.1, DC-DC1.3 (SW), L1.1
unnamed: C5.2, DEIXAME_QUE_PENSE_1.5 (PH0/OSC_IN), Y1.3
unnamed: C6.2, DEIXAME_QUE_PENSE_1.6 (PH1/OSC_OUT), Y1.1
unnamed: C9.2, DEIXAME_QUE_PENSE_1.31 (VCAP_1)
unnamed: C4.2, DEIXAME_QUE_PENSE_1.47 (VCAP_2)
unnamed: DPH1.2 (A), RPH1.2
unnamed: DPH1.1 (K), MP1.1 (nFAULT)
unnamed: DPH2.2 (A), RPH2.2
unnamed: DPH2.1 (K), MP2.1 (nFAULT)
unnamed: CA3.1, JP1.1 (A), JP2.1 (A), Q1.1 (S), Q1.2 (S), Q1.3 (S)
unnamed: CPH1.2, MP1.20 (CP1)
unnamed: CPH1.1, MP1.21 (CP2)
unnamed: CPH2.2, MP1.19 (VCP)
unnamed: CPH3.1, MP1.14 (VG)
unnamed: CPH4.2, MP2.20 (CP1)
unnamed: CPH4.1, MP2.21 (CP2)
unnamed: CPH5.2, MP2.19 (VCP)
unnamed: CPH6.1, MP2.14 (VG)
unnamed: POWER_SWITCH1.1 (A), R22.1, R23.1
unnamed: CA3.2, Q1.4 (G), R23.2
unnamed: R16.2, RGB1.4 (BA)
unnamed: R15.2, RGB1.5 (GA)
unnamed: R14.2, RGB1.6 (RA)

Notes on the sheet:
MICROCONTROLADOR
BAROMETRO
DRIVERS MOTORES
DragonBot_2
Puente H motores Derecho
Puente H motores izquierdos
LEDS Y BOTONES
regulador
ENCODERS
CONECTORES
MPU
SENSORES
ALIMENTACIÓN
COMUNICACIONES

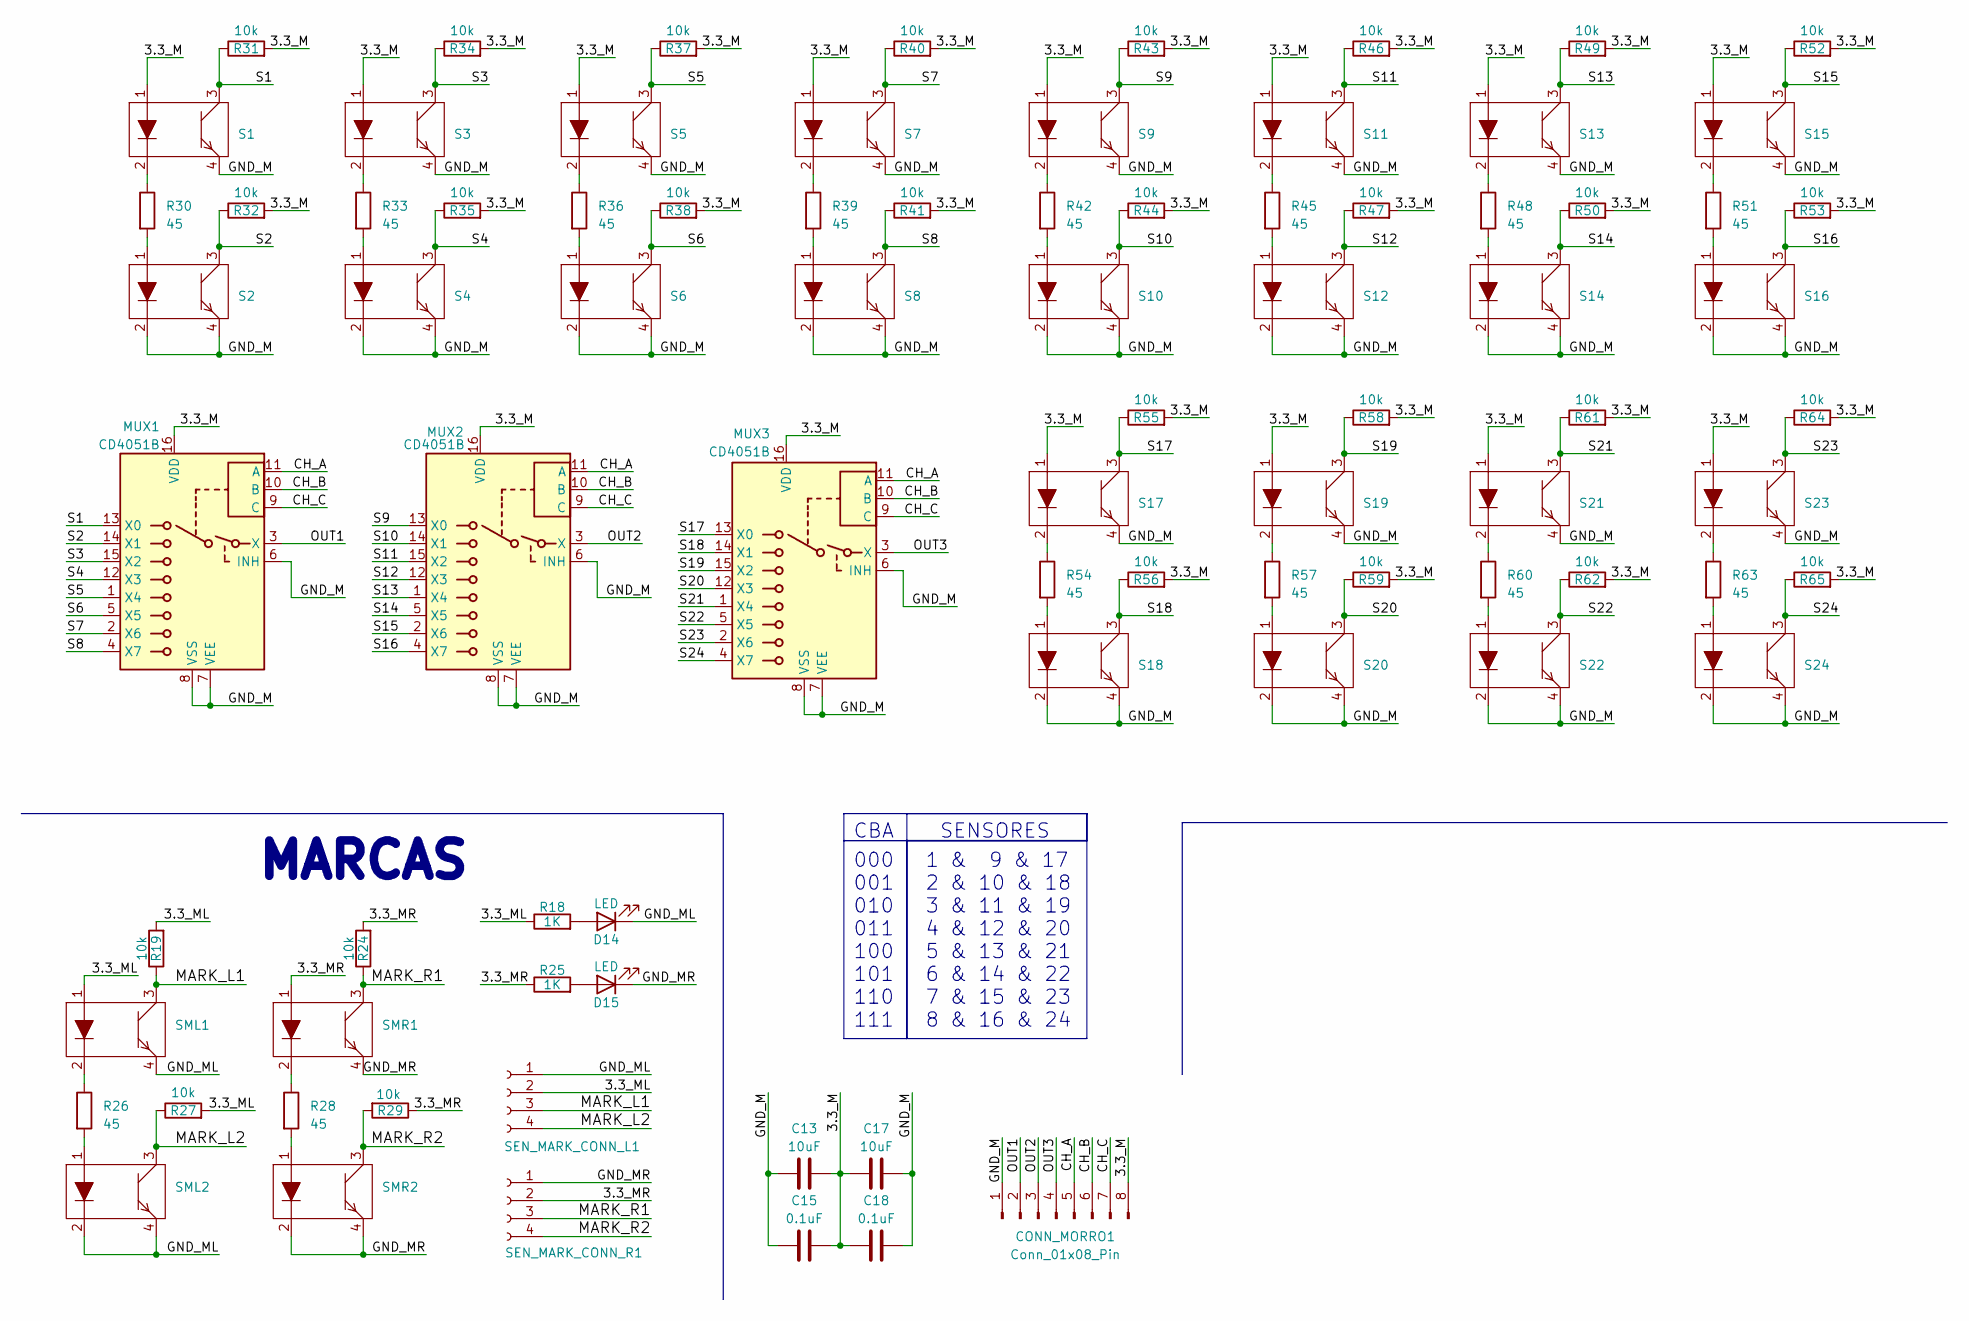
[picture p7: schematic Sensores.kicad_sch]

Parts:
C13, C17: 10uF; C_0805_2012Metric_Pad1.18x1.45mm_HandSolder; LCSC Part # C380331
C15, C18: 0.1uF; C_0805_2012Metric_Pad1.18x1.45mm_HandSolder; LCSC Part # C2847428
CONN_MORRO1: Conn_01x08_Pin; DragonBot_pads_morro
D14, D15: LED; LED_0402_1005Metric_Pad0.77x0.64mm_HandSolder
MUX1, MUX2, MUX3: CD4051B; MUX_CD4051B; LCSC Part # C3007951
R18, R25: 1K; R_0402_1005Metric_Pad0.72x0.64mm_HandSolder
R19, R24, R27, R29, R31, R32, R34, R35, R37, R38, R40, R41, R43, R44, R46, R47, R49, R50, R52, R53, R55, R56, R58, R59, R61, R62, R64, R65: 10k; R_0402_1005Metric_Pad0.72x0.64mm_HandSolder; LCSC Part # C17414
R26, R28, R30, R33, R36, R39, R42, R45, R48, R51, R54, R57, R60, R63: 45; R_0402_1005Metric_Pad0.72x0.64mm_HandSolder; LCSC Part # C3017827
S1, S2, S3, S4, S5, S6, S7, S8, S9, S10, S11, S12, S13, S14, S15, S16, S17, S18, S19, S20, S21, S22, S23, S24: DragonBot2_QRE1113; LCSC Part # C81632
SEN_MARK_CONN_L1: Conn_01x04_Socket; DragonBot_pad_marcas
SEN_MARK_CONN_R1: Conn_01x04_Socket; DragonBot_pad_marcas
SML1, SML2: FujitoraBot2_QRE1113; LCSC Part # C81632
SMR1, SMR2: FujitoraBot2_QRE1113; LCSC Part # C81632

Connections:
/Sensores/3.3_MR: R24.2, R25.1, R29.1, SEN_MARK_CONN_R1.2, SMR1.1
/Sensores/CH_A: CONN_MORRO1.5, MUX1.11 (A), MUX2.11 (A), MUX3.11 (A)
/Sensores/CH_B: CONN_MORRO1.6, MUX1.10 (B), MUX2.10 (B), MUX3.10 (B)
/Sensores/CH_C: CONN_MORRO1.7, MUX1.9 (C), MUX2.9 (C), MUX3.9 (C)
/Sensores/GND_M: C13.2, C15.2, C17.1, C18.1, CONN_MORRO1.1, MUX1.6 (INH), MUX1.7 (VEE), MUX1.8 (VSS), MUX2.6 (INH), MUX2.7 (VEE), MUX2.8 (VSS), MUX3.6 (INH), MUX3.7 (VEE), MUX3.8 (VSS), S1.4, S2.2, S2.4, S3.4, S4.2, S4.4, S5.4, S6.2, S6.4, S7.4, S8.2, S8.4, S9.4, S10.2, S10.4, S11.4, S12.2, S12.4, S13.4, S14.2, S14.4, S15.4, S16.2, S16.4, S17.4, S18.2, S18.4, S19.4, S20.2, S20.4, S21.4, S22.2, S22.4, S23.4, S24.2, S24.4
/Sensores/GND_ML: D14.1 (K), SEN_MARK_CONN_L1.1, SML1.4, SML2.2, SML2.4
/Sensores/GND_MR: D15.1 (K), SEN_MARK_CONN_R1.1, SMR1.4, SMR2.2, SMR2.4
/Sensores/MARK_L1: R19.1, SEN_MARK_CONN_L1.3, SML1.3; also elsewhere on the board
/Sensores/MARK_L2: R27.1, SEN_MARK_CONN_L1.4, SML2.3
/Sensores/MARK_R1: R24.1, SEN_MARK_CONN_R1.3, SMR1.3
/Sensores/MARK_R2: R29.2, SEN_MARK_CONN_R1.4, SMR2.3; also elsewhere on the board
/Sensores/OUT1: CONN_MORRO1.2, MUX1.3 (X)
/Sensores/OUT2: CONN_MORRO1.3, MUX2.3 (X)
/Sensores/OUT3: CONN_MORRO1.4, MUX3.3 (X)
/Sensores/S1: MUX1.13 (X0), R31.1, S1.3
/Sensores/S2: MUX1.14 (X1), R32.1, S2.3
/Sensores/S3: MUX1.15 (X2), R34.1, S3.3
/Sensores/S4: MUX1.12 (X3), R35.1, S4.3
/Sensores/S5: MUX1.1 (X4), R37.1, S5.3
/Sensores/S6: MUX1.5 (X5), R38.1, S6.3
/Sensores/S7: MUX1.2 (X6), R40.1, S7.3
/Sensores/S8: MUX1.4 (X7), R41.1, S8.3
/Sensores/S9: MUX2.13 (X0), R43.1, S9.3
/Sensores/S10: MUX2.14 (X1), R44.1, S10.3
/Sensores/S11: MUX2.15 (X2), R46.1, S11.3
/Sensores/S12: MUX2.12 (X3), R47.1, S12.3
/Sensores/S13: MUX2.1 (X4), R49.1, S13.3
/Sensores/S14: MUX2.5 (X5), R50.1, S14.3
/Sensores/S15: MUX2.2 (X6), R52.1, S15.3
/Sensores/S16: MUX2.4 (X7), R53.1, S16.3
/Sensores/S17: MUX3.13 (X0), R55.1, S17.3
/Sensores/S18: MUX3.14 (X1), R56.1, S18.3
/Sensores/S19: MUX3.15 (X2), R58.1, S19.3
/Sensores/S20: MUX3.12 (X3), R59.1, S20.3
/Sensores/S21: MUX3.1 (X4), R61.1, S21.3
/Sensores/S22: MUX3.5 (X5), R62.1, S22.3
/Sensores/S23: MUX3.2 (X6), R64.1, S23.3
/Sensores/S24: MUX3.4 (X7), R65.1, S24.3
unnamed: D14.2 (A), R18.2
unnamed: D15.2 (A), R25.2
unnamed: R26.1, SML1.2
unnamed: R26.2, SML2.1
unnamed: R28.1, SMR1.2
unnamed: R28.2, SMR2.1
unnamed: R30.1, S1.2
unnamed: R30.2, S2.1
unnamed: R33.1, S3.2
unnamed: R33.2, S4.1
unnamed: R36.1, S5.2
unnamed: R36.2, S6.1
unnamed: R39.1, S7.2
unnamed: R39.2, S8.1
unnamed: R42.1, S9.2
unnamed: R42.2, S10.1
unnamed: R45.1, S11.2
unnamed: R45.2, S12.1
unnamed: R48.1, S13.2
unnamed: R48.2, S14.1
unnamed: R51.1, S15.2
unnamed: R51.2, S16.1
unnamed: R54.1, S17.2
unnamed: R54.2, S18.1
unnamed: R57.1, S19.2
unnamed: R57.2, S20.1
unnamed: R60.1, S21.2
unnamed: R60.2, S22.1
unnamed: R63.1, S23.2
unnamed: R63.2, S24.1

Notes on the sheet:
MARCAS
CBA
000 001 010 011 100 101 110 111
1 & 9 & 17 2 & 10 & 18 3 & 11 & 19 4 & 12 & 20 5 & 13 & 21 6 & 14 & 22 7 & 15 & 23 8 & 16 & 24
SENSORES

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
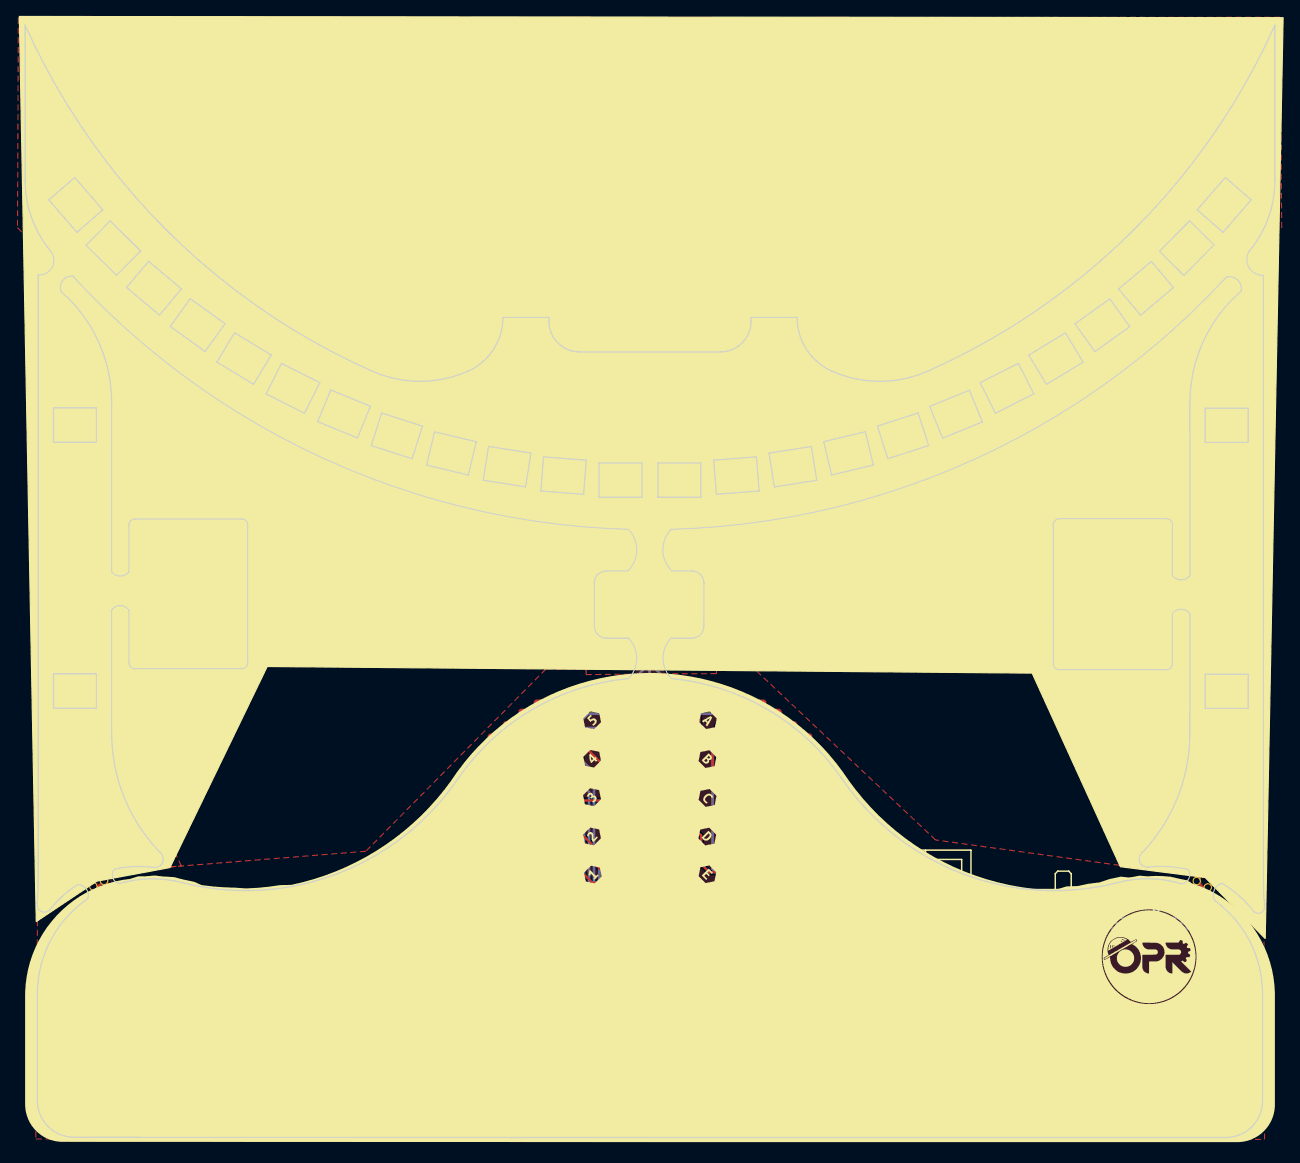
[picture p8: board main.kicad_pcb from above]

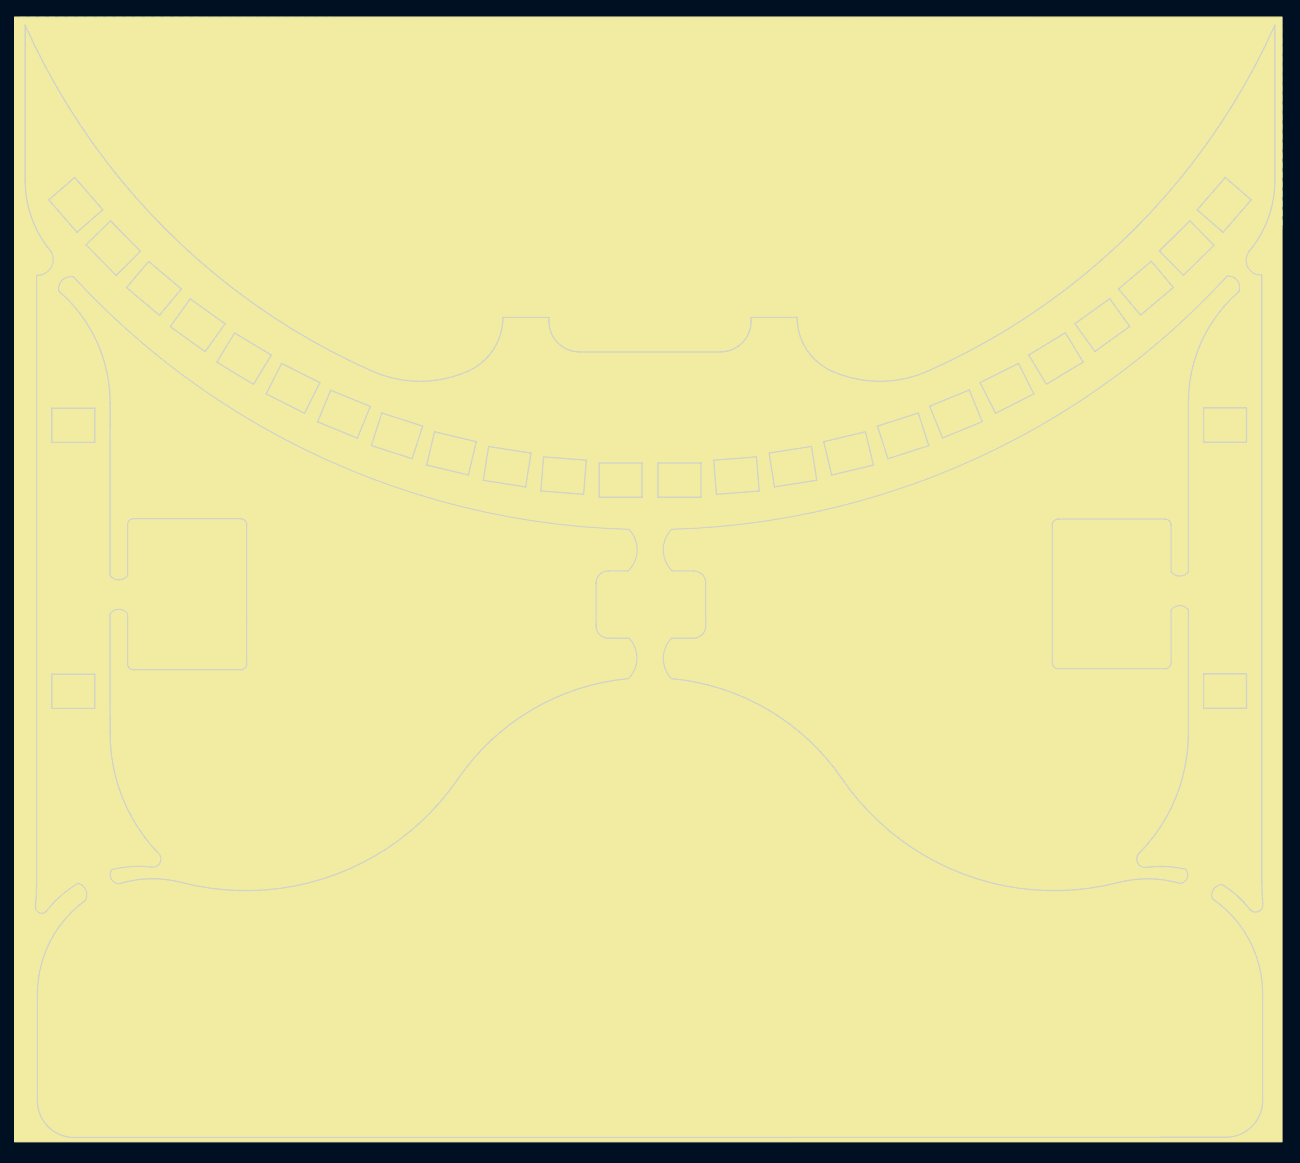
[picture p9: board main.kicad_pcb from below]

Board: 2 copper layers, 102.0 x 90.8 mm, 238 parts (68 on the bottom side), 182 nets.

Other parts of the board:
JP99: SolderJumper_2_Open; SolderJumper-2_P1.3mm_Open_RoundedPad1.0x1.5mm
