OPRobots/DragonBot2/pcb_files/kicad_project/chasis/chasis.kicad_pcb

## KiCad design pcb_files/kicad_project/chasis/chasis.kicad_pcb (2026-02-24)

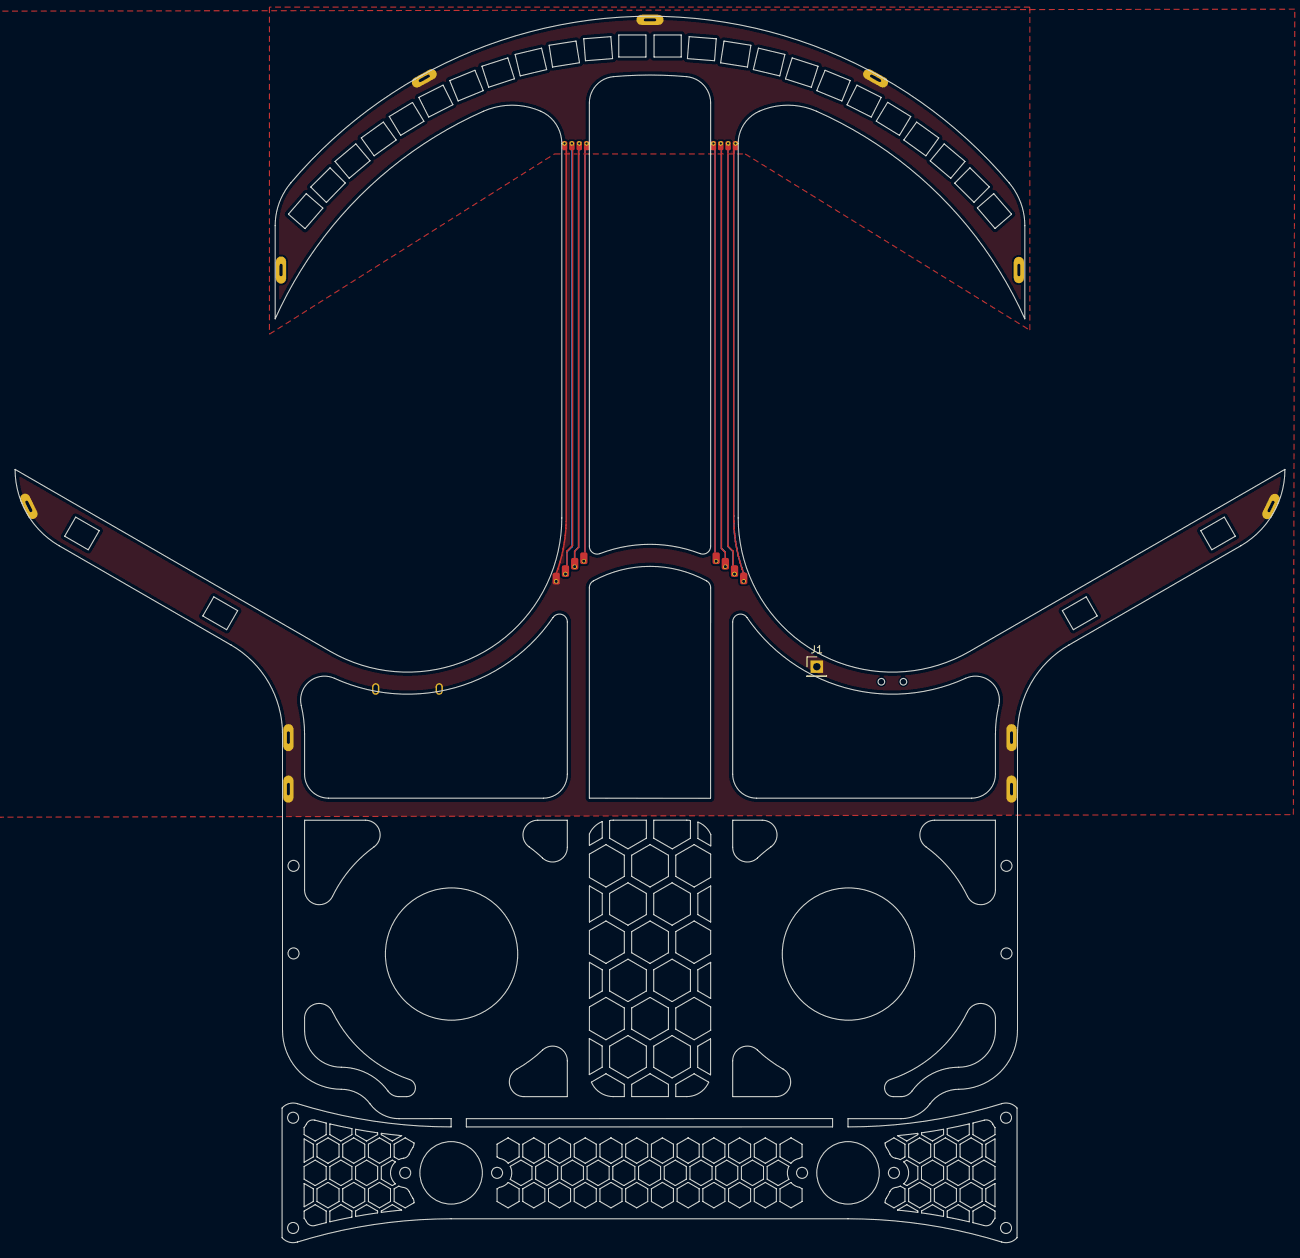
[picture p10: board chasis.kicad_pcb from above]

Board: 2 copper layers, 172.8 x 166.9 mm, 6 parts (1 on the bottom side), 8 nets.

Parts:
J1: Conn_01x01_Pin; PinHeader_1x01_P2.54mm_Vertical
J2: Conn_01x08_Pin; DragonBot_pads_main
J3: Conn_01x08_Pin; DragonBot_pads_morro
JP2: SolderJumper_2_Open; SolderJumper-2_P1.3mm_Open_RoundedPad1.0x1.5mm
POWER_SWITCH1: SW_DPDT_x2; Generic_Swich_ONOFF
USB1: USB-C ST-Link USART

Connections:
GND: J1.1, J2.1, J3.1, USB1.13 (SHIELD)
unnamed: J2.2, J3.2
unnamed: J2.3, J3.3
unnamed: J2.4, J3.4
unnamed: J2.5, J3.5
unnamed: J2.6, J3.6
unnamed: J2.7, J3.7
unnamed: J2.8, J3.8, JP2.1 (A)
