OPRobots/DragonBot2/source_code/include/config.h

#ifndef __CONFIG_H
#define __CONFIG_H

#include <stdint.h>
#include <stdio.h>

#include "eeprom.h"
#include "leds.h"
#include "sensors.h"

#define STM32_UID_BASE (0x1FFF7A10U)
#define UID_WORD0 MMIO32(STM32_UID_BASE + 0x0)
#define UID_WORD1 MMIO32(STM32_UID_BASE + 0x4)
#define UID_WORD2 MMIO32(STM32_UID_BASE + 0x8)

enum ROBOT_VERSION {
  DRAGONBOT2_UNKNOWN = 0,
  DRAGONBOT2_A = 1,
  DRAGONBOT2_B = 2,
  DRAGONBOT2_C = 3
};

#define MICROMETERS_PER_TICK 70.43493572812115
#define WHEELS_SEPARATION 119.7

/* Distancia patrón (mm) para la auto-calibración de la escala de rueda. El robot debe recorrerse exactamente esta distancia entre el reset y la confirmación. */
#define WHEEL_SCALE_CALIBRATION_MM 2000.0f

#define MAX_MOTOR_SATURATION_COUNT 30
#define MAX_MOTOR_ANGULAR_SATURATION_COUNT 60

#define KP_LINEAR 0.010
#define KI_LINEAR 0.0005
#define KD_LINEAR 0

#define KP_ANGULAR 0.6
#define KI_ANGULAR 0.015
#define KD_ANGULAR 0.0

#define KP_LINE_SENSORS 0.08
#define KI_LINE_SENSORS 0.00 // 0.002
#define KD_LINE_SENSORS 0.12

#define LINE_CALIBRATION_MS 5000
#define LINE_SENSOR_MAX_VALUE 4096
#define LINE_SENSOR_MIN_VALUE 0
#define SENSORS_ANALOG_MIN_PERCENT (20 / 100.0)
#define SENSORS_ANALOG_MAX_PERCENT (80 / 100.0)

#define VOLT_DIV_FACTOR_3S 3.865
#define VOLT_DIV_FACTOR_2S 3.15
#define BATTERY_2S_HIGH_LIMIT_VOLTAGE 8.4
#define BATTERY_2S_LOW_LIMIT_VOLTAGE 7.4
#define BATTERY_3S_HIGH_LIMIT_VOLTAGE 12.6
#define BATTERY_3S_LOW_LIMIT_VOLTAGE 11.1

// #define CONFIG_RUN_RACE 1
#define CONFIG_RUN_DEBUG 0

#define OFFTRACK_MS 150
#define START_MS_DELAY_RUN 5000
#define START_MS_DELAY_DEBUG 2000

void handle_robot_version(void);
void set_all_configs(void);
uint16_t get_config_run(void);

uint16_t get_offtrack_time(void);
uint16_t get_start_millis(void);

#define WHEEL_SCALE_DATA_LENGTH 1
#define WHEELS_SEPARATION_DATA_LENGTH 1

float get_micrometers_per_tick(void);
float get_wheels_separation(void);
void config_set_micrometers_per_tick(float value);
void config_set_wheels_separation(float value);
void config_load_eeprom(void);

#endif
