OPRobots/DragonBot2/source_code/include/constants.h

#ifndef __CONSTANTS_H
#define __CONSTANTS_H

/** Constantes matemáticas */
#define PI 3.1415
#define MICROMETERS_PER_MILLIMETER 1000
#define MILLIMETERS_PER_METER 1000
#define MICROSECONDS_PER_SECOND 1000000

/** Constantes del STM32F4 */
#define SYSCLK_FREQUENCY_HZ 168000000
#define CONTROL_FREQUENCY_HZ 1000
#define UPDATE_FREQUENCY_HZ 1000
#define LEDS_MAX_PWM 1049
#define MOTORS_MAX_PWM 1049
#define MOTORES_SATURATION_PWM 1000
#define MOTORES_SATURATION_ANGULAR_SPEED 50
#define ADC_RESOLUTION 4096
#define ADC_LSB (3.3 / ADC_RESOLUTION)

#endif
