OPRobots/DragonBot2/source_code/src/encoders.c

#include "encoders.h"

/*
 * Convención de odometría:
 *   +x  = avance del robot
 *   +y  = izquierda del robot
 *   theta = rumbo, positivo = giro a la izquierda (CCW), theta = +integral(omega_z dt)
 *
 * Este módulo aporta deltas de ticks, distancias y velocidades (angular
 * CCW-positiva). La pose (x/y/theta) y la fusión viven en odometry.c.
 */

/* Difference between the current count and the latest count */
static volatile int32_t left_diff_ticks;
static volatile int32_t right_diff_ticks;

/* Total number of counts */
static volatile int32_t left_total_ticks;
static volatile int32_t right_total_ticks;

/* Total travelled distance, in micrometers */
static volatile int32_t left_micrometers;
static volatile int32_t right_micrometers;
static volatile float avg_micrometers;

/* Total travelled distance, in millimeters */
static volatile int32_t left_millimeters;
static volatile int32_t right_millimeters;

/* Speed, in millimeters per second (CCW-positive angular speed) */
static volatile float left_speed;
static volatile float right_speed;
static volatile float angular_speed;

/**
 * @brief Read left motor encoder counter.
 */
static uint16_t read_encoder_left(void) {
  return (uint16_t)timer_get_counter(TIM3);
}

/**
 * @brief Read right motor encoder counter.
 */
static uint16_t read_encoder_right(void) {
  return (uint16_t)timer_get_counter(TIM4);
}

int32_t get_encoder_left_ticks(void) {
  return left_total_ticks;
}

int32_t get_encoder_right_ticks(void) {
  return right_total_ticks;
}

/**
 * @brief Read left motor encoder travelled distance in micrometers.
 */
int32_t get_encoder_left_micrometers(void) {
  return left_micrometers;
}

/**
 * @brief Read right motor encoder travelled distance in micrometers.
 */
int32_t get_encoder_right_micrometers(void) {
  return right_micrometers;
}

/**
 * @brief Read the average travelled distance in micrometers.
 */
int32_t get_encoder_avg_micrometers(void) {
  return (left_micrometers + right_micrometers) / 2;
}

/**
 * @brief Read left motor encoder travelled distance in millimeters.
 */
int32_t get_encoder_left_millimeters(void) {
  return left_millimeters;
}

/**
 * @brief Read right motor encoder travelled distance in millimeters.
 */
int32_t get_encoder_right_millimeters(void) {
  return right_millimeters;
}

/**
 * @brief Read the average travelled distance in millimeters.
 */
int32_t get_encoder_avg_millimeters(void) {
  return (left_millimeters + right_millimeters) / 2;
}

void reset_encoders(void) {
  left_total_ticks = 0;
  right_total_ticks = 0;
  left_diff_ticks = 0;
  right_diff_ticks = 0;
  left_micrometers = 0;
  right_micrometers = 0;
  avg_micrometers = 0;
  left_millimeters = 0;
  right_millimeters = 0;
  left_speed = 0;
  right_speed = 0;
  angular_speed = 0;
}

/**
 * @brief Read left motor speed in millimeters per second.
 */
float get_encoder_left_speed(void) {
  return left_speed;
}

/**
 * @brief Read right motor speed in millimeters per second.
 */
float get_encoder_right_speed(void) {
  return right_speed;
}

/**
 * @brief Read the average motor speed in millimeters per second.
 */
float get_encoder_avg_speed(void) {
  return (left_speed + right_speed) / 2.0f;
}

float get_encoder_angular_speed(void) {
  return angular_speed;
}

/**
 * @brief Incremento de ticks de la rueda izquierda desde la última lectura.
 */
int32_t get_encoder_left_diff_ticks(void) {
  return left_diff_ticks;
}

/**
 * @brief Incremento de ticks de la rueda derecha desde la última lectura.
 */
int32_t get_encoder_right_diff_ticks(void) {
  return right_diff_ticks;
}

/**
 * @brief Return the most likely counter difference.
 *
 * When reading an increasing or decreasing counter caution must be taken to:
 *
 * - Account for counter overflow.
 * - Account for counter direction (increasing or decreasing).
 *
 * This function assumes the most likely situation is to read the counter fast
 * enough to ensure that the direction is defined by the minimal difference
 * between the two reads (i.e.: readings are much faster than counter
 * overflows).
 *
 * @param[in] now Counter reading now.
 * @param[in] before Counter reading before.
 */
int32_t max_likelihood_counter_diff(uint16_t now, uint16_t before) {
  uint16_t forward_diff;
  uint16_t backward_diff;

  forward_diff = (uint16_t)(now - before);
  backward_diff = (uint16_t)(before - now);
  if (forward_diff > backward_diff)
    return -(int32_t)backward_diff;
  return (int32_t)forward_diff;
}

/**
 * @brief Update encoder readings.
 *
 * - Read raw encoder counters.
 * - Update the count differences (with respect to latest reading).
 * - Calculate distance travelled.
 * - Calculate speed.
 */
void update_encoder_readings(void) {
  static uint16_t last_left_ticks;
  static uint16_t last_right_ticks;

  uint16_t left_ticks;
  uint16_t right_ticks;

  left_ticks = read_encoder_left();
  right_ticks = read_encoder_right();
  left_diff_ticks = max_likelihood_counter_diff(left_ticks, last_left_ticks);
  right_diff_ticks = max_likelihood_counter_diff(right_ticks, last_right_ticks);
  left_total_ticks += left_diff_ticks;
  right_total_ticks += right_diff_ticks;

  left_micrometers = (int32_t)(left_total_ticks * get_micrometers_per_tick());
  right_micrometers = (int32_t)(right_total_ticks * get_micrometers_per_tick());
  left_millimeters = left_micrometers / MICROMETERS_PER_MILLIMETER;
  right_millimeters = right_micrometers / MICROMETERS_PER_MILLIMETER;

  float new_left_speed = left_diff_ticks * (get_micrometers_per_tick() / MICROMETERS_PER_MILLIMETER) * CONTROL_FREQUENCY_HZ;
  float new_right_speed = right_diff_ticks * (get_micrometers_per_tick() / MICROMETERS_PER_MILLIMETER) * CONTROL_FREQUENCY_HZ;
  left_speed = 0.2f * new_left_speed + (1 - 0.2f) * left_speed;
  right_speed = 0.2f * new_right_speed + (1 - 0.2f) * right_speed;

  /* Velocidad angular CCW-positiva: rueda derecha más rápida => giro a la izquierda. */
  angular_speed = (float)((right_speed - left_speed) / MILLIMETERS_PER_METER) / (get_wheels_separation() / (float)MILLIMETERS_PER_METER);

  last_left_ticks = left_ticks;
  last_right_ticks = right_ticks;
}
