OPRobots/DragonBot2/source_code/src/setup.c

#include "setup.h"

static enum RC5_TRIGGER rc5_trigger = RC5_TRIGGER_FALLING;

/**
 * @brief Configura los relojes principales del robot
 *
 * SYSCLK a 168 MHz
 * GPIO: A, B, C
 * USART3
 * Timers: 1-PWM, 2-PID, 8-OneShot125
 * ADC
 * DWT
 *
 */
static void setup_clock(void) {
  rcc_clock_setup_pll(&rcc_hse_8mhz_3v3[RCC_CLOCK_3V3_168MHZ]);

  rcc_periph_clock_enable(RCC_GPIOA);
  rcc_periph_clock_enable(RCC_GPIOB);
  rcc_periph_clock_enable(RCC_GPIOC);
  rcc_periph_clock_enable(RCC_GPIOD);

  rcc_periph_clock_enable(RCC_SYSCFG);

  rcc_periph_clock_enable(RCC_USART3);

  rcc_periph_clock_enable(RCC_SPI3);

  rcc_periph_clock_enable(RCC_DMA1);
  rcc_periph_clock_enable(RCC_DMA2);

  rcc_periph_clock_enable(RCC_TIM1);
  rcc_periph_clock_enable(RCC_TIM2);
  rcc_periph_clock_enable(RCC_TIM3);
  rcc_periph_clock_enable(RCC_TIM4);
  rcc_periph_clock_enable(RCC_TIM8);

  rcc_periph_clock_enable(RCC_ADC1);
  rcc_periph_clock_enable(RCC_ADC2);

  dwt_enable_cycle_counter();
}

static void setup_timer_priorities(void) {
  nvic_set_priority(NVIC_DMA2_STREAM0_IRQ, 16 * 1);
  nvic_set_priority(NVIC_DMA2_STREAM2_IRQ, 16 * 2);
  nvic_set_priority(NVIC_USART3_IRQ, 16 * 3);

  nvic_enable_irq(NVIC_DMA2_STREAM0_IRQ);
  nvic_enable_irq(NVIC_DMA2_STREAM2_IRQ);
  nvic_enable_irq(NVIC_USART3_IRQ);
  nvic_enable_irq(NVIC_EXTI15_10_IRQ);
}

static void setup_usart(void) {
  usart_set_baudrate(USART3, 115200);
  usart_set_databits(USART3, 8);
  usart_set_stopbits(USART3, USART_STOPBITS_1);
  usart_set_parity(USART3, USART_PARITY_NONE);
  usart_set_flow_control(USART3, USART_FLOWCONTROL_NONE);
  usart_set_mode(USART3, USART_MODE_TX_RX);
  // USART_CR1(USART3) |= USART_CR1_RXNEIE;
  // usart_enable_tx_interrupt(USART3);
  usart_enable(USART3);
}

static void setup_gpio(void) {

  // Entradas analógicas sensores de línea y batería
  gpio_mode_setup(GPIOC, GPIO_MODE_ANALOG, GPIO_PUPD_NONE, GPIO0 | GPIO1 | GPIO2 | GPIO3);
  // Entradas analógicas sensores de marcas y corriente
  gpio_mode_setup(GPIOA, GPIO_MODE_ANALOG, GPIO_PUPD_NONE, GPIO0 | GPIO1 | GPIO2 | GPIO3 | GPIO4 | GPIO5);

  // Entradas digitales botones
  gpio_mode_setup(GPIOA, GPIO_MODE_INPUT, GPIO_PUPD_PULLDOWN, GPIO6 | GPIO7);

  // Salidas digitales multiplexadores
  gpio_mode_setup(GPIOC, GPIO_MODE_OUTPUT, GPIO_PUPD_NONE, GPIO13 | GPIO14 | GPIO15);

  // Entradas Encoders
  gpio_mode_setup(GPIOB, GPIO_MODE_AF, GPIO_PUPD_NONE, GPIO4 | GPIO5 | GPIO6 | GPIO7);
  gpio_set_af(GPIOB, GPIO_AF2, GPIO4 | GPIO5 | GPIO6 | GPIO7);

  // Salida digital LED's Menu
  gpio_mode_setup(GPIOB, GPIO_MODE_OUTPUT, GPIO_PUPD_NONE, GPIO0 | GPIO1 | GPIO2 | GPIO3 | GPIO8 | GPIO9 | GPIO12 | GPIO13 | GPIO14);
  gpio_mode_setup(GPIOD, GPIO_MODE_OUTPUT, GPIO_PUPD_NONE, GPIO2);
  gpio_mode_setup(GPIOC, GPIO_MODE_OUTPUT, GPIO_PUPD_NONE, GPIO5);

  // Salida PWM LEDS y Ventilador
  gpio_mode_setup(GPIOC, GPIO_MODE_AF, GPIO_PUPD_NONE, GPIO6 | GPIO7 | GPIO8 | GPIO9);
  gpio_set_af(GPIOC, GPIO_AF3, GPIO6 | GPIO7 | GPIO8 | GPIO9);

  // Salida PWM Motores
  gpio_mode_setup(GPIOA, GPIO_MODE_AF, GPIO_PUPD_NONE, GPIO8 | GPIO9 | GPIO10 | GPIO11);
  gpio_set_af(GPIOA, GPIO_AF1, GPIO8 | GPIO9 | GPIO10 | GPIO11);

  // USART3
  gpio_mode_setup(GPIOB, GPIO_MODE_AF, GPIO_PUPD_NONE, GPIO10 | GPIO11);
  gpio_set_af(GPIOB, GPIO_AF7, GPIO10 | GPIO11);

  // MPU
  gpio_mode_setup(GPIOA, GPIO_MODE_OUTPUT, GPIO_PUPD_NONE, GPIO15);
  gpio_set(GPIOA, GPIO15);

  // BMP
  gpio_mode_setup(GPIOB, GPIO_MODE_OUTPUT, GPIO_PUPD_NONE, GPIO15);
  gpio_set(GPIOB, GPIO15);

  // SRAM
  gpio_mode_setup(GPIOC, GPIO_MODE_OUTPUT, GPIO_PUPD_NONE, GPIO4);
  gpio_set(GPIOC, GPIO4);

  // SPI3
  gpio_mode_setup(GPIOC, GPIO_MODE_AF, GPIO_PUPD_PULLDOWN, GPIO10 | GPIO11 | GPIO12);
  gpio_set_af(GPIOC, GPIO_AF6, GPIO10 | GPIO11 | GPIO12);

  // IR 38kHz
  exti_select_source(EXTI12, GPIOA);
  rc5_trigger = RC5_TRIGGER_FALLING;
  exti_set_trigger(EXTI12, EXTI_TRIGGER_FALLING);
  exti_enable_request(EXTI12);
}

void exti15_10_isr(void) {
  exti_reset_request(EXTI12);
  rc5_register(rc5_trigger);
  switch (rc5_trigger) {
    case RC5_TRIGGER_FALLING:
      rc5_trigger = RC5_TRIGGER_RISING;
      exti_set_trigger(EXTI12, EXTI_TRIGGER_RISING);
      break;
    case RC5_TRIGGER_RISING:
      rc5_trigger = RC5_TRIGGER_FALLING;
      exti_set_trigger(EXTI12, EXTI_TRIGGER_FALLING);
      break;
  }
}

static void setup_adc1(void) {
  adc_power_off(ADC1);
  adc_disable_external_trigger_regular(ADC1);
  adc_set_resolution(ADC1, ADC_CR1_RES_12BIT);
  adc_set_right_aligned(ADC1);
  // adc_set_clk_prescale(ADC_CCR_ADCPRE_BY2);
  adc_set_sample_time_on_all_channels(ADC1, ADC_SMPR_SMP_15CYC);
  adc_enable_scan_mode(ADC1);

  adc_set_regular_sequence(ADC1, get_adc1_channel_count(), get_adc1_channels());
  adc_set_continuous_conversion_mode(ADC1);
  adc_enable_eoc_interrupt(ADC1);

  adc_power_on(ADC1);
  int i;
  for (i = 0; i < 800000; i++) {
    /* Wait a bit. */
    __asm__("nop");
  }

  adc_start_conversion_regular(ADC1);
}

static void setup_dma_adc1(void) {
  rcc_peripheral_enable_clock(&RCC_APB2ENR, RCC_APB2ENR_ADC1EN);
  rcc_peripheral_enable_clock(&RCC_AHB1ENR, RCC_AHB1ENR_DMA2EN);
  dma_stream_reset(DMA2, DMA_STREAM0);

  dma_set_peripheral_address(DMA2, DMA_STREAM0, (uint32_t)&ADC_DR(ADC1));
  dma_set_memory_address(DMA2, DMA_STREAM0, (uint32_t)get_adc1_raw());
  dma_enable_memory_increment_mode(DMA2, DMA_STREAM0);
  dma_set_peripheral_size(DMA2, DMA_STREAM0, DMA_SxCR_PSIZE_16BIT);
  dma_set_memory_size(DMA2, DMA_STREAM0, DMA_SxCR_MSIZE_16BIT);
  dma_set_priority(DMA2, DMA_STREAM0, DMA_SxCR_PL_LOW);

  dma_enable_transfer_complete_interrupt(DMA2, DMA_STREAM0);
  // dma_enable_half_transfer_interrupt(DMA2, DMA_STREAM0);
  dma_set_number_of_data(DMA2, DMA_STREAM0, get_adc1_channel_count());
  dma_enable_circular_mode(DMA2, DMA_STREAM0);
  dma_set_transfer_mode(DMA2, DMA_STREAM0, DMA_SxCR_DIR_PERIPHERAL_TO_MEM);
  dma_channel_select(DMA2, DMA_STREAM0, DMA_SxCR_CHSEL_0);

  dma_enable_stream(DMA2, DMA_STREAM0);
  adc_enable_dma(ADC1);
  adc_set_dma_continue(ADC1);
}

void dma2_stream0_isr(void) {
  if (dma_get_interrupt_flag(DMA2, DMA_STREAM0, DMA_TCIF)) {
    line_sensors_update_mux_readings();
    dma_clear_interrupt_flags(DMA2, DMA_STREAM0, DMA_TCIF);
  }
}

/**
 * @brief Configura el ADC2 para lectura del sensor de batería
 *
 */
static void setup_adc2(void) {
  adc_power_off(ADC2);
  adc_disable_external_trigger_regular(ADC2);
  adc_set_resolution(ADC2, ADC_CR1_RES_12BIT);
  adc_set_right_aligned(ADC2);
  // adc_set_clk_prescale(ADC_CCR_ADCPRE_BY2);
  adc_set_sample_time_on_all_channels(ADC2, ADC_SMPR_SMP_15CYC);
  adc_enable_scan_mode(ADC2);

  adc_set_regular_sequence(ADC2, get_adc2_channel_count(), get_adc2_channels());
  adc_set_continuous_conversion_mode(ADC2);
  adc_enable_eoc_interrupt(ADC2);

  adc_power_on(ADC2);
  int i;
  for (i = 0; i < 800000; i++) {
    /* Wait a bit. */
    __asm__("nop");
  }

  adc_start_conversion_regular(ADC2);
}

static void setup_dma_adc2(void) {
  rcc_peripheral_enable_clock(&RCC_APB2ENR, RCC_APB2ENR_ADC2EN);
  rcc_peripheral_enable_clock(&RCC_AHB1ENR, RCC_AHB1ENR_DMA2EN);
  dma_stream_reset(DMA2, DMA_STREAM2);

  dma_set_peripheral_address(DMA2, DMA_STREAM2, (uint32_t)&ADC_DR(ADC2));
  dma_set_memory_address(DMA2, DMA_STREAM2, (uint32_t)get_adc2_raw());
  dma_enable_memory_increment_mode(DMA2, DMA_STREAM2);
  dma_set_peripheral_size(DMA2, DMA_STREAM2, DMA_SxCR_PSIZE_16BIT);
  dma_set_memory_size(DMA2, DMA_STREAM2, DMA_SxCR_MSIZE_16BIT);
  dma_set_priority(DMA2, DMA_STREAM2, DMA_SxCR_PL_LOW);

  dma_enable_transfer_complete_interrupt(DMA2, DMA_STREAM2);
  // dma_enable_half_transfer_interrupt(DMA2, DMA_STREAM2);
  dma_set_number_of_data(DMA2, DMA_STREAM2, get_adc2_channel_count());
  dma_enable_circular_mode(DMA2, DMA_STREAM2);
  dma_set_transfer_mode(DMA2, DMA_STREAM2, DMA_SxCR_DIR_PERIPHERAL_TO_MEM);
  dma_channel_select(DMA2, DMA_STREAM2, DMA_SxCR_CHSEL_1);

  dma_enable_stream(DMA2, DMA_STREAM2);
  adc_enable_dma(ADC2);
  adc_set_dma_continue(ADC2);
}

void dma2_stream2_isr(void) {
  if (dma_get_interrupt_flag(DMA2, DMA_STREAM2, DMA_TCIF)) {
    volatile uint16_t *adc2_raw = get_adc2_raw();

    mark_sensors_update_readings(0, adc2_raw[0]);
    mark_sensors_update_readings(1, adc2_raw[1]);
    mark_sensors_update_readings(2, adc2_raw[2]);
    mark_sensors_update_readings(3, adc2_raw[3]);
    motor_current_update_readings(0, adc2_raw[4]);
    motor_current_update_readings(1, adc2_raw[5]);
    battery_update_readings(adc2_raw[6]);

    dma_clear_interrupt_flags(DMA2, DMA_STREAM2, DMA_TCIF);
    // toggle_status_led();
  }
}

static void setup_leds_pwm(void) {
  timer_set_mode(TIM8, TIM_CR1_CKD_CK_INT, TIM_CR1_CMS_EDGE, TIM_CR1_DIR_UP);

  timer_set_prescaler(TIM8, ((rcc_apb2_frequency * 2) / 20000000 - 1)); // 20kHz
  timer_set_repetition_counter(TIM8, 0);
  timer_enable_preload(TIM8);
  timer_continuous_mode(TIM8);
  timer_set_period(TIM8, LEDS_MAX_PWM);

  timer_set_oc_mode(TIM8, TIM_OC1, TIM_OCM_PWM1);
  timer_set_oc_mode(TIM8, TIM_OC2, TIM_OCM_PWM1);
  timer_set_oc_mode(TIM8, TIM_OC3, TIM_OCM_PWM1);
  timer_set_oc_mode(TIM8, TIM_OC4, TIM_OCM_PWM1);
  timer_set_oc_value(TIM8, TIM_OC1, 0);
  timer_set_oc_value(TIM8, TIM_OC2, 0);
  timer_set_oc_value(TIM8, TIM_OC3, 0);
  timer_set_oc_value(TIM8, TIM_OC4, 0);
  timer_enable_oc_output(TIM8, TIM_OC1);
  timer_enable_oc_output(TIM8, TIM_OC2);
  timer_enable_oc_output(TIM8, TIM_OC3);
  timer_enable_oc_output(TIM8, TIM_OC4);

  timer_enable_break_main_output(TIM8);

  timer_enable_counter(TIM8);
}

static void setup_motors_pwm(void) {
  timer_set_mode(TIM1, TIM_CR1_CKD_CK_INT, TIM_CR1_CMS_EDGE, TIM_CR1_DIR_UP);

  timer_set_prescaler(TIM1, ((rcc_apb2_frequency * 2) / 20000000 - 1)); // 20kHz
  timer_set_repetition_counter(TIM1, 0);
  timer_enable_preload(TIM1);
  timer_continuous_mode(TIM1);
  timer_set_period(TIM1, MOTORS_MAX_PWM);

  timer_set_oc_mode(TIM1, TIM_OC1, TIM_OCM_PWM1);
  timer_set_oc_mode(TIM1, TIM_OC2, TIM_OCM_PWM1);
  timer_set_oc_mode(TIM1, TIM_OC3, TIM_OCM_PWM1);
  timer_set_oc_mode(TIM1, TIM_OC4, TIM_OCM_PWM1);
  timer_set_oc_value(TIM1, TIM_OC1, 0);
  timer_set_oc_value(TIM1, TIM_OC2, 0);
  timer_set_oc_value(TIM1, TIM_OC3, 0);
  timer_set_oc_value(TIM1, TIM_OC4, 0);
  timer_enable_oc_output(TIM1, TIM_OC1);
  timer_enable_oc_output(TIM1, TIM_OC2);
  timer_enable_oc_output(TIM1, TIM_OC3);
  timer_enable_oc_output(TIM1, TIM_OC4);

  timer_enable_break_main_output(TIM1);

  timer_enable_counter(TIM1);
}

static void setup_quadrature_encoders(void) {
  timer_set_period(TIM4, 0xFFFF);
  timer_slave_set_mode(TIM4, TIM_SMCR_SMS_EM3);
  timer_ic_set_input(TIM4, TIM_IC2, TIM_IC_IN_TI1);
  timer_ic_set_input(TIM4, TIM_IC1, TIM_IC_IN_TI2);
  timer_enable_counter(TIM4);

  timer_set_period(TIM3, 0xFFFF);
  timer_slave_set_mode(TIM3, TIM_SMCR_SMS_EM3);
  timer_ic_set_input(TIM3, TIM_IC2, TIM_IC_IN_TI1);
  timer_ic_set_input(TIM3, TIM_IC1, TIM_IC_IN_TI2);
  timer_enable_counter(TIM3);
}

/**
 * @brief Setup SPI.
 *
 * SPI is configured as follows:
 *
 * - Master mode.
 * - Clock baud rate: PCLK1 / speed_div; PCLK1 = 36MHz.
 * - Clock polarity: 0 (idle low; leading edge is a rising edge).
 * - Clock phase: 0 (out changes on the trailing edge and input data
 *   captured on rising edge).
 * - Data frame format: 8-bits.
 * - Frame format: MSB first.
 *
 * NSS is configured to be managed by software.
 *
 * Reference: https://github.com/Bulebots/meiga
 */
static void setup_spi(uint8_t speed_div) {
  spi_disable(SPI3);

  spi_init_master(SPI3, speed_div, SPI_CR1_CPOL_CLK_TO_0_WHEN_IDLE, SPI_CR1_CPHA_CLK_TRANSITION_1, SPI_CR1_DFF_8BIT, SPI_CR1_MSBFIRST);

  spi_enable_software_slave_management(SPI3);
  spi_set_nss_high(SPI3);

  spi_enable(SPI3);
}

static void setup_mpu(void) {
  setup_spi_high_speed();
  lsm6dsr_init();
}

static void setup_sram(void) {
  setup_spi_high_speed();
  sram_init();
}

/**
 * @brief Setup SPI for gyroscope read, less than 20 MHz.
 *
 * The clock baudrate is 84 MHz / 8 = 10.5 MHz.
 *
 * Reference: https://github.com/Bulebots/meiga
 */
void setup_spi_high_speed(void) {
  setup_spi(SPI_CR1_BAUDRATE_FPCLK_DIV_2);
  delay(100);
}

/**
 * @brief Setup SPI a velocidad lenta para el BMP280 (máx. 10 MHz).
 *
 * SPI3 cuelga de APB1 (42 MHz), por lo que DIV_8 da 5.25 MHz.
 *
 * Reference: https://github.com/Bulebots/meiga
 */
void setup_spi_low_speed(void) {
  setup_spi(SPI_CR1_BAUDRATE_FPCLK_DIV_8);
  delay(100);
}

#define SPI_CR1_BR_MASK (0x07u << 3)

/**
 * @brief Cambia el prescaler del SPI3 en caliente, sin resetear el periférico.
 *
 * El bitrate se configura con el SPI deshabilitado (SPE=0), como pide el
 * manual. Pensado para conmutar BMP280 <-> MPU/SRAM dentro de su slot.
 */
static void spi_set_baudrate(uint8_t speed_div) {
  spi_disable(SPI3);
  SPI_CR1(SPI3) = (SPI_CR1(SPI3) & ~SPI_CR1_BR_MASK) | speed_div;
  spi_enable(SPI3);
}

void spi_set_baudrate_fast(void) {
  spi_set_baudrate(SPI_CR1_BAUDRATE_FPCLK_DIV_2);
}

void spi_set_baudrate_slow(void) {
  spi_set_baudrate(SPI_CR1_BAUDRATE_FPCLK_DIV_8);
}

void setup(void) {
  setup_kinematics();
  setup_clock();
  setup_timer_priorities();
  setup_usart();
  setup_gpio();
  setup_dma_adc2();
  setup_adc2();
  setup_dma_adc1();
  setup_adc1();
  setup_leds_pwm();
  setup_motors_pwm();
  setup_quadrature_encoders();
  sys_tick_init();
  setup_mpu();
  setup_sram();
  odometry_init();
}
