OPRobots/DragonBot2/source_code/src/leds.c

#include <leds.h>

static uint32_t rainbow_last_ms = 0;
static uint32_t rainbow_rgb[3] = {LEDS_MAX_PWM, 0, 0};
static int16_t rainbow_color_desc = 0;
static int16_t rainbow_color_asc = 1;

static uint32_t rgb_while_ms = 0;

static uint32_t warning_last_ms = 0;

static uint32_t rgb_last_blink_ms = 0;
static bool rgb_blink_state = false;

static uint32_t leds_mpu_last_ms = 0;
static int8_t leds_mpu_current_step = 1;
static uint8_t leds_mpu_current_index = 0;

static uint32_t leds_sensors_last_ms = 0;
static int8_t leds_sensors_current_step = 1;
static uint8_t leds_sensors_current_index = 0;

static uint32_t leds_wheels_separation_last_ms = 0;
static bool leds_wheels_separation_blink_state = false;

static uint32_t leds_wheel_scale_last_ms = 0;
static int8_t leds_wheel_scale_current_index = 0;

static uint32_t blink_last_ms = 0;

static uint32_t battery_warning_last_ms = 0;

void set_status_led(bool state) {
  if (state) {
    gpio_set(GPIOC, GPIO5);
  } else {
    gpio_clear(GPIOC, GPIO5);
  }
}

void toggle_status_led(void) {
  gpio_toggle(GPIOC, GPIO5);
}

void warning_status_led(uint32_t ms) {
  if (get_clock_ticks() > warning_last_ms + ms) {
    toggle_status_led();
    warning_last_ms = get_clock_ticks();
  }
}

bool is_status_led_on(void) {
  return gpio_get(GPIOC, GPIO5);
}

void set_RGB_color(uint32_t r, uint32_t g, uint32_t b) {
  timer_set_oc_value(TIM8, TIM_OC3, r);
  timer_set_oc_value(TIM8, TIM_OC4, b);
  timer_set_oc_value(TIM8, TIM_OC2, g);
  rgb_while_ms = 0;
}

void set_RGB_color_while(uint32_t r, uint32_t g, uint32_t b, uint32_t ms) {
  set_RGB_color(r, g, b);
  rgb_while_ms = get_clock_ticks() + ms;
}

void blink_RGB_color(uint32_t r, uint32_t g, uint32_t b, uint32_t ms) {
  if (get_clock_ticks() > rgb_last_blink_ms + ms) {
    rgb_blink_state = !rgb_blink_state;
    if (rgb_blink_state) {
      set_RGB_color(0, 0, 0);
    } else {
      set_RGB_color(r, g, b);
    }
    rgb_last_blink_ms = get_clock_ticks();
  }
}

void check_leds_while(void) {
  if (rgb_while_ms > 0 && get_clock_ticks() > rgb_while_ms) {
    set_RGB_color(0, 0, 0);
    rgb_while_ms = 0;
  }
}

void set_RGB_rainbow(void) {
  if (get_clock_ticks() > rainbow_last_ms + 40) {
    rainbow_last_ms = get_clock_ticks();
    rainbow_rgb[rainbow_color_desc] -= 20;
    rainbow_rgb[rainbow_color_asc] += 20;
    set_RGB_color(rainbow_rgb[0], rainbow_rgb[1], rainbow_rgb[2]);
    if (rainbow_rgb[rainbow_color_desc] <= 0 || rainbow_rgb[rainbow_color_asc] >= LEDS_MAX_PWM / 4) {
      rainbow_rgb[rainbow_color_desc] = 0;
      rainbow_rgb[rainbow_color_asc] = LEDS_MAX_PWM / 4;
      set_RGB_color(rainbow_rgb[0], rainbow_rgb[1], rainbow_rgb[2]);
      rainbow_color_desc++;
      if (rainbow_color_desc > 2) {
        rainbow_color_desc = 0;
      }
      rainbow_color_asc = rainbow_color_desc == 2 ? 0 : rainbow_color_desc + 1;
    }
  }
}

void set_leds_mpu(uint16_t ms) {
  if (get_clock_ticks() > leds_mpu_last_ms + ms) {
    gpio_clear(GPIOB, GPIO0 | GPIO1 | GPIO2 | GPIO3 | GPIO8 | GPIO9 | GPIO12 | GPIO13 | GPIO14);
    gpio_clear(GPIOD, GPIO2);

    switch (leds_mpu_current_index) {
      case 0:
        set_info_led(INFO_LED_3, true);
        set_info_led(INFO_LED_C, true);
        break;
      case 1:
        set_info_led(INFO_LED_4, true);
        set_info_led(INFO_LED_2, true);
        set_info_led(INFO_LED_D, true);
        set_info_led(INFO_LED_B, true);
        break;
      case 2:
        set_info_led(INFO_LED_5, true);
        set_info_led(INFO_LED_1, true);
        set_info_led(INFO_LED_E, true);
        set_info_led(INFO_LED_A, true);
        break;
    }

    if (leds_mpu_current_index >= 2) {
      leds_mpu_current_step = -1;
    } else if (leds_mpu_current_index <= 0) {
      leds_mpu_current_step = 1;
    }

    leds_mpu_current_index += leds_mpu_current_step;
    leds_mpu_last_ms = get_clock_ticks();
  }
}

void set_leds_sensors(uint16_t ms) {
  if (get_clock_ticks() > leds_sensors_last_ms + ms) {
    gpio_clear(GPIOB, GPIO0 | GPIO1 | GPIO2 | GPIO3 | GPIO8 | GPIO9 | GPIO12 | GPIO13 | GPIO14);
    gpio_clear(GPIOD, GPIO2);

    switch (leds_sensors_current_index) {
      case 0:
        set_info_led(INFO_LED_5, true);
        set_info_led(INFO_LED_4, true);
        break;
      case 1:
        set_info_led(INFO_LED_4, true);
        set_info_led(INFO_LED_3, true);
        break;
      case 2:
        set_info_led(INFO_LED_3, true);
        set_info_led(INFO_LED_2, true);
        break;
      case 3:
        set_info_led(INFO_LED_2, true);
        set_info_led(INFO_LED_1, true);
        break;
      case 4:
        set_info_led(INFO_LED_1, true);
        set_info_led(INFO_LED_A, true);
        break;
      case 5:
        set_info_led(INFO_LED_A, true);
        set_info_led(INFO_LED_B, true);
        break;
      case 6:
        set_info_led(INFO_LED_B, true);
        set_info_led(INFO_LED_C, true);
        break;
      case 7:
        set_info_led(INFO_LED_C, true);
        set_info_led(INFO_LED_D, true);
        break;
      case 8:
        set_info_led(INFO_LED_D, true);
        set_info_led(INFO_LED_E, true);
        break;
    }

    if (leds_sensors_current_index >= 8) {
      leds_sensors_current_step = -1;
    } else if (leds_sensors_current_index <= 0) {
      leds_sensors_current_step = 1;
    }

    leds_sensors_current_index += leds_sensors_current_step;
    leds_sensors_last_ms = get_clock_ticks();
  }
}

void set_leds_wheel_separation(uint16_t ms) {
  if (get_clock_ticks() > leds_wheels_separation_last_ms + ms) {
    set_info_led(INFO_LED_1, leds_wheels_separation_blink_state);
    set_info_led(INFO_LED_2, leds_wheels_separation_blink_state);
    set_info_led(INFO_LED_3, false);
    set_info_led(INFO_LED_4, leds_wheels_separation_blink_state);
    set_info_led(INFO_LED_5, leds_wheels_separation_blink_state);
    set_info_led(INFO_LED_A, leds_wheels_separation_blink_state);
    set_info_led(INFO_LED_B, leds_wheels_separation_blink_state);
    set_info_led(INFO_LED_C, false);
    set_info_led(INFO_LED_D, leds_wheels_separation_blink_state);
    set_info_led(INFO_LED_E, leds_wheels_separation_blink_state);

    leds_wheels_separation_blink_state = !leds_wheels_separation_blink_state;
    leds_wheels_separation_last_ms = get_clock_ticks();
  }
}

void set_leds_wheel_scale(uint16_t ms) {
  if (get_clock_ticks() > leds_wheel_scale_last_ms + ms) {
    set_info_led(INFO_LED_4, true);
    set_info_led(INFO_LED_5, true);
    set_info_led(INFO_LED_D, true);
    set_info_led(INFO_LED_E, true);

    set_info_led(INFO_LED_3, leds_wheel_scale_current_index == 0);
    set_info_led(INFO_LED_2, leds_wheel_scale_current_index == 1);
    set_info_led(INFO_LED_1, leds_wheel_scale_current_index == 2);
    set_info_led(INFO_LED_C, leds_wheel_scale_current_index == 0);
    set_info_led(INFO_LED_B, leds_wheel_scale_current_index == 1);
    set_info_led(INFO_LED_A, leds_wheel_scale_current_index == 2);

    leds_wheel_scale_current_index = (leds_wheel_scale_current_index + 1) % 3;
    leds_wheel_scale_last_ms = get_clock_ticks();
  }
}

void set_leds_blink(uint16_t ms) {
  if (get_clock_ticks() > blink_last_ms + ms) {
    gpio_toggle(GPIOB, GPIO0 | GPIO1 | GPIO2 | GPIO3 | GPIO8 | GPIO9 | GPIO12 | GPIO13 | GPIO14);
    gpio_toggle(GPIOD, GPIO2);
    blink_last_ms = get_clock_ticks();
  }
}

void set_leds_battery_level(float battery_level) {
  if (battery_level <= 10) {
    gpio_clear(GPIOB, GPIO1 | GPIO2 | GPIO3 | GPIO8 | GPIO9 | GPIO12 | GPIO13);
    gpio_clear(GPIOD, GPIO2);
    if (get_clock_ticks() > battery_warning_last_ms + 50) {

      gpio_toggle(GPIOB, GPIO14 | GPIO0);

      battery_warning_last_ms = get_clock_ticks();
    }

  } else if (battery_level <= 26) {
    gpio_clear(GPIOB, GPIO1 | GPIO2 | GPIO3 | GPIO8 | GPIO9 | GPIO12 | GPIO13);
    gpio_clear(GPIOD, GPIO2);

    gpio_set(GPIOB, GPIO14 | GPIO0);

  } else if (battery_level <= 42) {
    gpio_clear(GPIOB, GPIO2 | GPIO3 | GPIO8 | GPIO9 | GPIO12 | GPIO13);

    gpio_set(GPIOB, GPIO14 | GPIO0 | GPIO1);
    gpio_set(GPIOD, GPIO2);

  } else if (battery_level <= 58) {
    gpio_clear(GPIOB, GPIO8 | GPIO9 | GPIO12 | GPIO13);

    gpio_set(GPIOB, GPIO14 | GPIO0 | GPIO1 | GPIO2 | GPIO3);
    gpio_set(GPIOD, GPIO2);

  } else if (battery_level <= 74) {
    gpio_clear(GPIOB, GPIO9 | GPIO13);

    gpio_set(GPIOB, GPIO14 | GPIO0 | GPIO1 | GPIO2 | GPIO3 | GPIO8 | GPIO12);
    gpio_set(GPIOD, GPIO2);
  } else if (battery_level <= 90) {
    gpio_set(GPIOB, GPIO14 | GPIO0 | GPIO1 | GPIO2 | GPIO3 | GPIO8 | GPIO12 | GPIO9 | GPIO13);
    gpio_set(GPIOD, GPIO2);
  } else {
    if (get_clock_ticks() > battery_warning_last_ms + 50) {
      gpio_toggle(GPIOB, GPIO0 | GPIO1 | GPIO2 | GPIO3 | GPIO8 | GPIO9 | GPIO12 | GPIO13 | GPIO14);
      gpio_toggle(GPIOD, GPIO2);

      battery_warning_last_ms = get_clock_ticks();
    }
  }
}

void all_leds_clear(void) {
  set_RGB_color(0, 0, 0);
  set_status_led(false);

  gpio_clear(GPIOB, GPIO0 | GPIO1 | GPIO2 | GPIO3 | GPIO8 | GPIO9 | GPIO12 | GPIO13 | GPIO14);
  gpio_clear(GPIOD, GPIO2);
}

void set_info_led(enum info_led index, bool state) {
  switch (index) {
    case INFO_LED_1:
      if (state) {
        gpio_set(GPIOB, GPIO14);
      } else {
        gpio_clear(GPIOB, GPIO14);
      }
      break;
    case INFO_LED_2:
      if (state) {
        gpio_set(GPIOD, GPIO2);
      } else {
        gpio_clear(GPIOD, GPIO2);
      }
      break;
    case INFO_LED_3:
      if (state) {
        gpio_set(GPIOB, GPIO3);
      } else {
        gpio_clear(GPIOB, GPIO3);
      }
      break;
    case INFO_LED_4:
      if (state) {
        gpio_set(GPIOB, GPIO8);
      } else {
        gpio_clear(GPIOB, GPIO8);
      }
      break;
    case INFO_LED_5:
      if (state) {
        gpio_set(GPIOB, GPIO9);
      } else {
        gpio_clear(GPIOB, GPIO9);
      }
      break;
    case INFO_LED_A:
      if (state) {
        gpio_set(GPIOB, GPIO0);
      } else {
        gpio_clear(GPIOB, GPIO0);
      }
      break;
    case INFO_LED_B:
      if (state) {
        gpio_set(GPIOB, GPIO1);
      } else {
        gpio_clear(GPIOB, GPIO1);
      }
      break;
    case INFO_LED_C:
      if (state) {
        gpio_set(GPIOB, GPIO2);
      } else {
        gpio_clear(GPIOB, GPIO2);
      }
      break;
    case INFO_LED_D:
      if (state) {
        gpio_set(GPIOB, GPIO12);
      } else {
        gpio_clear(GPIOB, GPIO12);
      }
      break;
    case INFO_LED_E:
      if (state) {
        gpio_set(GPIOB, GPIO13);
      } else {
        gpio_clear(GPIOB, GPIO13);
      }
      break;
  }
}

void set_info_leds(void) {
  gpio_set(GPIOB, GPIO0 | GPIO1 | GPIO2 | GPIO3 | GPIO8 | GPIO9 | GPIO12 | GPIO13 | GPIO14);
  gpio_set(GPIOD, GPIO2);
}

void show_robot_version(uint16_t version) {
  clear_info_leds();
  switch (version) {
    case DRAGONBOT2_A:
      printf("DragonBot2 A inited...\n");
      set_info_led(INFO_LED_A, true);
      delay(1000);
      break;
    case DRAGONBOT2_B:
      printf("DragonBot2 B inited...\n");
      set_info_led(INFO_LED_B, true);
      delay(1000);
      break;
    case DRAGONBOT2_C:
      printf("DragonBot2 C inited...\n");
      set_info_led(INFO_LED_C, true);
      delay(1000);
      break;
    default:
      printf("Robot version: Unknown\n");
      uint32_t ms = get_clock_ticks();
      while (get_clock_ticks() - ms < 1000) {
        set_leds_mpu(100);
        warning_status_led(100);
      }
      break;
  }
  all_leds_clear();
  delay(250);
}

void clear_info_leds(void) {
  gpio_clear(GPIOB, GPIO0 | GPIO1 | GPIO2 | GPIO3 | GPIO8 | GPIO9 | GPIO12 | GPIO13 | GPIO14);
  gpio_clear(GPIOD, GPIO2);
}
