OPRobots/DragonBot2/source_code/src/debug.c

#include <debug.h>

bool debug_enabled = false;
uint32_t debug_last_print_ms = 0;

static void debug_macroarray(void) {
  macroarray_print();
  debug_enabled = false;
  menu_config_reset_values();
}

/**
 * @brief Imprime los valores de los sensores sin aplicar ninguna corrección
 *
 */
static void debug_sensors_raw(void) {
  if (get_clock_ticks() > debug_last_print_ms + 50) {
    for (uint8_t sensor = 0; sensor < get_line_sensor_count(); sensor++) {
      printf("%4d ", get_line_sensor_raw(sensor));
    }
    printf("| ");
    for (uint8_t sensor = 0; sensor < get_mark_sensor_count(); sensor++) {
      printf("%4d ", get_mark_sensor_raw(sensor));
    }
    printf("\n");
    debug_last_print_ms = get_clock_ticks();
  }
}

static void debug_sensors_calibrated(void) {
  if (get_clock_ticks() > debug_last_print_ms + 50) {
    for (uint8_t sensor = 0; sensor < get_line_sensor_count(); sensor++) {
      printf("%4d ", get_line_sensor_calibrated(sensor));
    }
    printf("| ");
    for (uint8_t sensor = 0; sensor < get_mark_sensor_count(); sensor++) {
      printf("%4d ", get_mark_sensor_calibrated(sensor));
    }
    printf("\n");
    debug_last_print_ms = get_clock_ticks();
  }
}

static void debug_all_leds(void) {
  set_RGB_rainbow();
  warning_status_led(125);
  set_leds_mpu(50);
}

static void debug_posicion_correccion(void) {
  if (get_clock_ticks() > debug_last_print_ms + 50) {
    line_sensors_update_position();
    printf("%ld\n", get_line_sensor_position());
    debug_last_print_ms = get_clock_ticks();
  }
}

static void debug_line_position(void) {
  if (get_clock_ticks() > debug_last_print_ms + 50) {
    line_sensors_update_position();
    printf("%d\t%ld\t%d\n", -1200, get_line_sensor_position(), 1200);
    debug_last_print_ms = get_clock_ticks();
  }
}

static void debug_encoders(void) {
  if (get_clock_ticks() > debug_last_print_ms + 50) {
    printf("%ld (%ld)\t%ld (%ld)\n", get_encoder_left_ticks(), get_encoder_left_micrometers(), get_encoder_right_ticks(), get_encoder_right_micrometers());
    debug_last_print_ms = get_clock_ticks();
  }
}

/**
 * @brief Log en vivo del estado del EKF de odometría (banco, con cable).
 *
 * Imprime x, y, rumbo, velocidades (fusión + gyro + encoders), bias, slip, dt y
 * varianzas cada 50 ms para validar/ajustar sin volcar la SRAM.
 */
static void debug_odometry(void) {
  if (get_clock_ticks() > debug_last_print_ms + 50) {
    printf("x=%.1f y=%.1f th=%.2f v=%.1f w=%.3f gyro=%.3f encw=%.3f bias=%.4f slip=%d dt=%.4f vx=%.1f vy=%.1f vth=%.6f\n",
           odometry_get_x(), odometry_get_y(), odometry_get_theta_deg(), odometry_get_linear_speed(),
           odometry_get_angular_speed(), lsm6dsr_get_gyro_z_radps(), odometry_get_encoder_omega(),
           odometry_get_gyro_bias(), odometry_get_slip() ? 1 : 0, odometry_get_dt(),
           odometry_get_var_x(), odometry_get_var_y(), odometry_get_var_theta());
    debug_last_print_ms = get_clock_ticks();
  }
}

static void debug_motors(void) {
  set_motors_speed(150, 150);
  if (get_clock_ticks() > debug_last_print_ms + 50) {
    printf("L: %4d mA ", get_motor_current_raw(0));
    printf("R: %4d mA ", get_motor_current_raw(1));
    printf(" | ");
    printf("L: %5.2f m/s ", get_encoder_left_speed());
    printf("R: %5.2f m/s ", get_encoder_right_speed());
    printf("\n");
    debug_last_print_ms = get_clock_ticks();
  }
}

static void debug_fans(void) {
  set_fan_speed(5);
}

static void check_debug_active(void) {
  if (get_menu_select_btn()) {
    while (get_menu_select_btn()) {
    }
    debug_enabled = !debug_enabled;
    if (!debug_enabled) {
      menu_config_reset_values();
    }
    reset_encoders();
  }
}

bool is_debug_enabled(void) {
  return debug_enabled;
}

void debug_from_config(uint8_t type) {
  if (type != DEBUG_NONE) {
    check_debug_active();
  } else {
    debug_enabled = false;
  }
  if (debug_enabled) {
    set_RGB_color(0, 50, 0);
    switch (type) {
      case DEBUG_MACROARRAY:
        // debug_macroarray();
        sram_print_logs(SRAM_TYPE_CONTROL);
        debug_enabled = false;
        menu_config_reset_values();
        break;
      case DEBUG_TYPE_SENSORS_RAW:
        debug_sensors_raw();
        break;
      case DEBUG_TYPE_SENSORS_CALIBRATED:
        debug_sensors_calibrated();
        break;
      case DEBUG_TYPE_LINE_POSITION:
        debug_line_position();
        break;
      case DEBUG_TYPE_MOTORS:
        debug_motors();
        break;
      case DEBUG_TYPE_ENCODERS:
        debug_encoders();
        break;
      case DEBUG_TYPE_CORRECCION_POSICION:
        debug_posicion_correccion();
        break;
      case DEBUG_TYPE_LEDS_PARTY:
        debug_all_leds();
        break;
      case DEBUG_TYPE_FANS_DEMO:
        debug_fans();
        break;
      case DEBUG_TYPE_ODOMETRY:
        debug_odometry();
        break;
        // case DEBUG_TYPE_SRAM_TEST:
        //   sram_debug_overflow_test(40000u);
        //   sram_debug_validate();
        //   debug_enabled = false;
        //   menu_config_reset_values();
        //   break;
    }
  } else {
    set_RGB_color(0, 0, 0);
  }
}

void debug_from_main(uint8_t type) {
  debug_enabled = true;
  debug_from_config(type);
}
