OPRobots/DragonBot2/source_code/include/debug.h

#ifndef __DEBUG_H
#define __DEBUG_H

#include <stdint.h>

#include "config.h"
#include "constants.h"
#include "control.h"
#include "delay.h"
#include "encoders.h"
#include "macroarray.h"
#include "motors.h"
#include "odometry.h"
#include "sensors.h"
#include "sram.h"
#include "usart.h"


#define DEBUG_NONE 0
#define DEBUG_MACROARRAY 1
#define DEBUG_TYPE_SENSORS_RAW 2
#define DEBUG_TYPE_SENSORS_CALIBRATED 3
#define DEBUG_TYPE_LINE_POSITION 4
#define DEBUG_TYPE_MOTORS 5
#define DEBUG_TYPE_ENCODERS 6
#define DEBUG_TYPE_CORRECCION_POSICION 7
#define DEBUG_TYPE_LEDS_PARTY 8
#define DEBUG_TYPE_FANS_DEMO 9
#define DEBUG_TYPE_ODOMETRY 10
#define DEBUG_TYPE_SRAM_TEST 10

bool is_debug_enabled(void);
void debug_from_config(uint8_t type);
void debug_from_main(uint8_t type);

#endif
