OPRobots/DragonBot2/source_code/include/setup.h

#ifndef __SETUP_H
#define __SETUP_H

#include <libopencm3/cm3/dwt.h>
#include <libopencm3/cm3/nvic.h>
#include <libopencm3/cm3/systick.h>
#include <libopencm3/stm32/adc.h>
#include <libopencm3/stm32/dma.h>
#include <libopencm3/stm32/exti.h>
#include <libopencm3/stm32/gpio.h>
#include <libopencm3/stm32/rcc.h>
#include <libopencm3/stm32/spi.h>
#include <libopencm3/stm32/timer.h>
#include <libopencm3/stm32/usart.h>

#include "config.h"
#include "lsm6dsr.h"
#include "odometry.h"
#include "rc5.h"
#include "sensors.h"
#include "sram.h"
#include "sys_tick.h"
#include "usart.h"

void setup(void);
void setup_spi_high_speed(void);
void setup_spi_low_speed(void);
void spi_set_baudrate_fast(void);
void spi_set_baudrate_slow(void);

#endif
