OPRobots/DragonBot2/source_code/include/menu_run.h

#ifndef MENU_RUN_H
#define MENU_RUN_H

#include <delay.h>
#include <leds.h>
#include <stdbool.h>
#include <stdint.h>
#include <stdlib.h>

#define MENU_RUN_NUM_MODES 6

enum speed_strategy {
  SPEED_TEST = 0,
  SPEED_NORMAL = 1,
  SPEED_MEDIUM = 2,
  SPEED_FAST = 3,
  SPEED_SUPER = 4,
  SPEED_HAKI = 5,
};

enum adaptative_speed {
  ADAPTATIVE_NONE = 0,
  ADAPTATIVE_ACTIVE = 1,
};

enum filter_mode {
  FILTER_NONE = 0,
  FILTER_BIGGER = 1,
};

enum sensors_mode {
  SENSORS_ANALOG = 0,
  SENSORS_DIGITAL = 1,
};

enum run_algorithm {
  RUN_LINEFOLLOWER = 0,
  RUN_ROBOTRACER = 1,
  RUN_DRAGRACE = 2,
};

bool menu_run_handler(void);
void menu_run_reset(void);

void menu_run_load_values(void);

void menu_run_mode_change(void);
void menu_run_up(void);
void menu_run_down(void);

bool menu_run_can_start(void);
int16_t *get_menu_run_values(void);
enum speed_strategy menu_run_get_speed(void);
enum adaptative_speed menu_run_get_adaptative_speed(void);
enum filter_mode menu_run_get_filter_mode(void);
enum sensors_mode menu_run_get_sensors_mode(void);
enum run_algorithm menu_run_get_run_algorithm(void);

#endif
