OPRobots/DragonBot2/source_code/include/menu_configs.h

#ifndef __MENU_CONFIGS_H
#define __MENU_CONFIGS_H

#include <calibrations.h>
#include <config.h>
#include <buttons.h>
#include <debug.h>
#include <leds.h>

bool menu_config_handler(void);
void menu_config_reset_values(void);
void menu_config_reset_mode(void);

#endif
