OPRobots/DragonBot2/source_code/src/battery.c

#include "battery.h"

static float voltage_div_factor = VOLT_DIV_FACTOR_2S;
static float battery_full_voltage = BATTERY_3S_LOW_LIMIT_VOLTAGE;

static volatile uint16_t battery_raw = 0;
static volatile float battery_voltage = 0;

void set_battery_volt_div_factor(uint16_t version) {
  switch (version) {
    case DRAGONBOT2_A:
    case DRAGONBOT2_B:
    case DRAGONBOT2_C:
      voltage_div_factor = VOLT_DIV_FACTOR_3S;
      break;
  }
}

void battery_update_readings(uint16_t value) {
  battery_raw = value;
}

void update_battery_voltage(void) {
  float voltage = battery_raw * ADC_LSB * voltage_div_factor;
  if (battery_voltage == 0) {
    battery_voltage = voltage;
  } else {
    battery_voltage = BATTERY_VOLTAGE_LOW_PASS_FILTER_ALPHA * voltage + (1 - BATTERY_VOLTAGE_LOW_PASS_FILTER_ALPHA) * battery_voltage;
  }
}

float get_battery_voltage(void) {
  return battery_voltage;
}

float get_battery_high_limit_voltage(void) {
  return battery_full_voltage;
}

void show_battery_level(void) {
  uint32_t ticksInicio = get_clock_ticks();
  float voltage = get_battery_voltage();
  printf("Battery voltage: %.2f V\n", voltage);
  float battery_level = 0;
  if (voltage >= BATTERY_3S_LOW_LIMIT_VOLTAGE && voltage <= BATTERY_3S_HIGH_LIMIT_VOLTAGE) {
    battery_full_voltage = BATTERY_3S_HIGH_LIMIT_VOLTAGE;
    battery_level = map(voltage, BATTERY_3S_LOW_LIMIT_VOLTAGE, BATTERY_3S_HIGH_LIMIT_VOLTAGE, 0.0f, 100.0f);
  } else if (voltage >= BATTERY_2S_LOW_LIMIT_VOLTAGE) {
    battery_full_voltage = BATTERY_2S_HIGH_LIMIT_VOLTAGE;
    battery_level = map(voltage, BATTERY_2S_LOW_LIMIT_VOLTAGE, BATTERY_2S_HIGH_LIMIT_VOLTAGE, 0.0f, 100.0f);
  }
  while (get_clock_ticks() < ticksInicio + 750) {
    set_leds_battery_level(battery_level);
  }
  all_leds_clear();
}
