OPRobots/DragonBot2/(commit log)

2025-11-26 Añade pinout inicial de STMCubeMX
2025-11-26 Añade proyectos de kicad
    [chasis.kicad_pcb, chasis.kicad_sch, main.kicad_pcb, main.kicad_sch, sensors.kicad_pcb, sensors.kicad_sch]
2025-11-26 Actualiza nomenclatura de pinout
2025-12-22 Comienza a hacer el esquematico de la PCB
    [main.kicad_sch]
2026-01-10 Finaliza primera version de esquematico y comienza la PCB
    [Main-PCB.dxf, main.kicad_pcb, main.kicad_sch]
2026-02-10 Añade port de software de FujitoraBot2 y ZoroBot3
2026-02-10 Mejora guardado de calibración de MPU en EEPROM
2026-02-10 Mejora calibración y gestión de sensores
2026-02-24 Elimina la carpeta Sensors y su submodulo de custom_libraries
    [sensors.kicad_pcb, sensors.kicad_sch]
2026-02-24 "Finaliza" (CREO) la PCB main de DragonBot2
    [Sensores.kicad_sch, main.kicad_pcb, main.kicad_sch]
2026-02-24 Añade la PCB del chasis y revisa ajustes finales en la PCB main.
    [bom.csv, chasis.kicad_pcb, chasis.kicad_sch, designators.csv, main.kicad_pcb, main.kicad_sch, positions.csv]
2026-04-05 Actualiza los archivos de la PCB a la ultima version pedida.
    [main.kicad_pcb, main.kicad_sch]
2026-04-07 Añade cambios de @robotaleh para el testeo inicial de la PCB.
2026-10-06 Ajusta configuración de periféricos tras primer montaje
2026-10-06 Añade soporte a SRAM con función de prueba (comentada)
2026-10-06 Calibra encoders y añade gestión de botones MENU, SELECT y por ENCODERS
2026-10-06 Mejora gestión de menú, sensores, kinematics y mpu
2026-10-07 Actualiza systick para usar modelo de slots y empieza a preparar logging con sram
2026-10-08 Añade escritura/lectura de sram y restructuración de SysTick
2026-10-09 Añade primera aproximación a control de velocidad lineal
2026-10-09 Añade lógica básica de seguimiento de línea con logs de odometría
2026-10-09 Actualiza configuración de SPI para corregir `spi_reset` deprecated
2026-10-09 Mejora el feedback de posición inicial de línea
2026-10-11 Ajusta menú para configurar tipo de algoritmo
2026-10-12 Ajusta la succión de SPEED_TEST y activa succión en main
2026-10-12 Corrige problema con la escritura de SRAM
2026-10-12 Mejora gestión de botones por encoders y añade detección automática de color de línea
2026-10-13 Corrige bug en menu y mejora print de sensores calibrados
2026-10-15 Añade nuevas calibraciones de separación de ruedas y escala de encoders
2026-10-15 Ajusta valores de velocidades muy a ojímetro
2026-10-15 Ignora el historial local de KiCad (.history) y deja de rastrearlo
2026-10-15 Bulk commit de Extended Kalman Filter y demás cambios para Odometría - Pendiente de revisar profundamente el código generado desde DeepSeek...
2026-10-16 Organiza los logs de Odometría
2026-10-16 Añade control para evitar que al finalizar run se modifique el menú
2026-10-16 Añade nuevas calibraciones y scripts experimentales de finetunning the PID de error lineal
2026-10-18 Corrige límites de first-last index del bigger filtro
2026-10-18 Elimina warning de check_line_color
2026-10-18 Corrige prototipo de get_race_finish_ms
2026-10-18 Añade maś datos y scripts de fine tunning
